bpjagiel/Senior-Design/Concept Sketches/IMG_2075.JPG

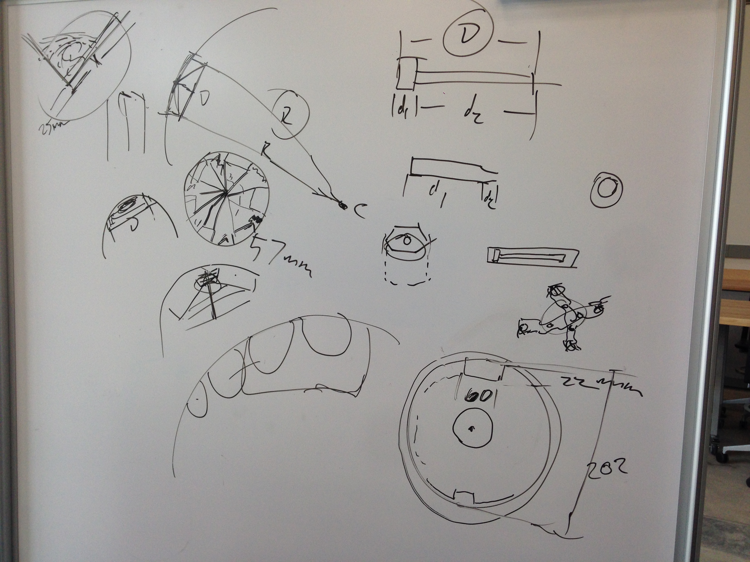
Concept Sketches/IMG_2075.JPG
