bpjagiel/Senior-Design/MechanicalDesigns/SpringCalc4.JPG

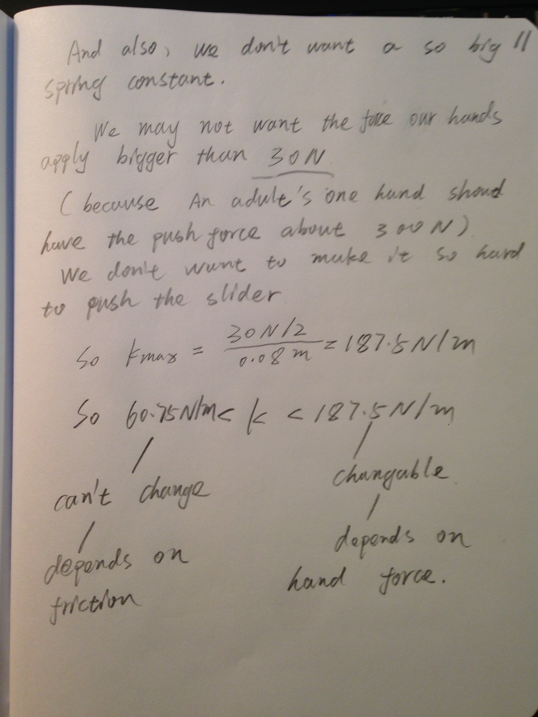
MechanicalDesigns/SpringCalc4.JPG
