bpjagiel/Senior-Design/Proposal_Presentation.pptx

## Design PRoposal

Group 2:
Paul Kruchko
Bryan Jagielo
Michael Laba
Xiaong Tong
Xinfeng Shi
Ran Ao
Monika Shaeff

## The System: An Overview

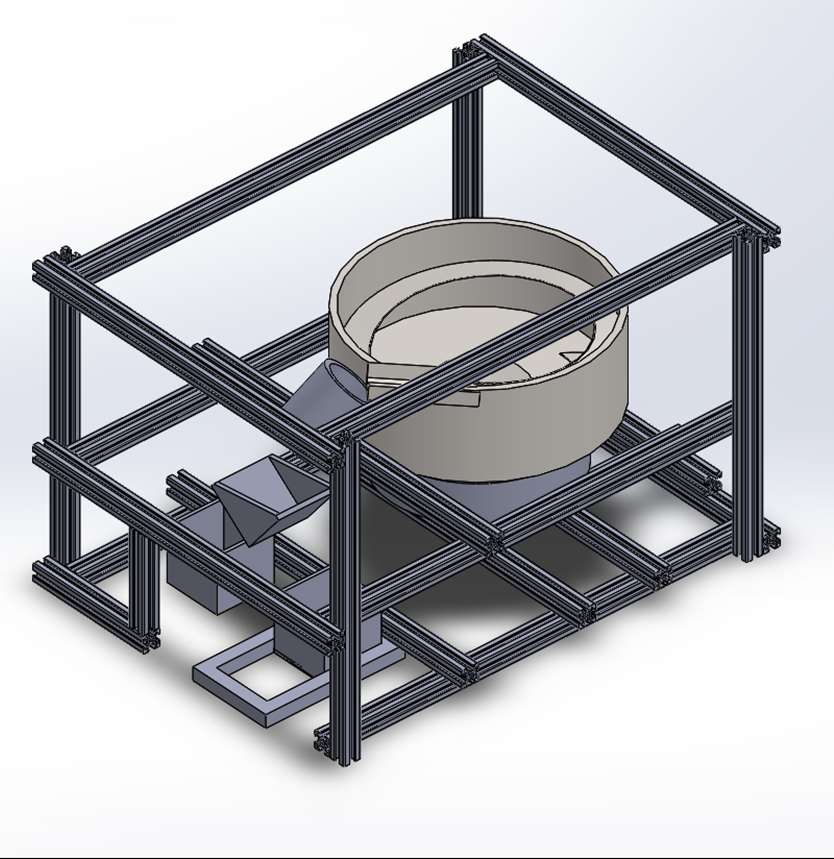
[picture p3: figure]

-> Designed around a vibratory bowl feeder
-> Through Closed-loop, feed-back control dispenses parts through a tube fitted with an array of light-sensors
-> Design inspiration:
http:// (http://www.youtube.com/watch?v=XlfjRkN1ddg)www.youtube.com/watch?v=XlfjRkN1ddg

## The System: An Overview, cont’d

F(s)

IN

Out

Parts

Hopper

Flow Limiter

Organizer

Counter/Velocity and Mass transfer

F(w,i(t))

Transducer

M(t)

Controller

Staging Trough

W,i(t)

Driver

Parts out

Dispenser

## The System: The Model

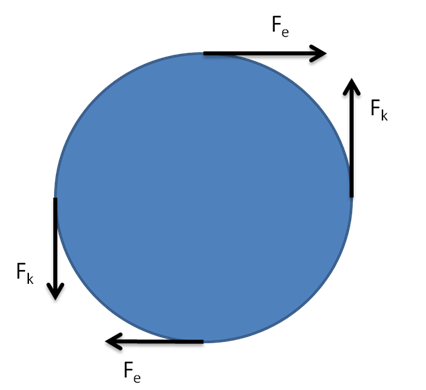
[picture p4: figure]
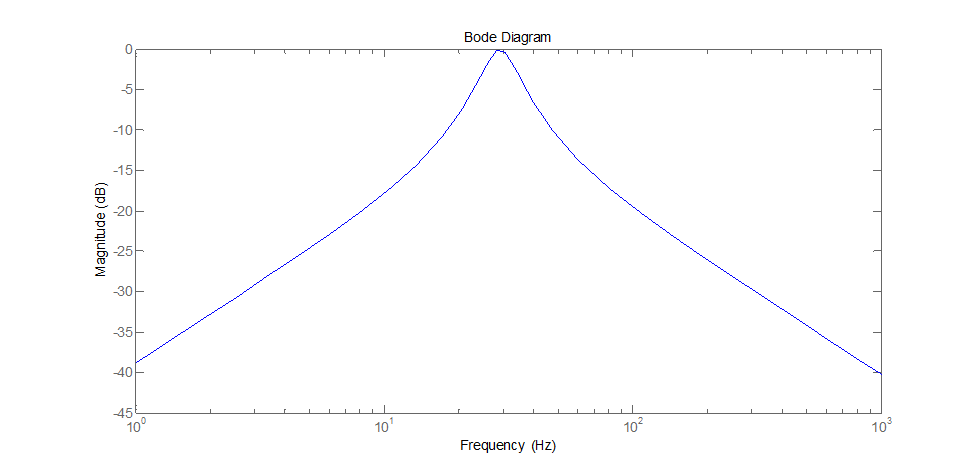
[picture p5: figure]
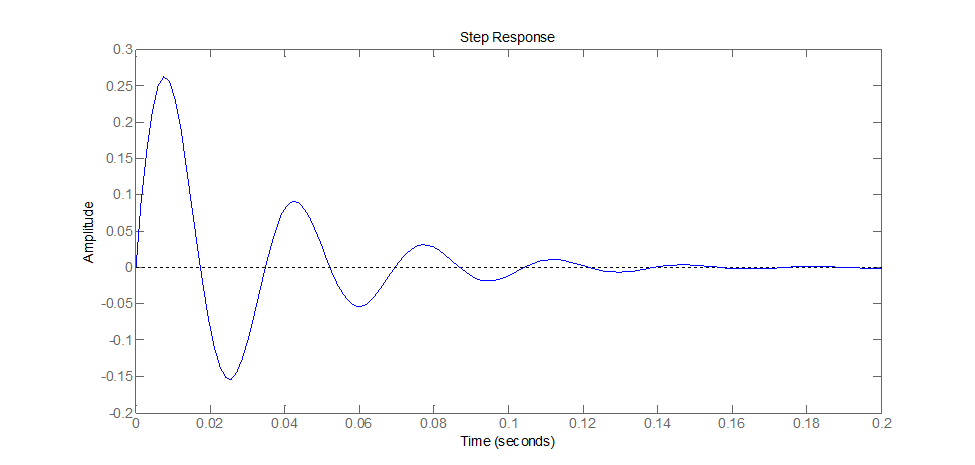
[picture p6: figure]

## The System: Implementation

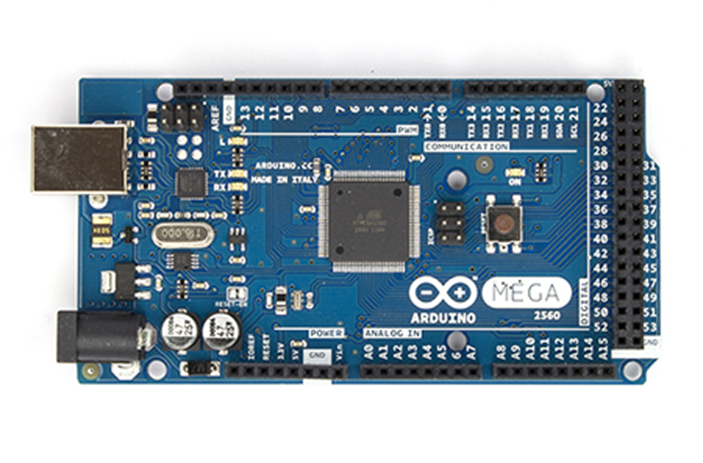
[picture p7: figure]
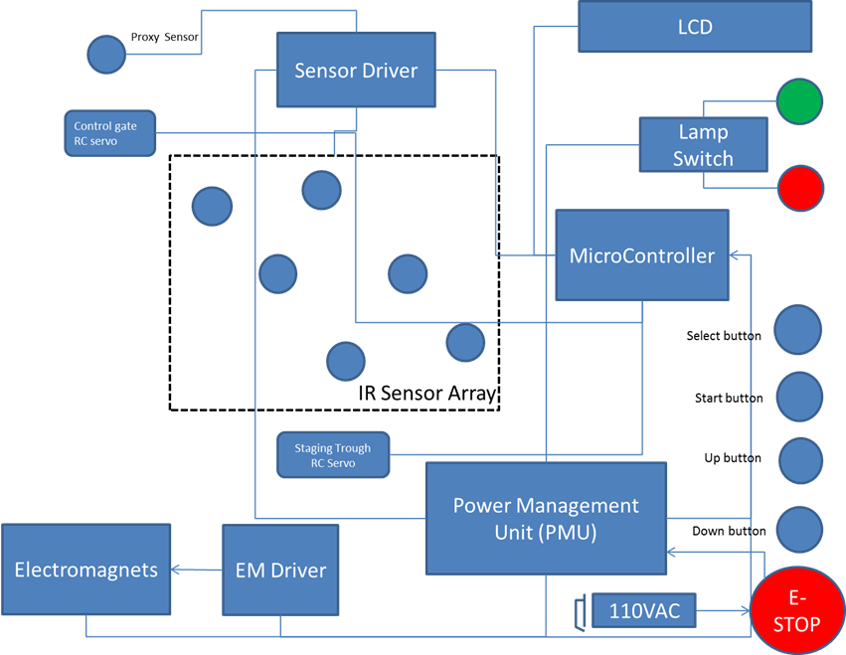
[picture p8: figure]

## Road Map: Projected Timeline

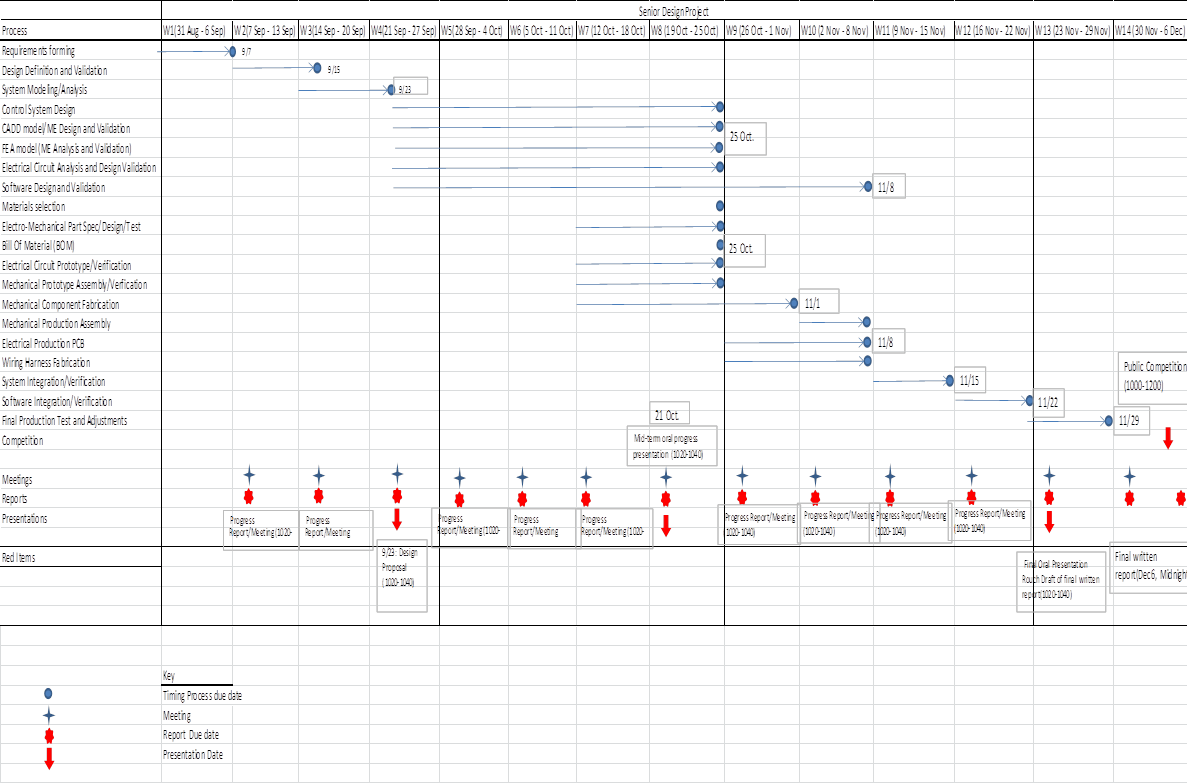
[picture p9: figure]
