bpjagiel/Senior-Design/FinalReport/standard.docx

standard：

1. IEEE Std 295-1969™- Standard for Electrinics Power Transformers

USL:http://ieeexplore.ieee.org/xpl/articleDetails.jsp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

2. IEEE Std 2600™- Standard for PROTECTION PROFILE FOR HARDCOPY DEVICES

URL: http://standards.ieee.org/getieee/2600/download/2600.2-2009.pdf

3. IEEE Std C2-1997- National Elevtric Safety Code(NESC), 1997 edition URL:http://ieeexplore.ieee.org/xpl/articleDetails.jsp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
4. IEEE Std 118-1978- IEEE Standard Test Code for Resistance Measurement USL:http://ieeexplore.ieee.org/xpl/articleDetails.jsp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
5. IEEE Std260.1-2004- IEEE Standard Letter Symbols for Units of Measurement

USL:http://ieeexplore.ieee.org/xpl/articleDetails.jsp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

# 6. IEEE Std 315-1975 - IEEE Standard American National Standard Canadian Standard Graphic Symbols for Electrical and Electronics Diagrams

# USL:http://ieeexplore.ieee.org/xpl/articleDetails.jsp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

# 7. IEEE Std 1138-2009 - IEEE Standard for Testing and Performance for Optical Ground Wire (OPGW) for Use on Electric Utility Power Lines

# USL:http://ieeexplore.ieee.org/xpl/articleDetails.jsp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

# 8. IEEE Std 1591.1-2012 - IEEE Standard for Testing and Performance of Hardware for Optical Ground Wire (OPGW)

# USL:http://ieeexplore.ieee.org/xpl/articleDetails.jsp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

# 9. UL Std 13: Standard for Power-Limited Circuit Cables

URL: http://ulstandards.ul.com/standard/?id=13&edition=3&doctype=ulstd

10. UL Std 73: Standard for Motor-Operated Appliances

URL: http://ulstandards.ul.com/standard/?id=73

11. UL Std 61010-1: Safety Requirements for Electrical Equipment for Measurement, Control, and Laboratory Use - Part 1: General Requirements

URL: http://ulstandards.ul.com/standard/?id=61010-1
