bpjagiel/Senior-Design/FinalReport/ME 492 Group2-1.docx

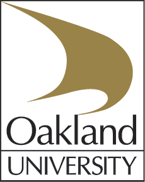
[picture p30: figure]
OU

ME 492/ECE491 – Senior Design

Group 2 - winter 2014

Final Design Report

Project Title:

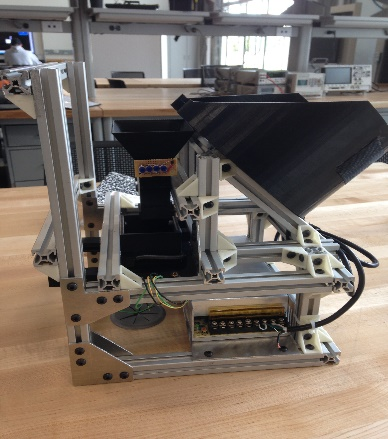
[picture p31: figure]

Professor: Dr. Latcha, Dr. Gu

Team Members: Paul Kruchko (EE), Michael Laba (ME), Bryan Jagielo (EE/CE), Xiaoang Tong (EE), Monika Shaeff (CE), Ran Ao (ME), Xinfeng Shi (ME)

Table of Contents:

1) Introduction….......................................................................................................................
2) Design Specifications...........................................................................................................
3) Design Overview….........................................................................................................
4) Mechanical Subsystem…..........................................................................................
5) Electrical/Electronic Subsystem……...................................................................................
6) Computer/Software Subsystem ……...............................................................................
7) Discussion……................................................................................................................
  a) Technical Discussion
  b) Professional and Societal Context
    i) Engineering Standards
    ii) Safety
    iii) Economic factors
    iv) Reliability
    v) Aesthetics
    vi) Potential customers
    vii) Societal impact
  c) Information Literacy
8) Conclusions and Recommendations
9) References
10) Appendices

Introduction:

  a. Description of the project challenge

The chanllenge was to produce a machine that could be used on an assembly line. The machine would be useful by helping workers count out small fasteners or parts to be assembled as the main assembly passes by on the line. The machine would be able to provide the correct number of parts each time the line worker request it. This would eliminate workers counting by hand and either coming up short on their count or taking too many parts. Extra parts tend to be discarded on the floor which is both a waste of materials and a safety hazard.

  b. Brief description of the design solution to the project challenge

The solution that we have come up with is a case feeder design that uses a bowl to hold the main part population. Inside the bowl a disk with inserts will take each part one at a time to the top of the bowl and dispense it down a funnel. The funnel is lined with sensors that will count the parts as they fall into the presentation bin. The presentation bin holds the parts until the count goal is achieved. From here the operator pushes on the slider just under the bin. This allows the parts to drop into the operator’s hand. This is how we intend to distribute our parts.

Design Specifications:

The system that Group 2 proposes is a closed-loop, feed-back, electronically controlled rotating part feeder that agitates, actuates, and organizes a set of homogenous hardware components that are to be counted and dispensed into the awaiting hands of the operator/user. There are basically four subsystems in the mechanical design: screening subsystem, transportation and detecting subsystem, dispensing subsystem, and supporting frame subsystem.

Basically, the hopper bowl, the disk, the inserts make up the whole screening subsystem. They are all printed by 3D printer to ensure high accuracy of the size. Instead of printing six different disks, different kinds of disk inserts are used to save materials. And also the bowl inserts are used to fit different parts. The hopper bowl was designed according to the total volume of the largest parts to make sure it’s big enough to hold any six kinds of materials. The diameter of the bowl was decided by the diameter of the plate (200mm), which is decided by the length of the materials. All the materials will be put into this gradient hopper bowl, and the plate at the bottom of the bowl will begin to rotate driven by the motor, and also the agitators will begin to stir the parts. The parts inside the bowl will fall into inserts under the influence of gravity and the agitation. When the single part is rotated onto the higher side of the plate, all the parts will drop through the gap one by one, and here the singulation of the parts are completed.

For the transportation subsystem, there is a funnel with sensor inside it. The parts will drop into a funnel one by one, and the eight pairs of IR sensor on two levels can count the part that goes through. When it count to the quantity the user needed, the feedback control will apply to stop the motor. The upper size of the funnel is bigger than the lower size to avoid getting stuck, and also the slop is smooth enough. According to the parts quantity the user need, there will be a motor speed control to speed up the rotation or slow it down. This control will make sure we can transport enough parts in a certain time. After careful examination of the system’s static and dynamic characteristics it was determined that a motor with a minimum torque output of 20oz.-in. would be sufficient. Given that the there is considerable torque loss in the shaft of any given motor (~10%) and the need to both observe and control the speed of the motor it was determined that the 131:1 gear motor offered by Pololu was a desirable material solution for the motoring needs of the system. This motor offers 250 in-oz. of torque at 80 rpm, giving a safety factor of 12.5 and an encoder resolution of 64 counts per revolution, creating enough sample for an adequate velocity measurement. Control can be performed by implementing a PID controller in software on the microcontroller to control velocity output for desired velocity state or an integrated motor controller can be purchased that controls the motor with only a simple command from the microcontroller controlling the rest of the system. Given allocated memory and system response time it might be desired to control the motor using a motor controller.

For the dispensing subsystem, there is a push slider and a presentation. After we get the right number of parts, the motor will stop rotating and the certain parts will be inside of the dispenser. Two springs with proper spring constant are on the dispenser, which can make it go back to the original position after the user push and get the parts.

For the supporting frame subsystem, the frames are utilized to hold up all the mechanical and electronic components. The cross section of the frame is 20mm×20mm, and the material is aluminum alloy to ensure that it’s strong enough to make the whole setup steady. The frames are fixed together by the joints, which are printed by 3D printer.

Design overview

In order to discribe the overview of the mechancical system. We first looked at existing machines in industry and broke down what made them successful.

After examining a few machines we came to up with the following flow chart which each part followed in order to be acuratly organized, counted and moved from a major parts group. We would encorporate the same ideas into our design in order to make it successful

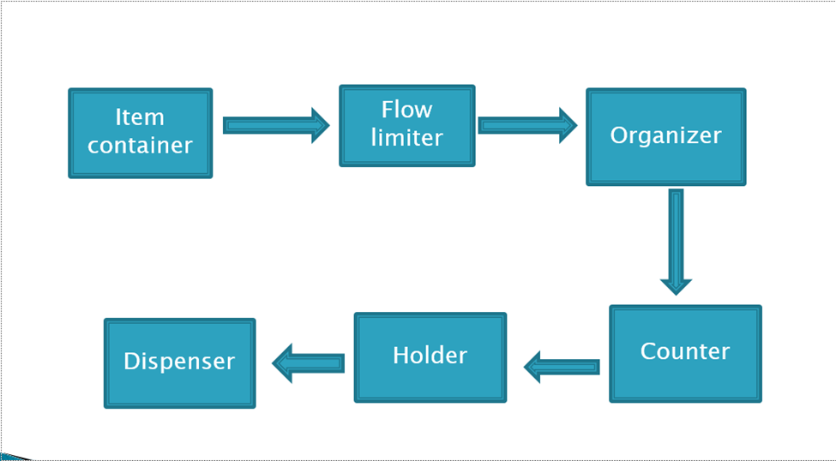
[picture p32: figure]

As seen in the above flowchart, the main population had to be first contained. Then the machine had to have some way of initiating the parts to move. Most machines used motors or agitators to create a mass flow from the major population of parts in the machine. The parts then are organized by geometry and orientation from the main material flow. Any part that did not match the orientation or the requested geometric restraints, was rejected back to the major population. This allows for a controlled flow of parts to feed one at a time into the counter. As parts move past the counter, the machine keeps track of how many are going to be dispensed, what the count is and how many parts are left in the bowl. The parts then move to a holder. In the holder, orientation may or may not matter depending on if orientation needs to be held for later processes. In our case we did not need to hold any particular orientation as long as all the parts where contained in the holder. The holders main job is to hold the current count of parts to be dispensed. This is to ensure that the operator is to get all the parts at once out of the dispenser, instead of parts coming out one at a time. The final piece is the dispenser itself. Each machine needed a way of presenting or releasing the held parts to the operator.

We needed to control aspects of the mechanical side, so we made a second chart that would work with the mechanical flow to ensure control to the machine.

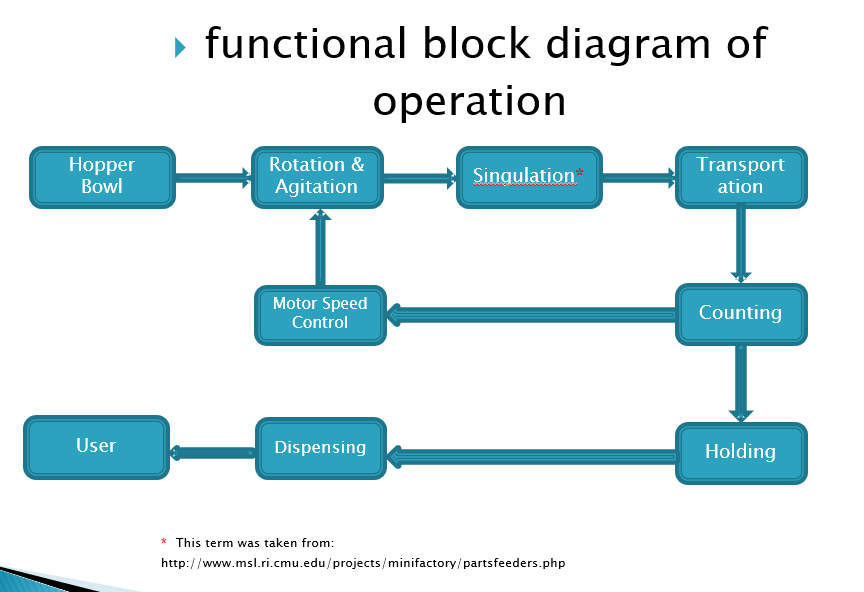
[picture p33: figure]

Each section in the diagram above was a strategy used in controlling the number of parts and part flow within the machine. The microcontroller would have feedback from sensors in the funnel and dispensing bin to control the motor speed and ultimately the part flow within the machine. This would mean that we could control the on time delivery of each count, know how many parts have been dispensed, how many parts are in the machine, and most importantly, how many parts are in the count. The microcontroller would have the ability to do the following: allow for user to select part type, count, control motor speed, keep track of parts in the machine, alert the operator when the parts are ready to dispense and start the count again after the operator retrieves the parts.

Mechanical Subsystem:

The mechanical subsystem is all pieces or parts of the machine that provide support or function to the machine. Each part of the machine had to be selected or made with both function and the ability to be assembled in mind.

Our first Idea came from industry as a vibration bowl. The idea was that the bowl would be agitatied and acutated such that parts would pushed by friction and solenoid, around the bowl and up a spiral ramp. While moving to the top of the bowl, we could use limiters to orient the parts as they formed a single file line. We quickly realized that the amount of calculations to achieve the forces needed to vibrate the parts would be very difficult.

After more research, we considered two more Ideas. One used conveyor belts and limiters for part flow and the other used a set of rotating disks with slots to pick up parts one at a time and dispense them at the top of the bowl. We chose the case feeder design with the bowl and disk, due to it being less complex, having components that could be easily calculated and we that the fabrication would not be too difficult.

To hold the main population of parts on the disk and agitator, we knew our bowl had to have a volume that would hold the largest part volume but not completely fill the bowl. We also knew that the bowl would have to be able to move the longest screw. These dimentions influenced both our bowl size and slot dimentions at the top of the bowl and on the disks.

Originally we had hoped that we could print the bowl as one piece and the first bowl contained more ABS than what was nessasary. A 3-D printer was expected to be used to make the bowl to ensure persision and because the printer would be able to fabricate our shape and eliminate extra fabrication processes with some other materials. The only thing the printer needs is material which is where the cost for making the parts is incurred. We first tried to eliminate some of the ABS material from the bowl by making the motor hole in the bowl wider. This changed or original plan to mount the motor directly to the bowl which would have made centering the motor shaft and assembly easier. We still had a high ABS volume for the bowl, so to reduce the volume.

During the mechanical process, we have utilized 3D printer for printing some of the major components of the machine. The material of these components is ABS, and the friction factor between ABS is 0.1. The tolerance of the printer is 0.2mm, so we need to consider the tolerance when designing the size of the components.

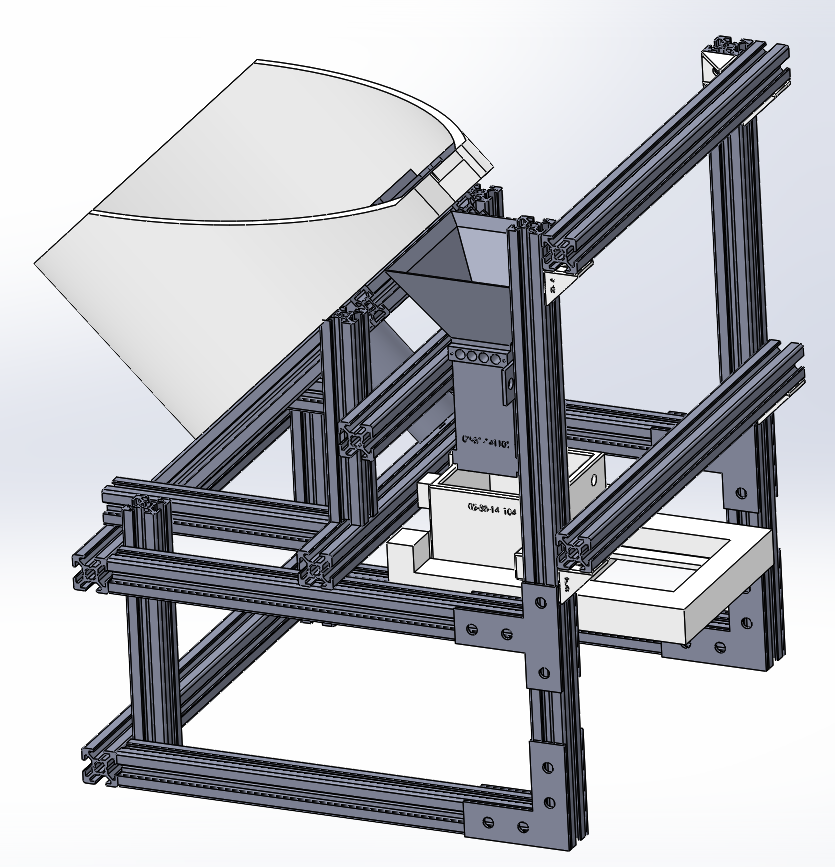
[picture p34: figure]

Figure 1. Built Machine Figure 2. Finalized CAD Model of Machine Concept

Our finalized machine design is shown above in figure 1 and 2. As shown above, about fifty unorganized parts will be dropped into the bowl. The motor that is fixed on the frame will rotate a wheel inside the bowl. Depends on the types of the parts, different wheel and different inserts of the bowl will be utilized. The unorganized parts will be rotated into the gaps of the wheel, and sent to the top of the bowl. Then they will drop into the funnel through a big gap on the top of the bowl. There will be eight pairs of IR sensors, which attached on the side of the funnel, waiting for detecting the number and speed of the parts. After controlling the speed and the number of the parts, the rotating process will stop, and the correct number of parts will drop into the presentation bin. The waiting hand can easily push the slider that underneath the presentation bin, and receive the parts when the machine is ready.

The size of the total design including both mechanical and the electronical stuff is 270mm×300mm×350mm . Because we fixed everything together on the stable frame by proper size of screws and nuts, the whole machine is easy to carry and move.

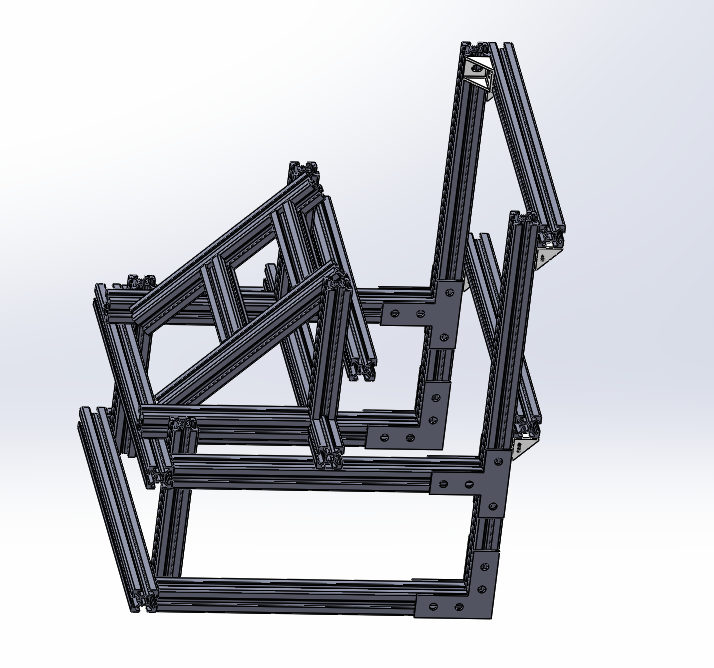
[picture p35: figure]

Figure 3. The Supporting Frame for the Total Design

The figure above shows the frame design of our machine. After the roughly drawing the outline of each component, we thought about the method to connect each component. It will be more delicate and easily to use if we can figure out a proper way to hold the whole machine. According to the mechanical and electrical components, we utilize the 8020 Aluminum alloy. It is bought from…. We cut it into different size, and put them together by utilize the proper fastener. Each component is fix one frame by using the nuts and screw. If there is any part that needs to be changed, we can easily change the position, length and angle between the beams, and mount the screw at the proper place that we want.

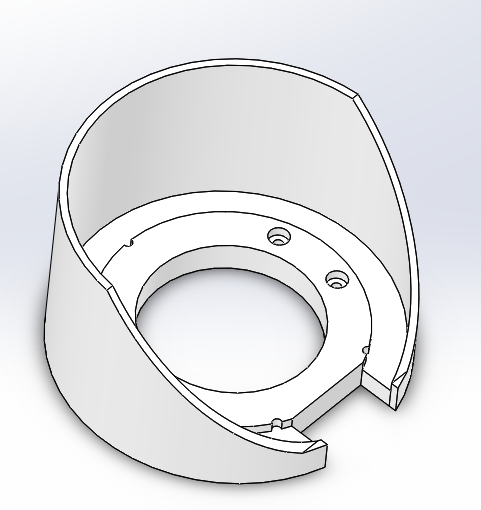
[picture p36: figure]
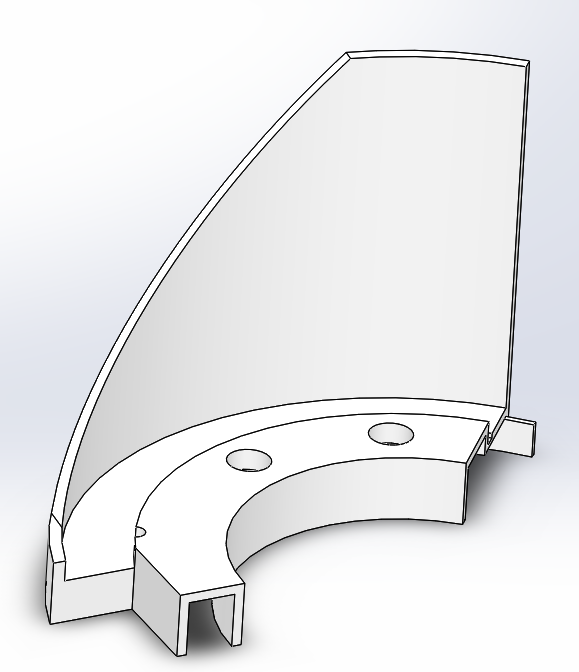
[picture p37: figure]
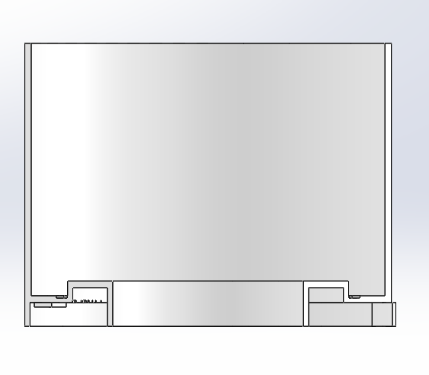
[picture p38: figure]
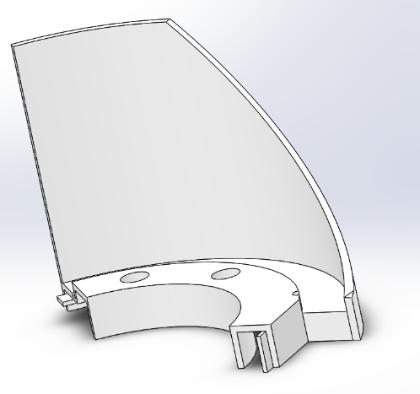
[picture p39: figure]

Figure 3. The Bowl and the Three Divided Parts of the Bowl That Used for Printing.

The figure shown above is the bowl. It is held up on the frame with an angel of 45 degree. The bowl is utilized to hold the bowl inserts, wheels and all the unorganized parts. Also, there is a cuboid gap on the side of the bowl, and the size is big enough for carrying all six types of parts. It allows the parts dropping into the funnel. The internal diameter of the bowl is 202cm, and the thickness of the wall is 4mm. For saving the cost of the bowl, we cut off a lot of material from the bottom. Because the bowl was not in a regular shape, we decided to use 3D printer. The size of the bowl was larger than the capability of the printer, so we printed it by dividing it into three parts. Then the left, center, and right part of the bowl were glued together. The glued bowl was firm during the test, and never tried to break apart.

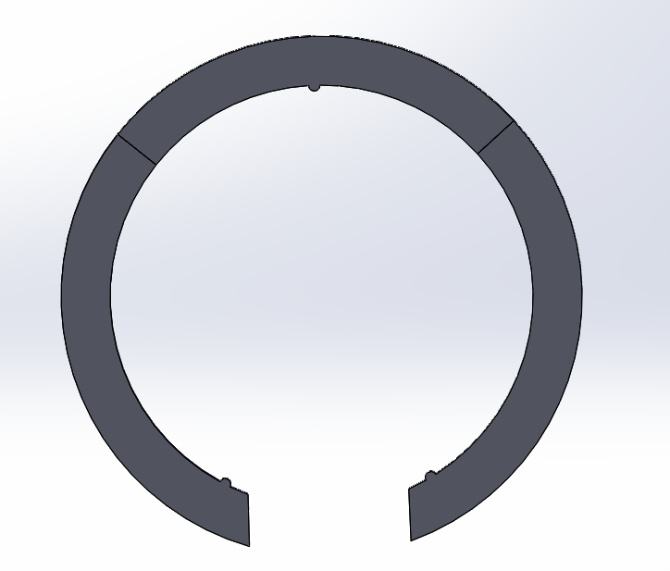
[picture p40: figure]

Figure 4. The Inserts of the Bowl

As shown above, the shape of the bowl inserts is same as the shape of the gap inside the bowl. The three small semi-circle are used to fix the position of the inserts. In this case, the rings will not move randomly inside the boal gap. Because the thickness of six parts are different, we have designed four different thicknesses of the rings including 6mm, 4.5mm, and . Then the thickness of the gap can be changed by easily putting the rings in. The size of the ring is larger than the capability size of the printer. Since we used 3D printer to print ABS material inserts, we divided each one into three part.

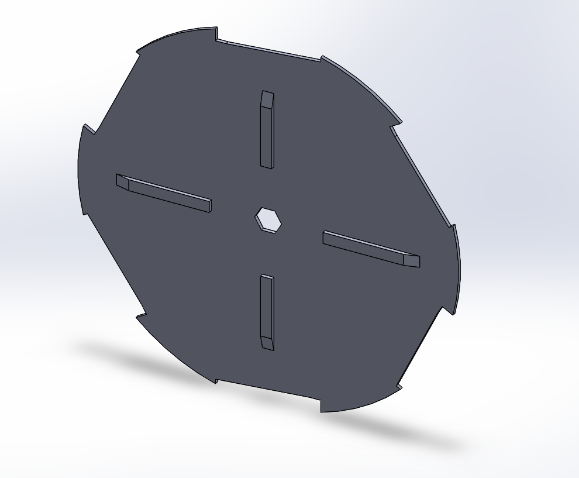
[picture p41: figure]
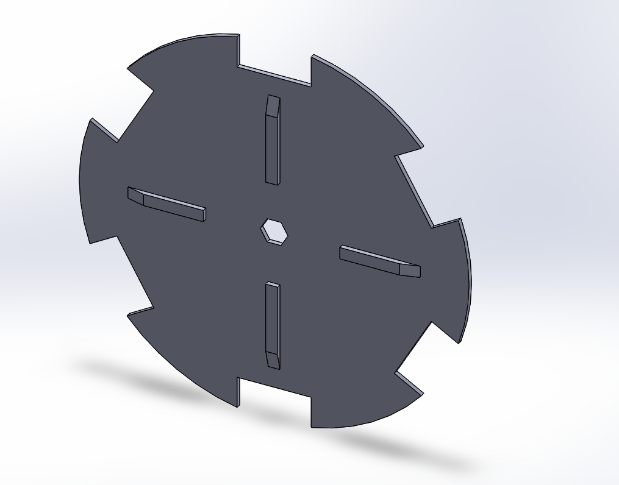
[picture p42: figure]
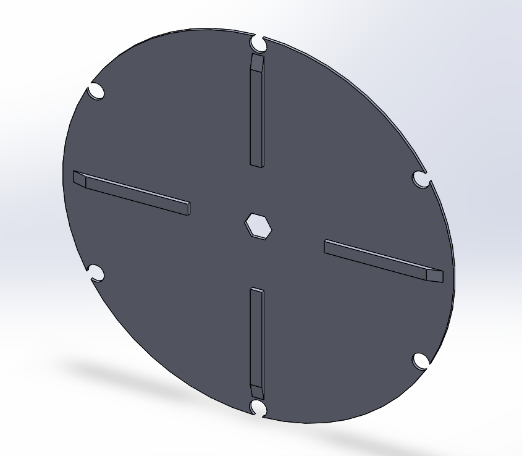
[picture p43: figure]
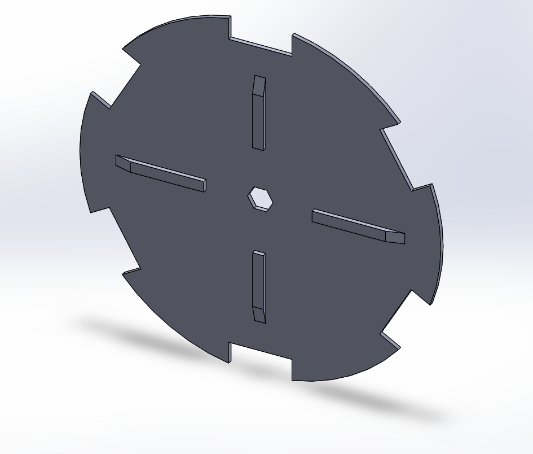
[picture p44: figure]
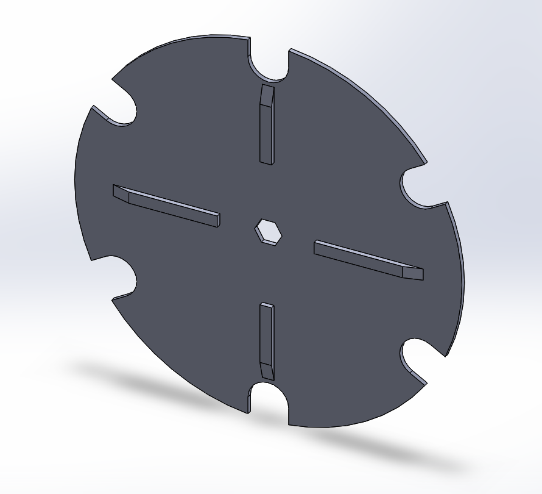
[picture p45: figure]
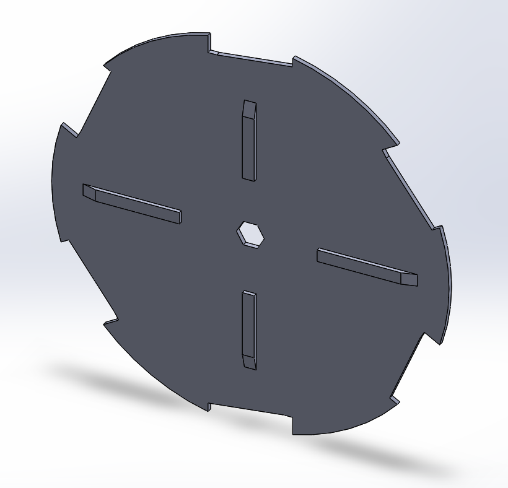
[picture p46: figure]

Figure 5. Six types of wheels

The figure shown above is the wheels for each parts. As we know, there are six kind of parts that might be sorted. The inserts of the bowl can used to change the thickness of the gap, and the wheels can change the outline shape of the parts. Because we don’t need to care about the thickness when designing the wheel, the thickness of the wheels are 2mm. Thus, we save a lot of material by printing the thin wheels. There are four agitators on each of the wheels. It is used to stir the parts. Because there are about fifty parts that need to be organized, it is important to make them apart, and they can easily drop into the gaps. All the six wheels are printed by 3D printer. Also, the shaft will be attached to the middle of the wheel in order to send the power for rotation process.

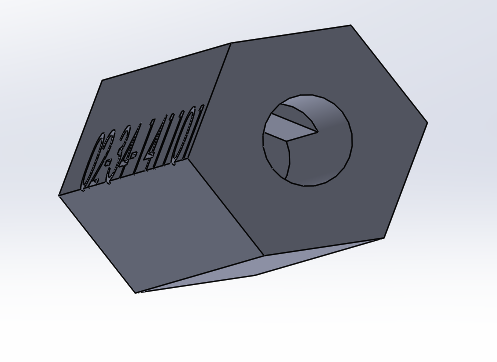
[picture p47: figure]

Figure 6. The shaft

The shaft is used to connect the motor and the wheel. Since the hole of the shaft is designed according to the size of the motor, the motor can easily attached to the hole of the shaft. Then, we super glued the shaft and motor, and the shaft will be more stable. The external shape of the shaft can just fit into the wheel. In this way, the wheel can rotate in the same rotational speed while the motor rotating, and the motor can easily control the rotating process of the wheels. The shaft is built by 3D printing.

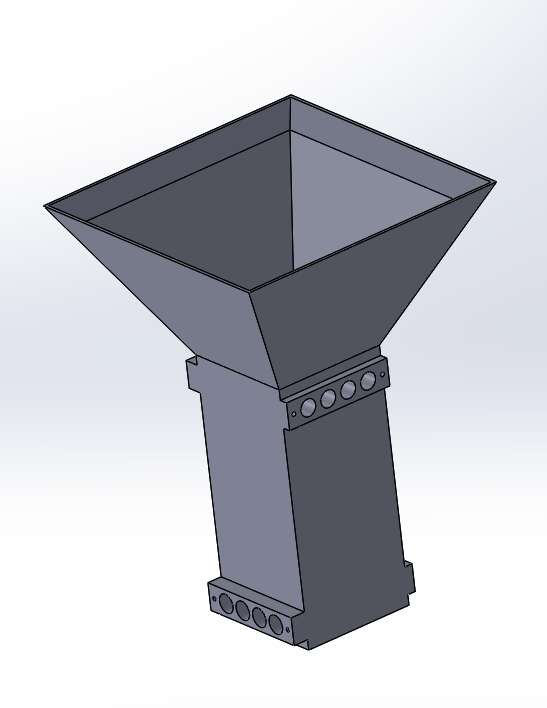
[picture p48: figure]

Figure 7. Funnel

The funnel with IR sensors is an important part to counting the number of the parts. As shown above, the upper part of the funnel is right below the gap of the bowl, and the size of the entrance is enough for all the parts to drop in. Then the parts will be detected by the sensors. Eight pairs of sensors are attached to the hole of the funnel in two level. Once the part is detected, the electronic screen will add the number, and the motor will receive the feedback of the speed. In this case, the motor can better control the speed of machine. In order to cut accurate size of the sensor hole, we printed funnel by 3D printer.

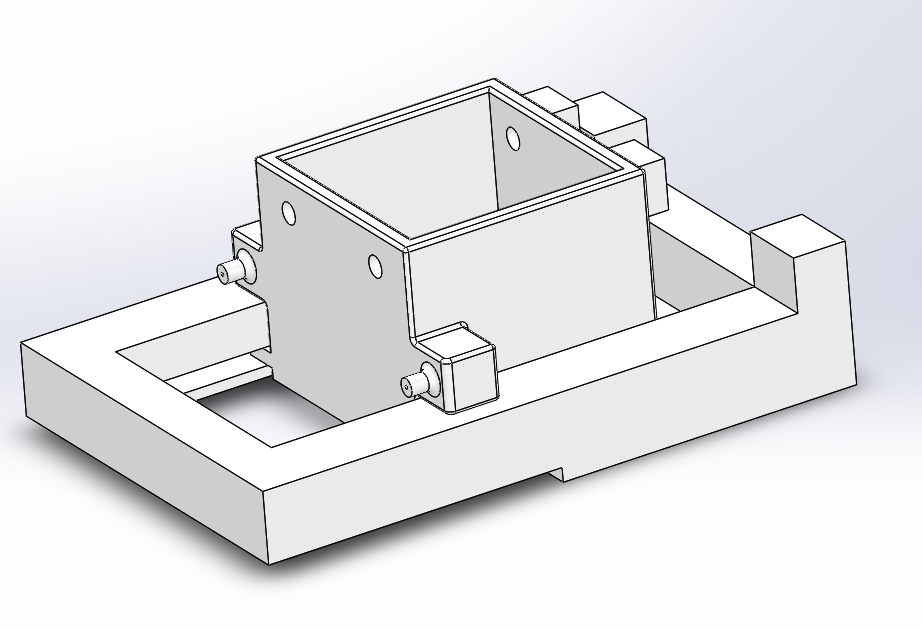
[picture p49: figure]

Figure 8. Presentation bin and push slider

As shown above, the parts will drop into the presentation bin after going through the funnel. When the machine is ready, the machine will stop rotating, and the correct number of parts will be stored in the presentation bin. Then, the awaiting hand can easily push the slider underneath, and receive all the needed parts. Both presentation bin and push slider are made by 3D printer, and the material is ABS plastic. The presentation bin is fixed on the frame, and it holds the slider as while. In order to connect presentation bin and slider, and control the position of the push slider, there are two springs on the each side of the dispenser. In this way, the spring will extend when the push slider is pushed, and the spring can pull the slider back to the normal position when the force disappears.

Electrical Subsystem

Computer Subsystem

Discussion:

Our final design solution is greatly different from our original design. The original design was made with only functionality in mined and did not take into effect cost, assembly, and control of part size on certain components. The original presented design was made crudely to allow for the original ideas to take shape and preform initial testing based off theory or software.

As we analyzed the idea of price and making parts fit together. It was found that making parts that used thin ABS printed parts where cheaper than our original parts. We became more comfortable with working with ABS after we tested the prototyped design for a 90 corner bracket. The idea for this design was altered from working aluminum brackets for sale on the web at Mcmaster-Carr.com or 80/20.com The brackets used gussets to strengthen the joint. Some used multiple screw locations to stiffen the joint and increase contact area. Since our machine weight is ____ pounds, we felt that with multiple applications of a smaller light weight bracket could be used to have high strength with minimal space. We also removed tabs that fit into slotted sections of the 80/20. This allowed us to use our bracket for a wider range of applications including parts on an angle, which the shelf bought brackets would not be able to do.

In order to ensure that this application would work, we tested the bracket design. A small sample of 10 90 corner brackets was printed in order to test the bracket design strength. In order to get an idea on how the bracket might perform, we used FEA from Solidworks. By comparing an FEA with 1N applied to a mounting face and the other mounting face fixed, we could predict the deflection of the part under loading. This could be compared to the test results in order to estimate how the brackets will perform.

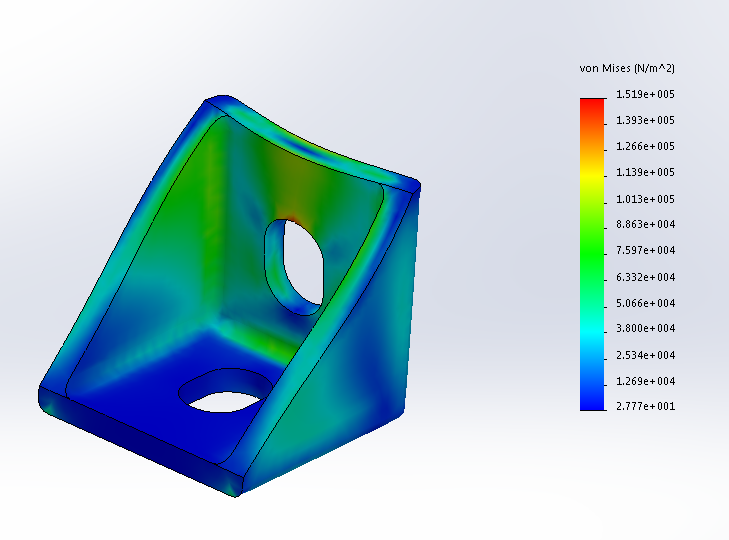
[picture p50: figure]

To conduct the expiremtent, four brackets where secured to a 2x4 using Philips head sheet metal screws. The brackets where up and down in orientation and attached to the edge of the 2x4. The 2x4 was then clamped to a table using a C-clamp to prevent it from moving off the table. By two hooks and string, weight was applied to each of the brackets. The weights had known measurement labels. This test did not need to be very precise, due to the predicted weight that one bracket was to lift was appoximently 5 lbs. The test was stopped at 22 lbs because the part was deformed, there was no need to go higher when only 5 lbs was a comfortable working weight of the machine and the design has multiple double brackets applied at the joints.

Group Two 19
