bpjagiel/Senior-Design/Proposal/H-Bridge.docx

To control the torque of the motor, a specific motor driving circuit is necessary. The figure below depicts the schematic for the motor driver circuit. The designed circuit is a N-MOS H-bridge which will allow the motor to be driven in both directions if necessary. Current to the motor can be applied by toggling the microcontroller pins connected to the four respective MOSFETs. Furthermore, a pulse width modulated signal can change the amount of power sourced to the motor which will change its respective torque. The circuit also contains protection diodes that will prevent the MOSFETs from receiving back current produced by the motor when the transistors are abruptly switched to stop the current. Using this circuit in conjunction with the control system detailed in a separate section will allow for precise control of the system.

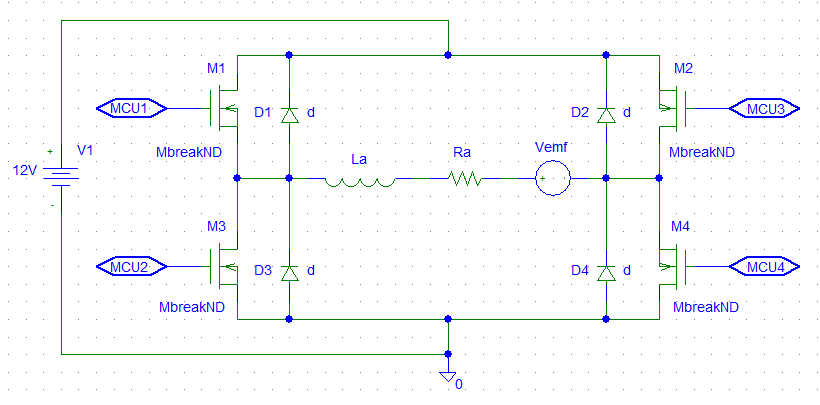
[picture p69: figure]
