bpjagiel/Senior-Design/Proposal/systemdynamicsEQ.docx

To control the angular speed of the plate in the bowl, the physics of the system can be modeled and a control system can be implemented. Analyzing the rotation of the plate about the axis of the rotor of the DC servo motor, the equation of motion can be actualized as the sum of torques written as follows:

∑ τ=Jθ

where J is the moment of inertia of the plate and parts system and θ is the angular acceleration. Recognizing that the torques acting on the plate consist of the input torque, τ_m , from the electric motor and the viscous friction between the plate and the bowl, τ_f , the equation of motion can be rewritten to contain these terms. The equation of motion now reflects the following expression:

τ_m -τ_f =Jθ

The viscous friction term can be expressed as:

τ_f =bθ

where b is the viscous friction coefficient and θ is the angular velocity. Substituting the expression for viscous friction, the equation of motion can be rewritten again as followed:

τ_e -bθ=Jθ

To prepare the equation of motion for modeling in MATLAB, the equation can be rearranged to solve for the angular velocity. Rearranging yields the expression:

θ=1/Jτ_e -b/Jθ

With the equation of motion in the form necessary for state space representation, the state space variables can be declared as follows:

x_1 =θ , x_2 =θ , u=τ_e , y=θ

Using these state space variables, the state space representation can be determined. The state space matrices can be written accordingly:

[x_1 x_2 ]=[0, 10, -b/J][x_1 x_2 ]+[01/J][u]

[y]=[0, 1][x_1 x_2 ]

As can be noticed from these expressions, the input will be the torque from the motor and the output will be the angular velocity of the plate. The torque from the motor can be adjusted using pulse width modulation and the motor driver circuit described in detail in a separate section. The angular velocity of the plate will be monitoring using a rotary encoder and will provide effective feedback to the system.

In addition to modeling the physics of the system, an appropriate control system can be developed to control the DC servo motor. Below, the independent DC servo motor controller will be implemented to ensure the motor will produce the desired torque in order to maintain the optimal angular velocity for the plate.

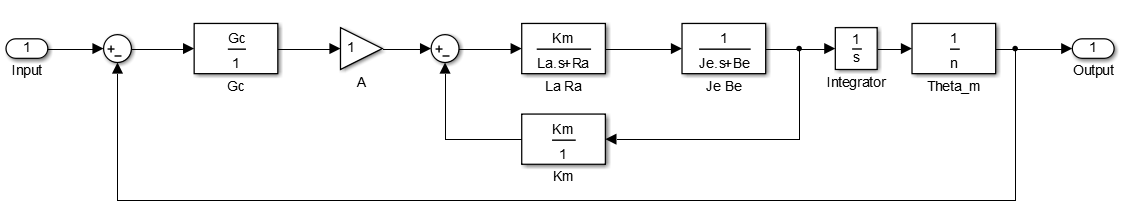
[picture p76: figure]

The control system will need the appropriate constants for the motor. In particular the armature resistance, R_a , and armature inductance, L_a , and motor constants, J_e and B_e will be measured or obtained from the selected motor’s data sheet. As a result, fine tuned control of the motor and rotating plate will be achieved for precise delivery of the desired quantity of parts in the appropriate time window.
