bpjagiel/Senior-Design/Software/PinOut.pptx

BUTTONS

LCD

SENSORS

STATUS LEDS

MOTOR DRIVER

DISPENSE SENSOR
