bpjagiel/Senior-Design/Motor/MotorModelDerivation.docx

Base equation of rotational motion:

τ_e -τ_b -τ_J -τ_L =0

τ_e =k_t i_a

τ_b =bω

τ_J =Jω

Note: To translate the motor torque, viscous friction coefficient, and rotor moment of inertia, these terms must be multiplied by the gear ratio.

Exact equation of rotational motion:

k_t i_a -b_e ω-J_e ω-τ_L =0

Solving for ω :

ω=(k_t)/(J_e)i_a -(b_e)/(J_e)ω-1/(J_e)τ_L

Base equation of electrical circuit:

V_a -V_(R_a) -V_(L_a) -V_c =0

V_(R_a) =i_a R_a

V_(L_a) =L_a i_a

V_c =k_v ω

Exact equation of electrical circuit:

V_a -i_a R_a -L_a i_a -k_v ω=0

Solving for i_a :

i_a =-i_a (R_a)/(L_a)-(k_v)/(L_a)ω+1/(L_a)V_a

Recap:

We have the two equations solved for i_a and ω :

i_a =-i_a (R_a)/(L_a)-(k_v)/(L_a)ω+1/(L_a)V_a

ω=(k_t)/(J_e)i_a -(b_e)/(J_e)ω-1/(J_e)τ_L

We can select the state space vectors as the following:

x=[i_a ω] , u=[V_a τ_L ]

We can write the state space equations as the following:

x=[-(R_a)/(L_a), -(k_v)/(L_a)(k_t)/(J_e), -(b_e)/(J_e)]x+[1/(L_a), 00, -1/(J_e)]u

y=[0, 1]x+[0, 0]u

Inputting this model yields the following response to a 6V input voltage and a 0.14136 Nm load torque due to friction:

The top plot represents current versus time while the bottom represents angular velocity (in rad/s) of the plate versus time.

Since we will power the motor with a pulse width modulated signal, a constant gain will be used to link the duty cycle with the equivalent DC voltage of the signal. To validate this assumption, the model was simulated with a 12V, 50% duty cycle input signal, which would have the same equivalent voltage as above.

The top plot is current versus time while the bottom plot is angular velocity (in rad/sec) of the plate versus time. As can be seen, the pulse width modulated signal produced approximately the same steady state angular velocity as the constant 6V signal.

After implementing the PWM block, we can also implement a PID speed control to achieve speed control. The final control system would look like below:

Where the input is the desired angular velocity and the output is angular velocity both in (rad/sec). A simulation of the system is below:
