bpjagiel/Senior-Design/WeeklyStatusUpdates/Week6.pptx

## Group 2 Project Update: Week 6

Paul Kruchko-Project Manager
Mike Laba-ME Design Lead
Bryan Jagielo-EE Design Lead

Group2

## ME Design Status

- Simulation: Correct motion with 5 fasteners
- Initiated FEA for dispense box
- 4 of 6 actuator plates finished
- Machine frame design complete
- Initiated mounting considerations of electrical components and motor
- Constant for return springs of slide-dispense mechanism determined to between 60.75 and 187.5 N/m

## ME Design TODO

- Full motion simulation study with 50 pieces of every type of fastener to be dispensed (6 simulations for 6 fastener types)
  - Who: Mike
  - When: Complete by Sunday, 12 Oct.
- Finish FEA of dispense box & slide mechanism
  - Who: Mike
  - When: Complete by Sunday, 19 Oct.
- Exact P/Ns and quantity needed for 80/20 machine frame hardware given to Project Manager
  - Who: Mike & Audrey
  - When: Complete by Sunday, 12 Oct.

## ME Design TODO, cont’d

- Total baseline volume of ABS material needed
  - Who: Mike & Audrey
  - When: Complete by Sunday,12 Oct.
- More accurate mass moment of inertia for load
  - Who: Steven
  - When: Complete by Sunday, 12 Oct
- Finish last two actuator plates
  - Who: Audrey
  - When: Complete by Thursday, 9 Oct
- Complete HMI panel design
  - Who:

## EE Design Status

- Preliminary Sensor design complete
- Microcontroller purchased, ready for prototyping
- Preliminary code structure complete: State machine

## EE Design TODO

- Finalize motor selection
  - The current motor selection was scrapped in favor of a vendor that was able to give a more complete datasheet with motor specifications and coefficients needed for accurate system model: Pittman.
  - Motor is still comparable to previous selection in regards to torque, speed, and encoder availability
    - Who: Paul
    - When: Complete by 11 Oct

## EE Design TODO, cont’d

- Finalize system model with coefficients and perform MATLAB/Simulink simulations for frequency response, step response, impulse response.
  - Who: Paul & Bryan
  - When: Complete by 12 Oct.
- Finalize motor selection with mechanical mounting specifications for ME team
  - Who: Paul
  - When: Complete by 11 Oct
- Finish Design and Prototype Sensor circuit, present mechanical mounting specifications to ME design team
  - Who: Terry & Monika
  - When: Complete by Sunday, 12 Oct

## EE Design TODO, cont’d

- Selection of push buttons and LCD with prototyping
  - Who: Monika and Terry
  - When: Complete by 19 Oct
- Design and Prototype power supply circuit
  - Who: Paul
  - When: Complete by 25 Oct
- Design digital motor controller to be implemented in code
  - Who: Paul and Bryan
  - When: Complete by 25 Oct

## Project Status Summary

- System development is on schedule. End design phase target is still 25 October
- Initial motion simulations are promising and verify the major function of the gravity assisted design
- Final BOM and purchasing of components and material also on target for 25 October.
