bpjagiel/Senior-Design/ControlSystemAnalysis/SystemModelAnalysis.docx

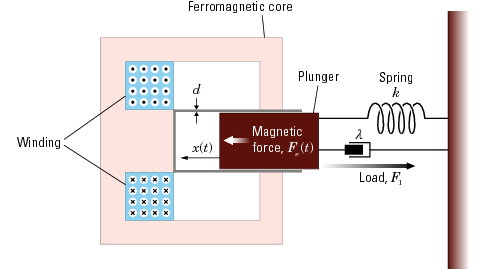
[picture p115: figure]

Equation of motion for the plunger:

F_o +mx+λx+kx=F_e

Since, F_o

Magnetic Force:

F_e =1/2i^2 (∂L(x))/(∂t)

Change in inductance w.r.t. time:

(∂L(x))/(∂t)=(-β)/((α+βx)^2)

Magnetic Force with solenoid constants:

F_e =1/2i^2 (-β)/((α+βx)^2)

The solenoid constants, α and β, can be solved by taking two force and stroke measurements and solving the expression.

The rotational motion of the bowl feeder can be written as the torque:

τ_(out) =Iα

The angular acceleration can be written:

α=x/r

So rewriting yields:

τ_(net) =I/rx

To find the force needed to create this torque on the bowl, the torque can be written as the product of the force and the radius from the axis of rotation:

τ_(net) =rF_o =I/rx

Solving for the force yields:

F_o =I/(r^2)x

Substituting this expression into the overall equation of motion:

I/(r^2)x+mx+λx+kx=F_e

Simplifying:

(I/(r^2)+m)x+λx+kx=F_e

Solving for x :

(I/(r^2)+m)x=F_e -λx-kx

x=1/(I/(r^2)+m)F_e -λ/(I/(r^2)+m)x-k/(I/(r^2)+m)x

Defining state space variables, x_1 ,x_2 and u :

x_1 =x

x_2 =x

u=F_e

Substituting state space variables into equation of motion:

x_2 =1/(I/(r^2)+m)u-λ/(I/(r^2)+m)x_2 -k/(I/(r^2)+m)x_1

[x_1 x_2 ]=[-0, 1k/(I/(r^2)+m), -λ/(I/(r^2)+m)][x_1 x_2 ]+[01/(I/(r^2)+m)][u]

y=[0, 1][x_1 x_2 ]
