bpjagiel/Senior-Design/Group2/Presentations/MidTermPresentation.pptx

## Group 2 Project Presentation: Mid-Term

Group2

Paul Kruchko- EE-Project Manager
Mike Laba-ME Design Lead
Bryan Jagielo-EE Design Lead
Monika Shaeff-CE
Ran Ao – ME
Xiaong Tong – EE
Xinfeng Shi - ME

## Introduction: Our Product

- Rotary Parts Feeder
  - Inspiration for our design: bullet case feeder

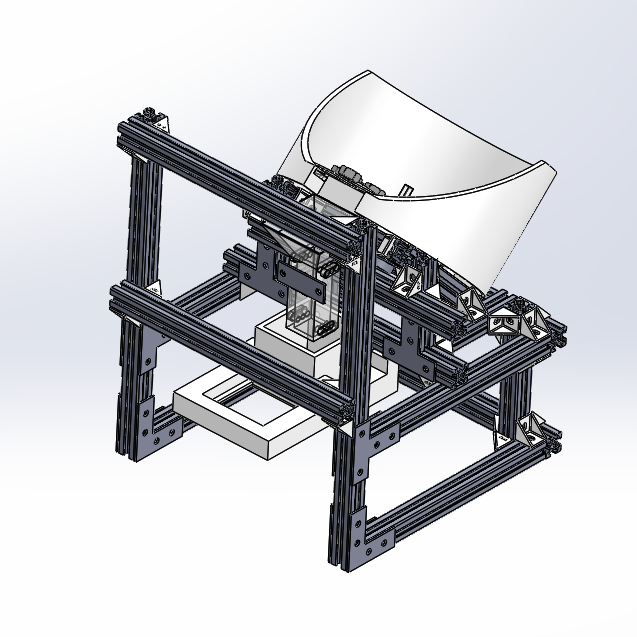
[picture p116: figure]
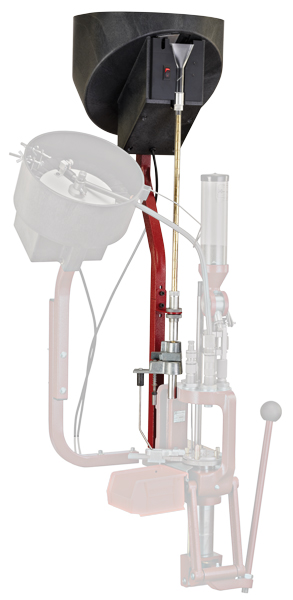
[picture p117: figure]

* Image of Hornady Case Feeder Lock-n-Load ® taken from http://www.hornady.com/store/Case-Feeder-Lock-N-Load-110-Volt/

## Introduction cont’d

- Description: An adaptable small parts dispenser
- Application: A manufacturing or packaging environment
- Motivation: Hundreds to thousands of parts discarded a day.
- Agenda:
  - Early concepts (brainstorming)
  - First Design
  - Re-design
  - Motion simulation
  - System Modeling
  - Motor control simulation
  - Sensor simulation
  - Current status
  - Next steps

## Early Concepts

Item container

Flow limiter

Organizer

Counter

Dispenser

Holder

## Idea about Flow limiter

Width and high limit!

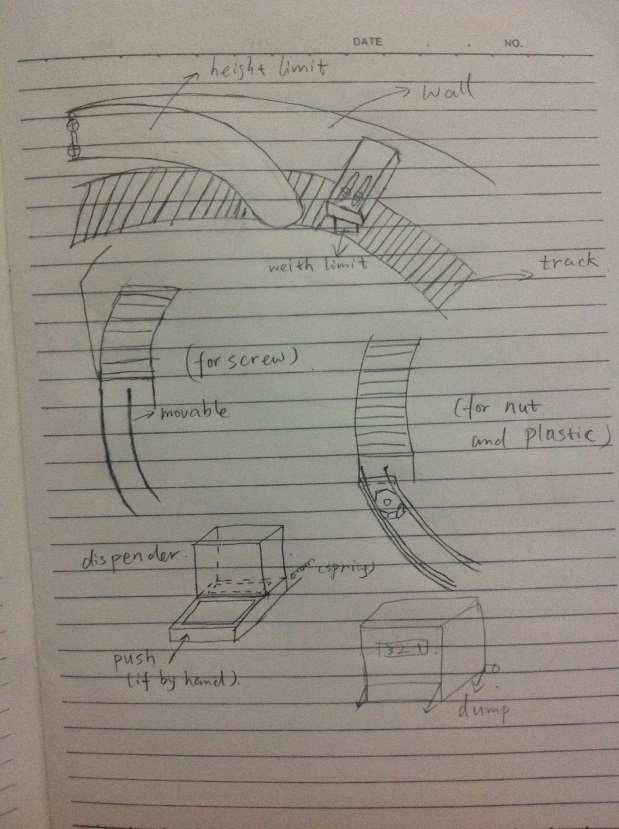
[picture p118: figure]

Speed limit ！

Fluency of track!

## Organizer and Counter

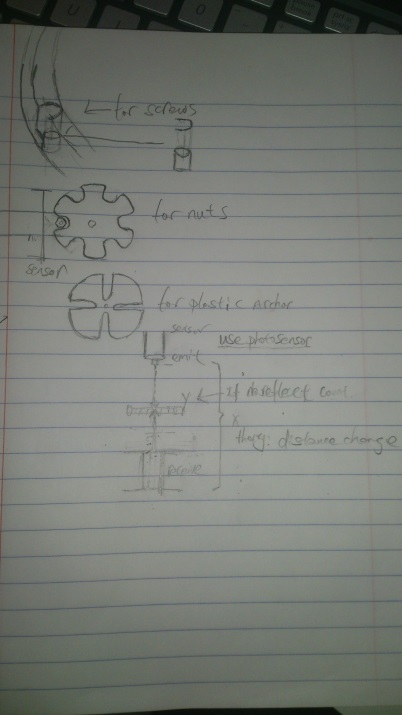
[picture p119: figure]

1. Gears

2. Limit gate

How to count parts
IR sensor? Laser?
Pressure sensor?

## Dispenser

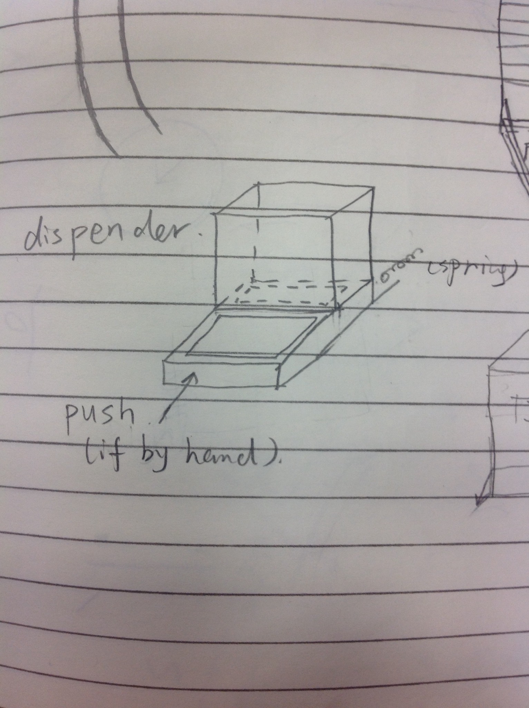
[picture p120: figure]

## First Design: Vibrating Bowl

- Idea From Major Industry.
- Uses Tangential and Normal Forces for Part flow.
- Bowl uses spiral and limiters for orientation.
- Down Stream counting and choosing method.
- Optional Rejection Bin.

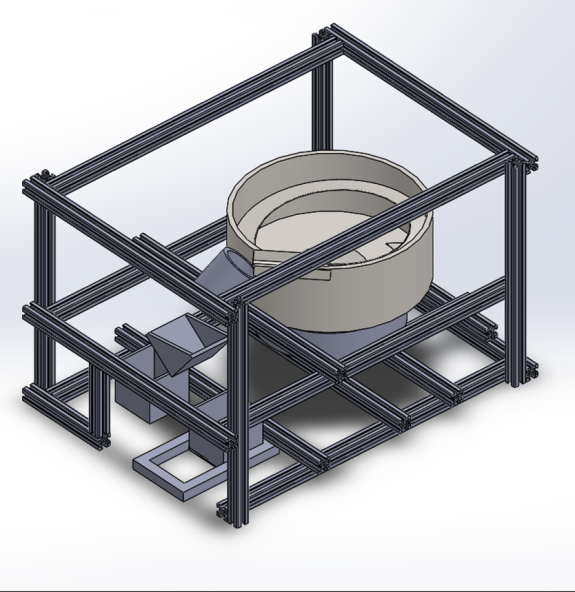
[picture p121: figure]

## Re-design: Rotating Feeder

- The original design was too challenging
- Advantages of new design
  - Cheaper
  - Easier to implement
  - Well defined models
- Disadvantages
  - Opportunity for jams

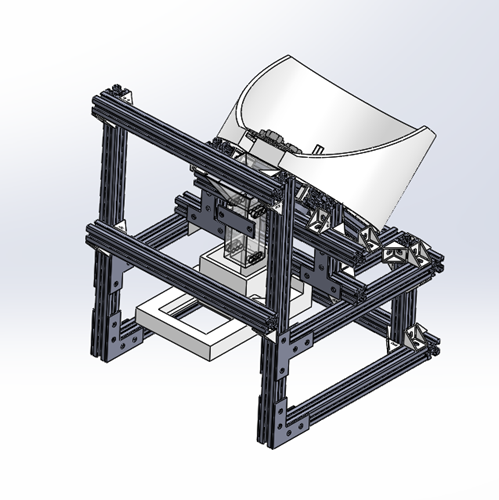
[picture p122: figure]

## Rotating Feeder cont’d

- functional block diagram of
operation

Hopper Bowl

Rotation & Agitation

Singulation*

Transportation

Motor Speed Control

Counting

User

Dispensing

Holding

* This term was taken from: http://www.msl.ri.cmu.edu/projects/minifactory/partsfeeders.php

## Rotating Feeder

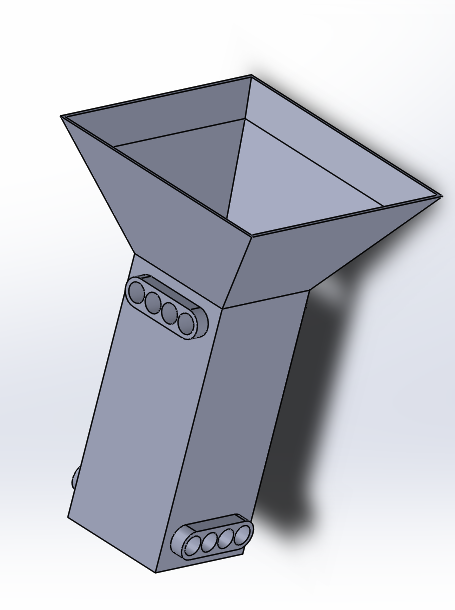
[picture p123: figure]
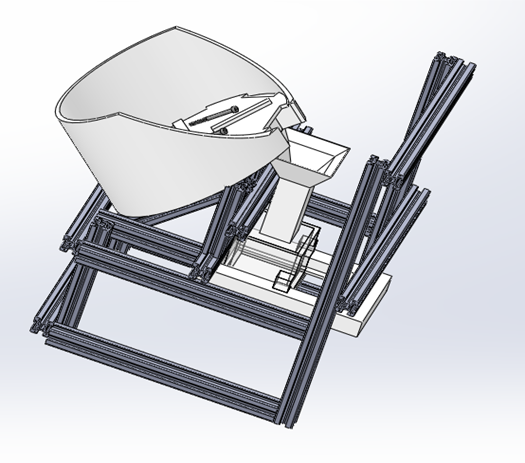
[picture p124: figure]
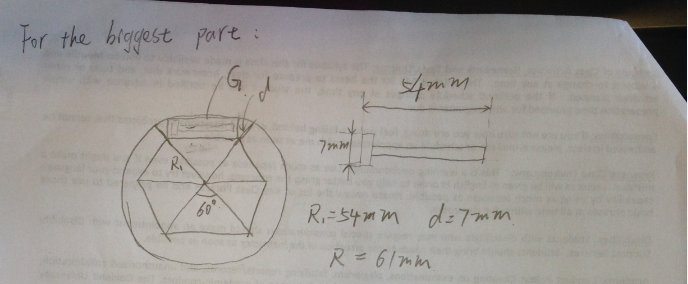
[picture p125: figure]

## Simulation of Rotating Feeder

- Uses contacts to simulate.
- Motor rotating at 20 RPM constantly
- Bolts* are to scale models with threads for thread lock.

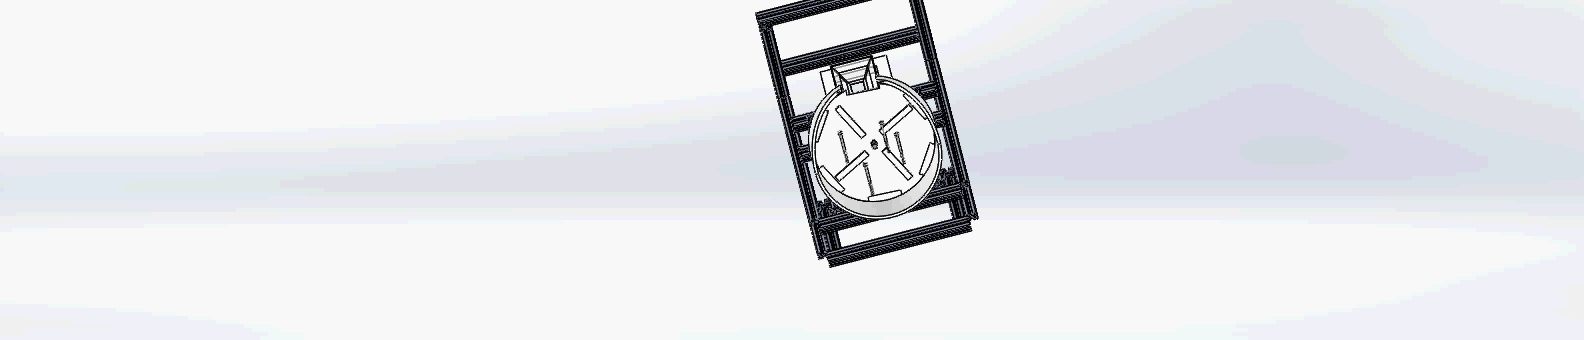
[picture p126: figure]

*CADD model of 4x50mm machine screws taken from McMaster-Carr
http://www.mcmaster.com

Group2

## System Modeling: Motor Model

- Validate motor selection
- Achieve speed control
- Account for variances in load torque

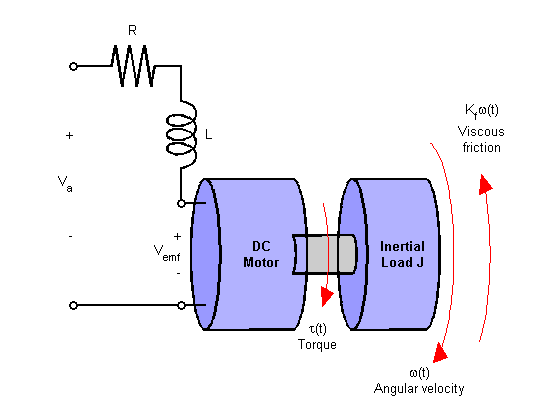
[picture p127: figure]

http://www.mathworks.com/help/control/examples/dc-motor-control.html

## Motor & PID control simulation

- Implemented PID control
- Acceptable overshoot and settle time
- Ready for implementation on MCU

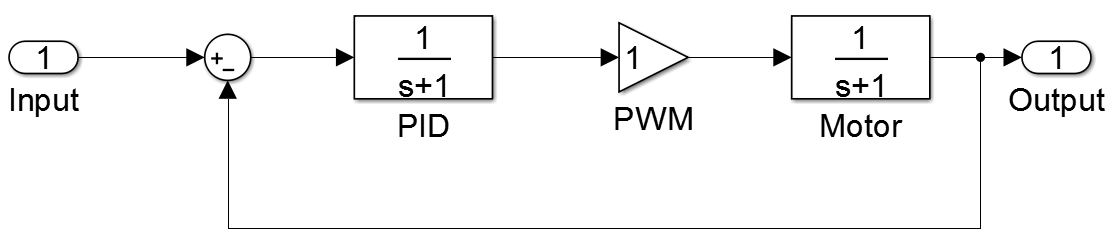
[picture p128: figure]

## Sensor Simulation

- Security
- 8 parallel sensors in 2 levels
- Intensity
- Variable luminance through LED’s resistance adjust
- Accuracy
- 34.51us reflection time of output signal
- Stability
- Few signal noise, less external disturbing

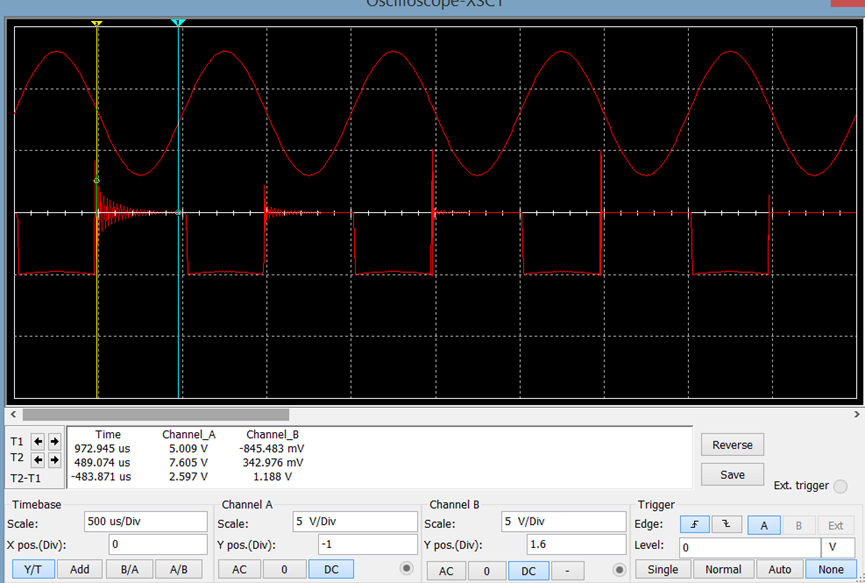
[picture p129: figure]
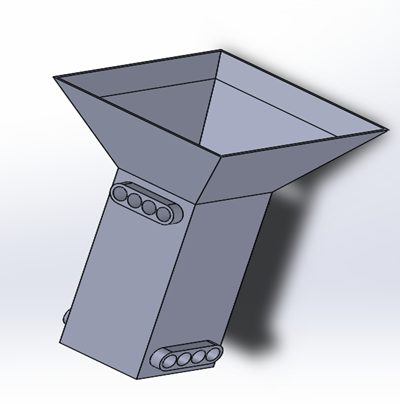
[picture p130: figure]
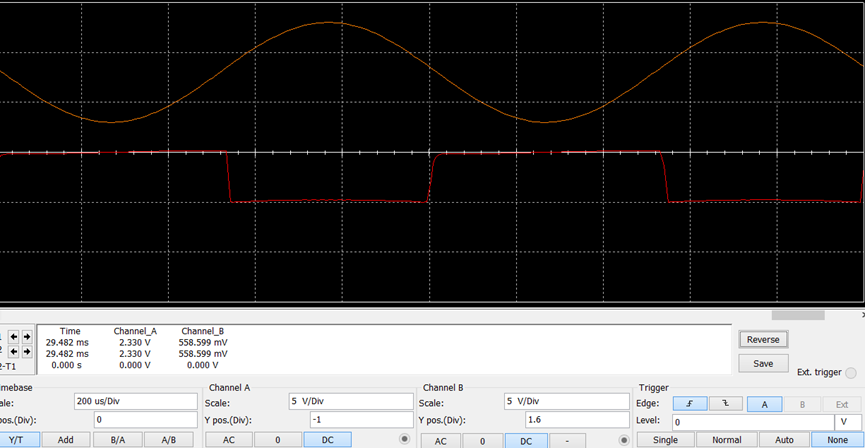
[picture p131: figure]

## Program Flow

## Current Status

- 90% of parts purchased
- Simulation: Correct motion achieved
- full simulation of 5 parts achieved.
- FEA: Initiated for Box
- Control system designed, simulated, ready for implementation

## Next Steps

- Implement PID motor control in code
- Finalize and test code
- Prototype and test circuits
- Mechanically assemble machine
- WIN THE COMPETITION!!!

## Questions?

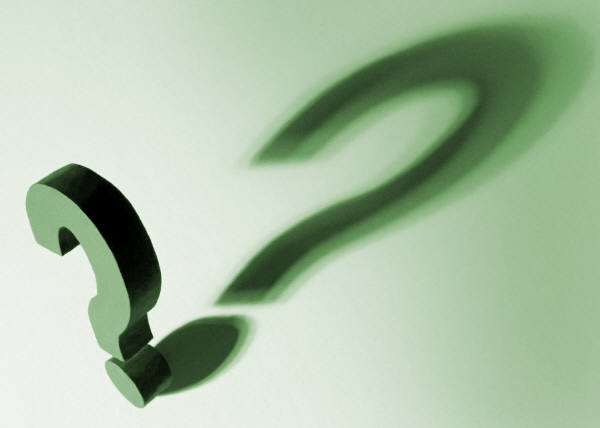
[picture p132: figure]
