bpjagiel/Senior-Design/MechanicalDesigns/Moment of Inertia.xlsx

Type | Mass (Kg) | I of the plate (g*m^2) | I of the mass (g*m^2) | I total (g*m^2) | I total (kg*m^2)
#10 Drywall Screw | 1.1 | 0.32 | 11 | 11.32 | 0.01132
#10 Drywall Anchor | 0.09 | 0.3218156 | 0.9 | 1.2218156 | 0.0012218156
4mm Hex Nut | 0.0326 | 0.31 | 0.326 | 0.636 | 0.000636
10mm Hex Nut | 0.4665 | 0.34 | 4.665 | 5.005 | 0.005005
4x50mm Socket Head Cap Screw | 0.3 | 0.30919499 | 3 | 3.30919499 | 0.00330919499
10x25mm Socket Head Cap Screw | 1.36 | 0.33 | 13.6 | 13.93 | 0.01393
 |  |  |  |  | 0.005903668432
