bpjagiel/Senior-Design/MeetingMinutes/ArchitectureTeamMeeting_20140921.xlsx

Project Team Meeting Minutes
Type of meeting: |  | Architecture
Date: |  | 2014-09-21
 | Time Start: | 1pm
 | Time End: | 4pm
Attendance
Expected | Present? |  | Agenda | Conclusion | Status | Feature Owner(s)
Paul Kruchko | Yes |  | Design Proposal review | Proposal revised, sections of proposal asssigned to other team mates, need everyone's contribution to the Design Proposal no later than midnight this Monday | Ongoing | Paul
Bryan Jagielo | Yes |  | Materials Selection | ABS for feeder bowl. 80/20 for machine frame where possible, sheet metal for control panels? | Ongoing | Michael
Michael Laba | Yes |  | Microcontroller Selection | Arduino Mega style control board using the 8-bit Atmel ATMega 2560 microcontroller | Complete | Monika
Xiaong Tong (Terry) | No |  | Final Machine Frame Sketch/Mock-up | Need to finish concept sketches for machine to include in proposal | Ongoing | Paul, Michael
Xinfeng Shi (Steven) | Yes |  | Additional Topics Discussed:
Ran Ao (Audrey) | Yes |  | Diagram for block-plunger-system | Someone needs to sketch up the block plunger system and include it in the Diagrams section of the proposal | Not Started | ME Design Team
Monika Shaeff | Yes |  | Diagram for agitator stick | Someone needs to sketch up the agitator stick and include it in the Diagrams section of the proposal | Not Started | ME Design team
 |  |  | A continous and single feed option | A switch selecting between a continous or single feed option needs to be included in the design proposal | Not Started | Paul
