bpjagiel/Senior-Design/Brainstorming/001.jpg

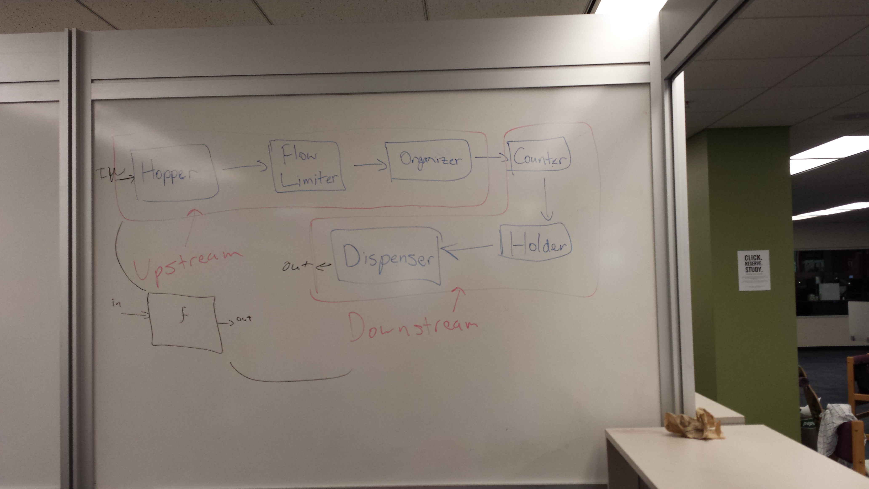
Brainstorming/001.jpg
