bpjagiel/Senior-Design/Brainstorming/002.jpg

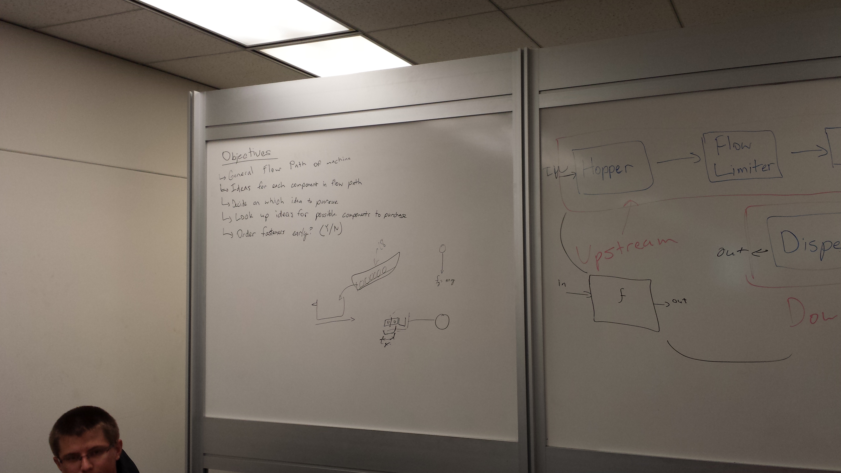
Brainstorming/002.jpg
