bpjagiel/Senior-Design/Brainstorming/003.jpg

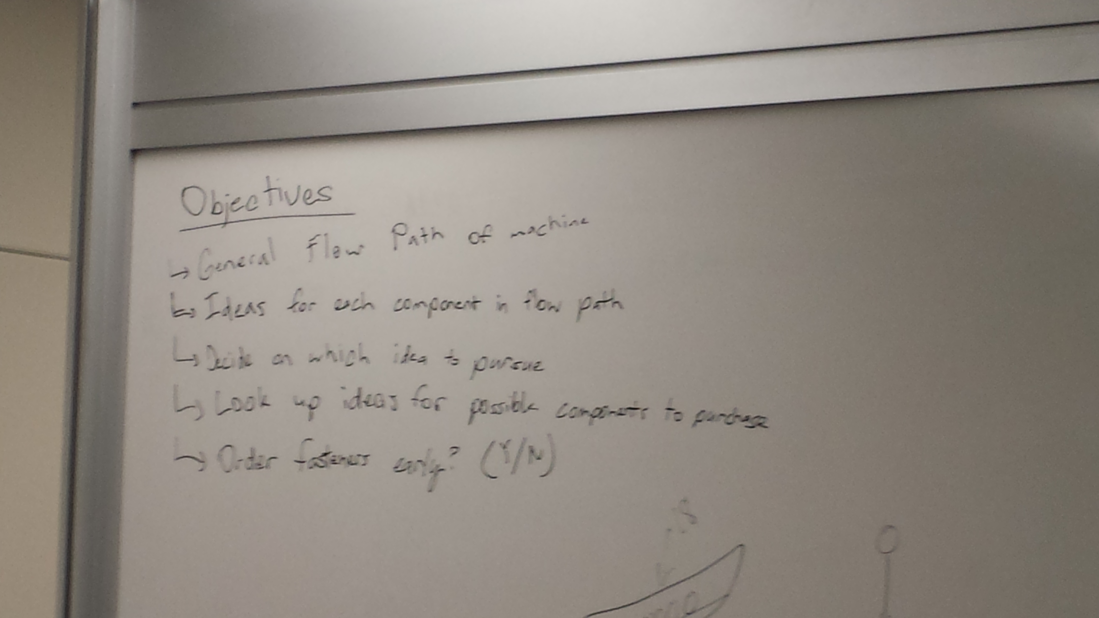
Brainstorming/003.jpg
