bpjagiel/Senior-Design/Brainstorming/005.jpg

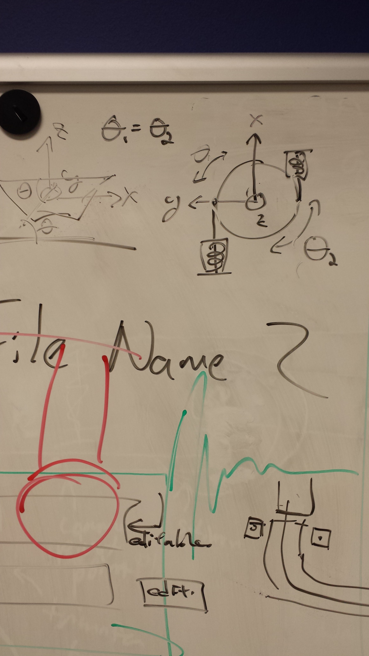
Brainstorming/005.jpg
