bpjagiel/Senior-Design/Brainstorming/006.jpg

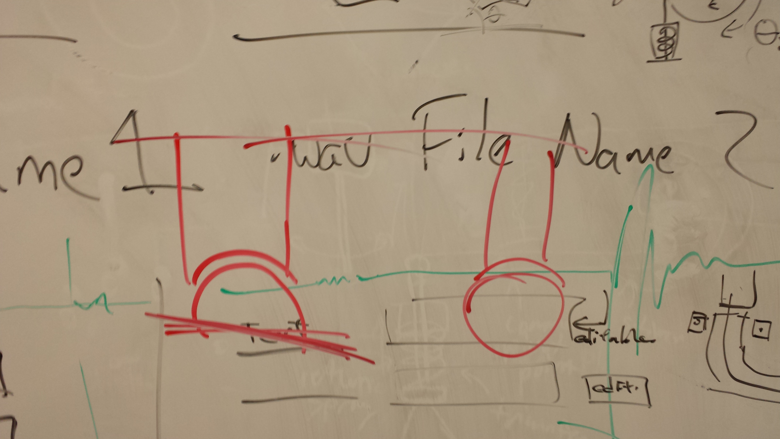
Brainstorming/006.jpg
