bpjagiel/Senior-Design/Brainstorming/007.jpg

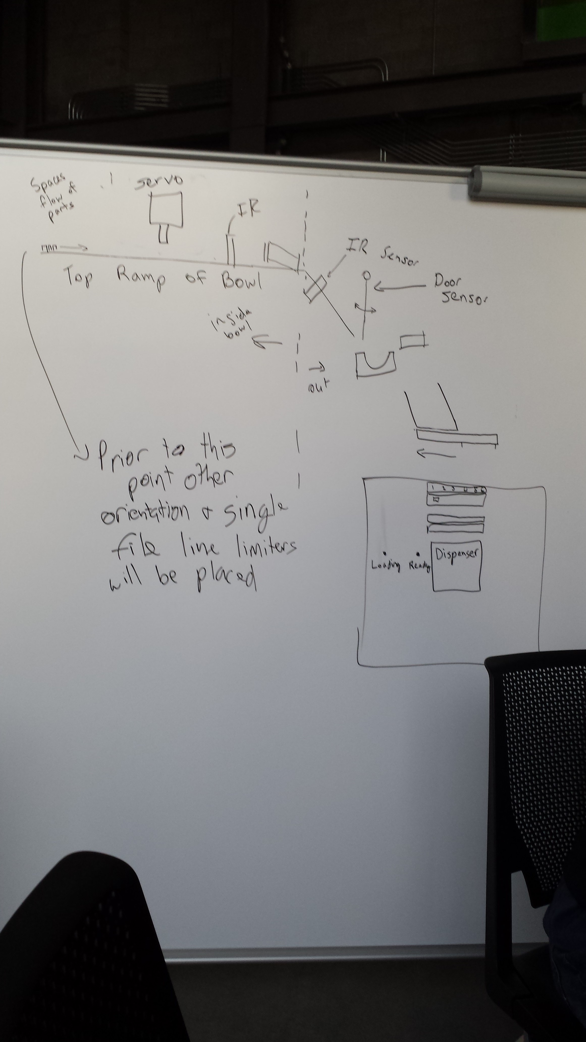
Brainstorming/007.jpg
