bpjagiel/Senior-Design/Brainstorming/008.jpg

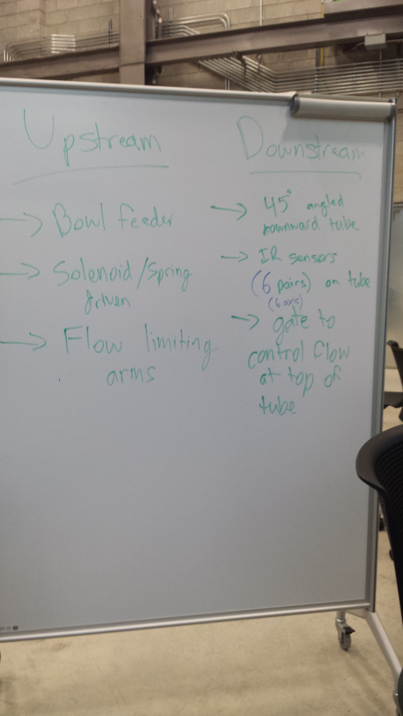
Brainstorming/008.jpg
