bpjagiel/Senior-Design/Brainstorming/009.jpg

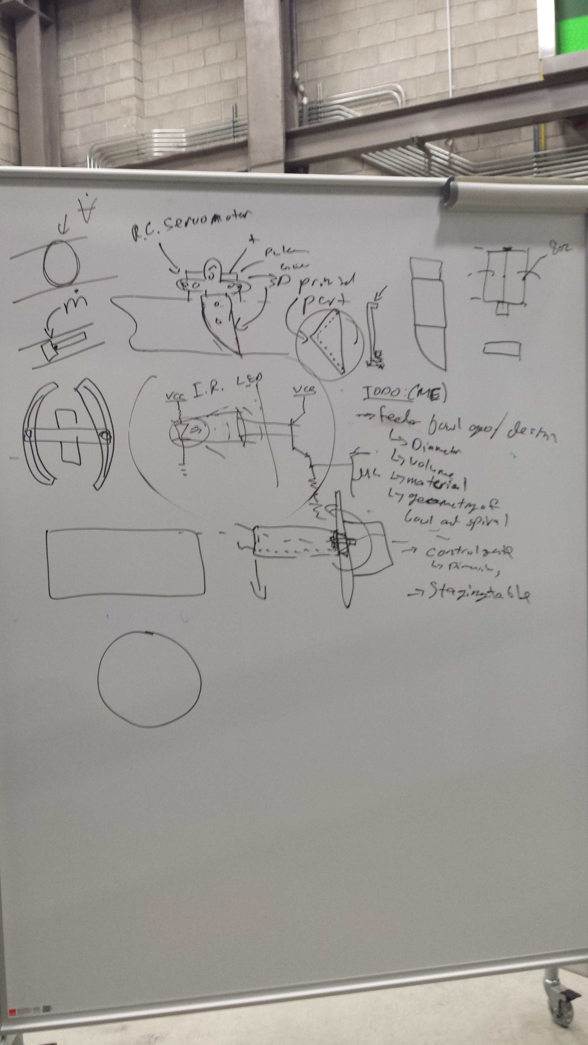
Brainstorming/009.jpg
