bpjagiel/Senior-Design/Brainstorming/20140929_175624.jpg

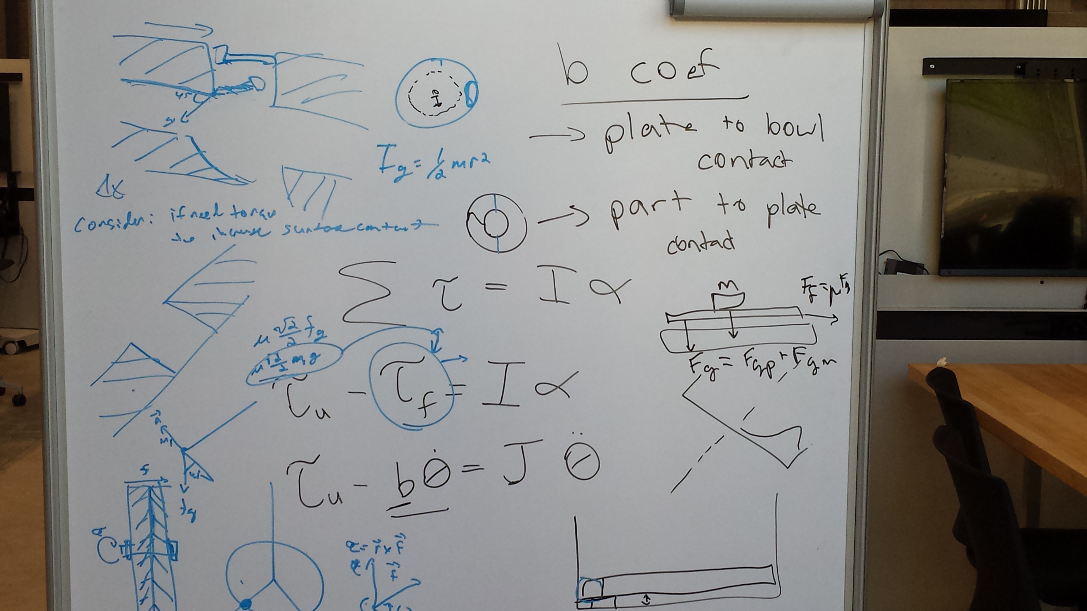
Brainstorming/20140929_175624.jpg
