bpjagiel/Senior-Design/Brainstorming/20140929_175657.jpg

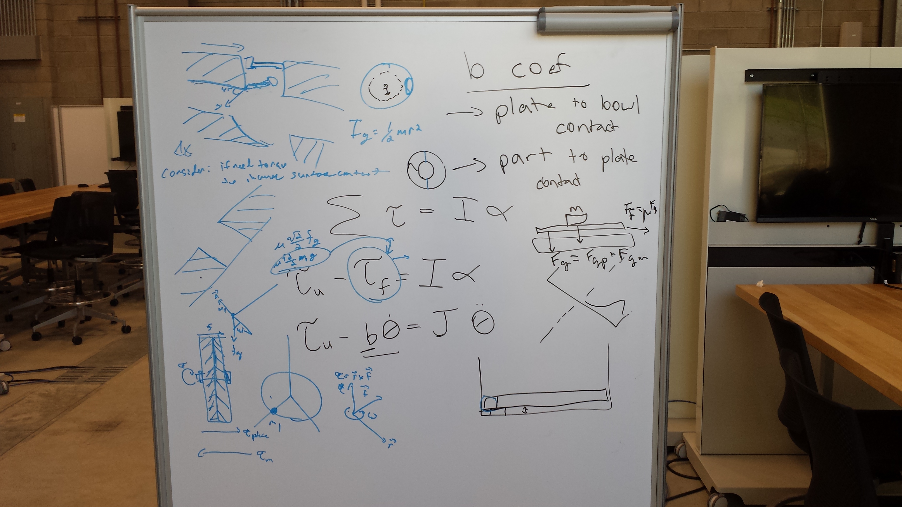
Brainstorming/20140929_175657.jpg
