bpjagiel/Senior-Design/Brainstorming/20140929_175715.jpg

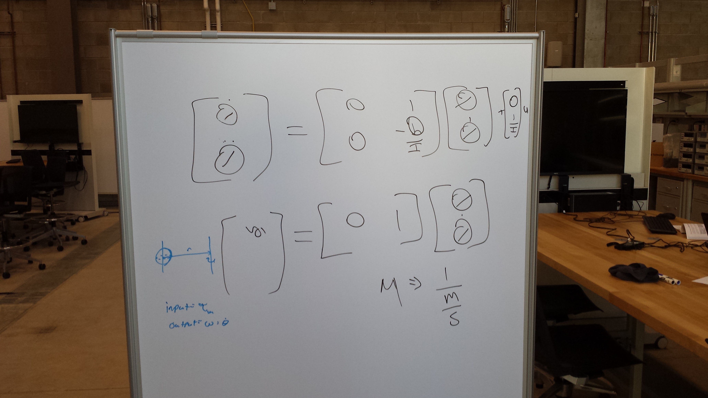
Brainstorming/20140929_175715.jpg
