bpjagiel/Senior-Design/ElectricalDesigns/debounceCKT (2).png

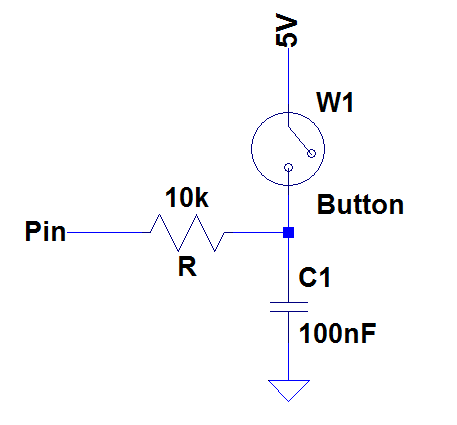
ElectricalDesigns/debounceCKT (2).png
