bpjagiel/Senior-Design/FinalReport/PicturesForReport/727.jpg

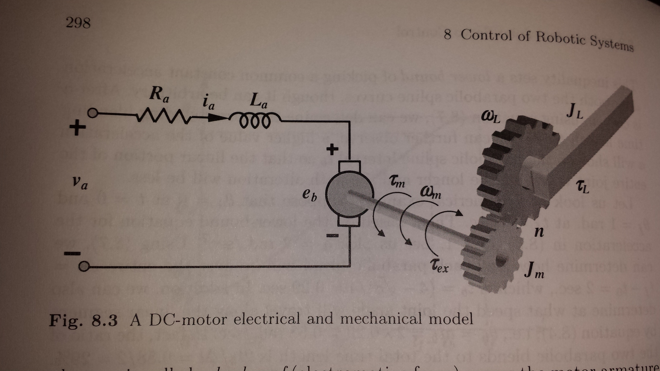
FinalReport/PicturesForReport/727.jpg
