bpjagiel/Senior-Design/FinalReport/PicturesForReport/728.jpg

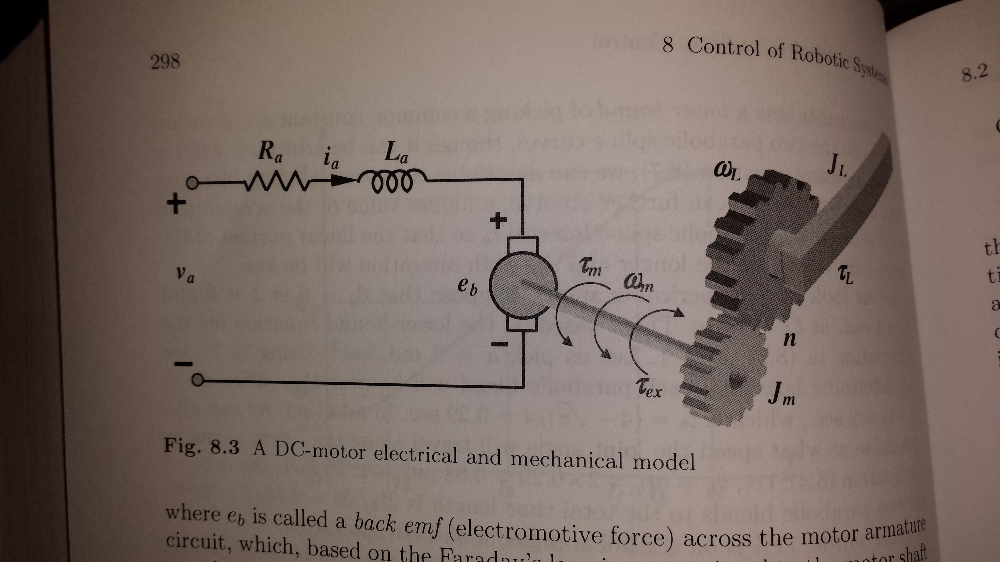
FinalReport/PicturesForReport/728.jpg
