bpjagiel/Senior-Design/FinalReport/PicturesForReport/729.jpg

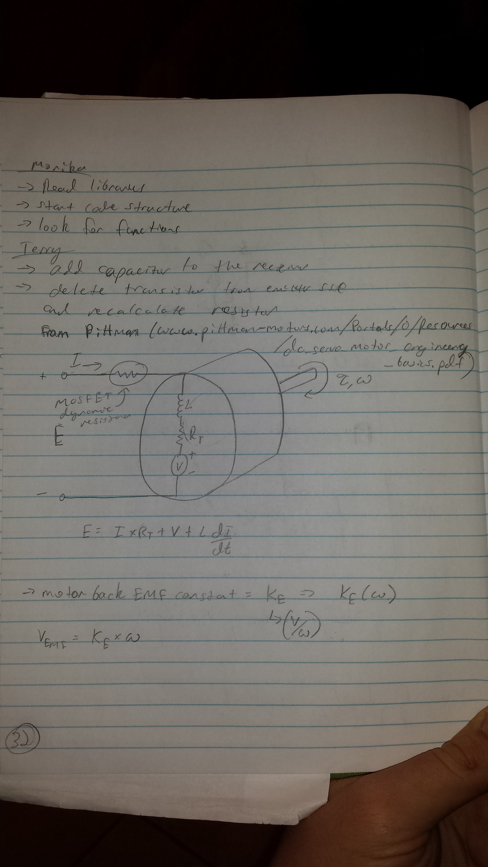
FinalReport/PicturesForReport/729.jpg
