bpjagiel/Senior-Design/FinalReport/PicturesForReport/730.jpg

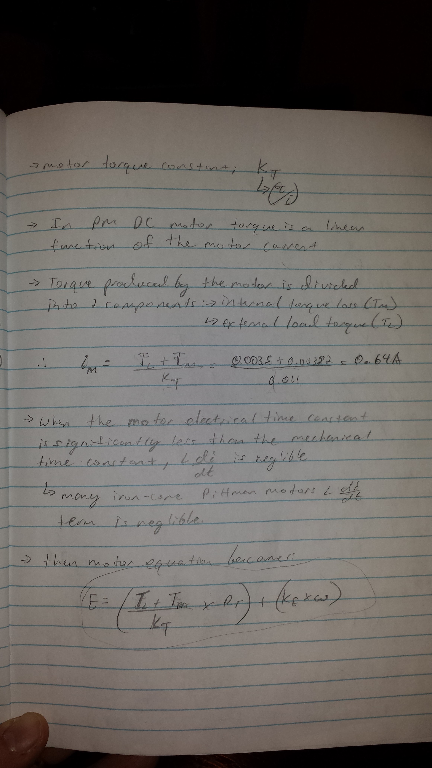
FinalReport/PicturesForReport/730.jpg
