bpjagiel/Senior-Design/FinalReport/PicturesForReport/731.jpg

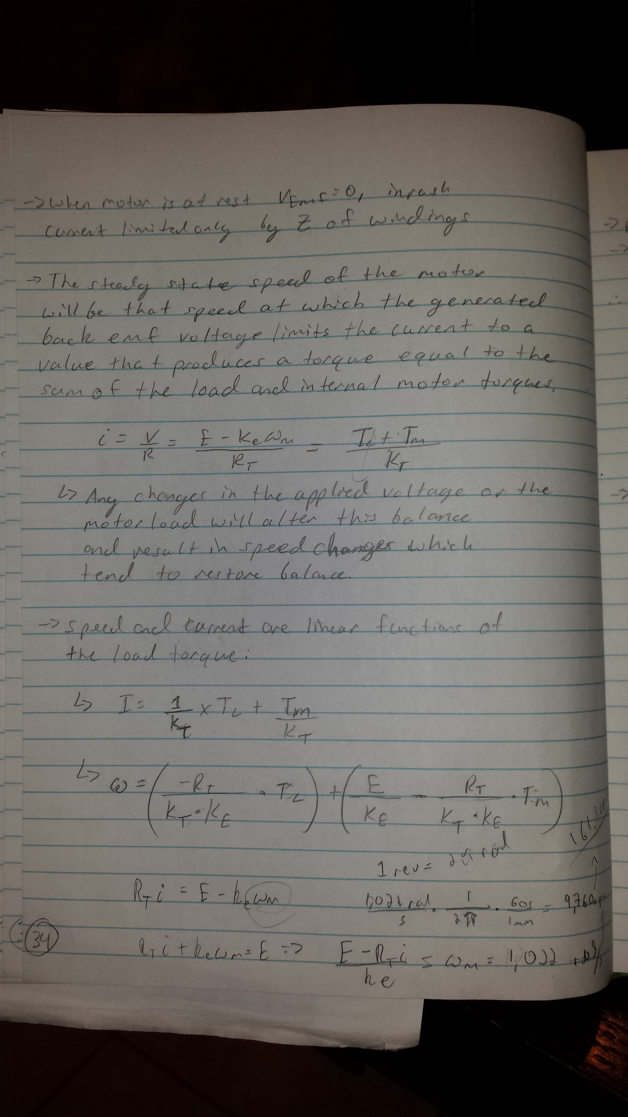
FinalReport/PicturesForReport/731.jpg
