bpjagiel/Senior-Design/FinalReport/PicturesForReport/732.jpg

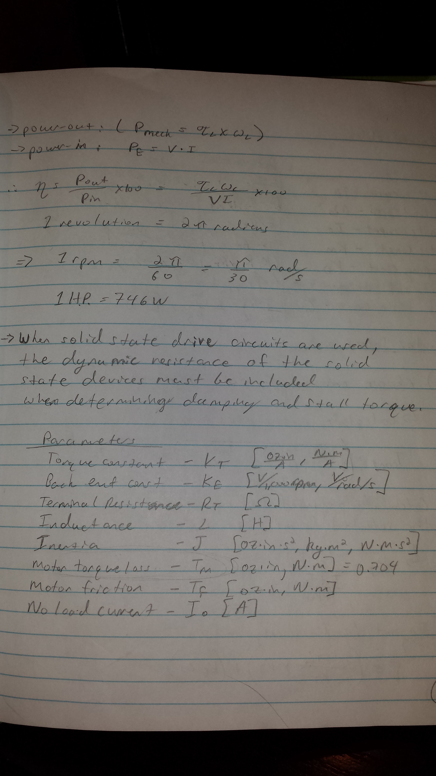
FinalReport/PicturesForReport/732.jpg
