bpjagiel/Senior-Design/FinalReport/PicturesForReport/733.jpg

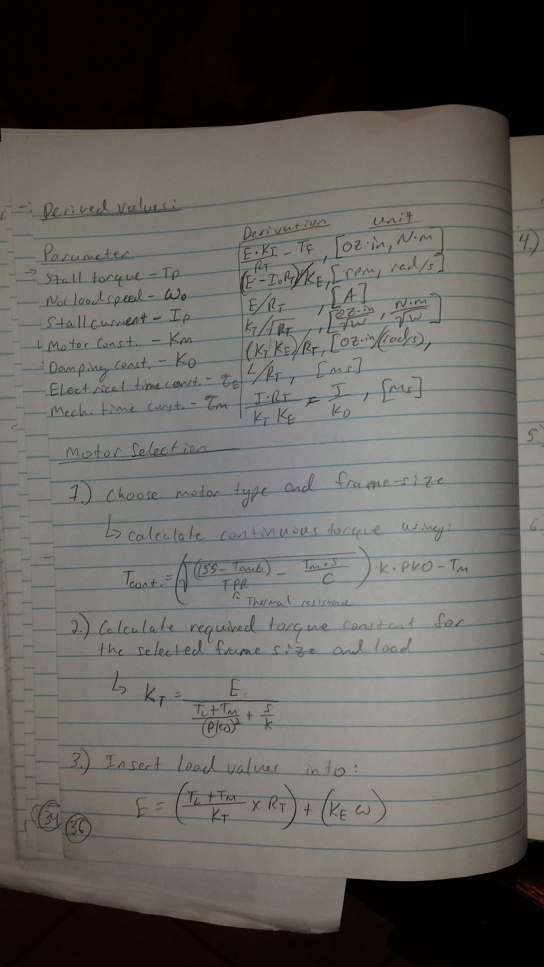
FinalReport/PicturesForReport/733.jpg
