bpjagiel/Senior-Design/FinalReport/PicturesForReport/734.jpg

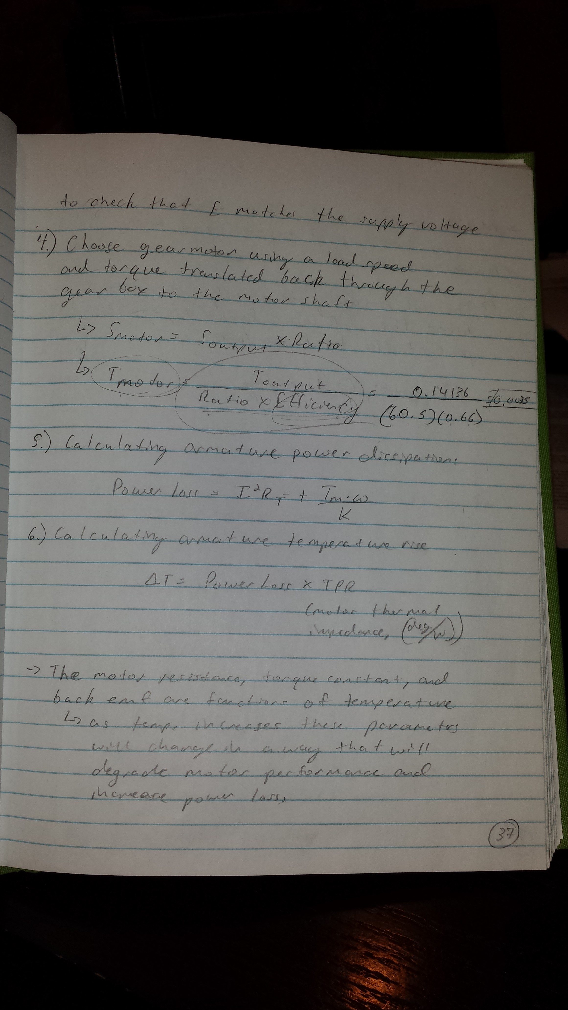
FinalReport/PicturesForReport/734.jpg
