bpjagiel/Senior-Design/FinalReport/PicturesForReport/735.jpg

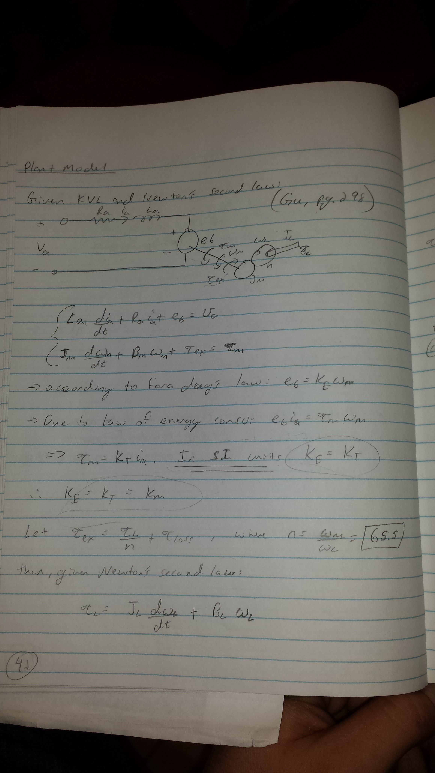
FinalReport/PicturesForReport/735.jpg
