bpjagiel/Senior-Design/FinalReport/PicturesForReport/736.jpg

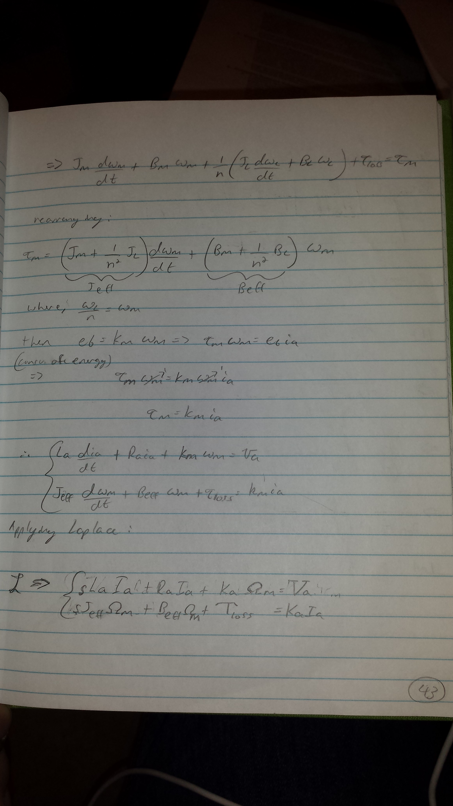
FinalReport/PicturesForReport/736.jpg
