bpjagiel/Senior-Design/FinalReport/PicturesForReport/737.jpg

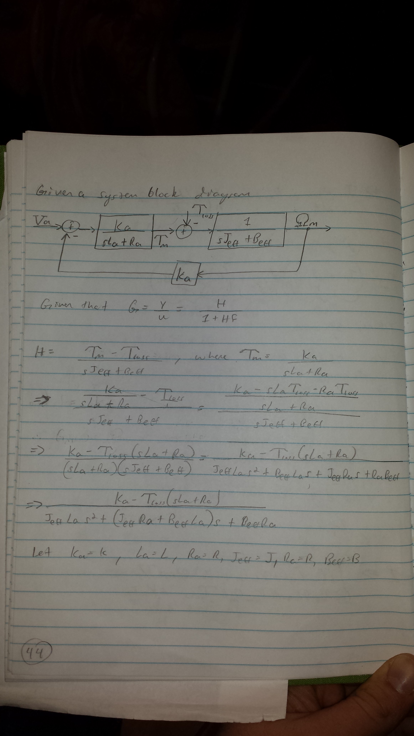
FinalReport/PicturesForReport/737.jpg
