bpjagiel/Senior-Design/FinalReport/PicturesForReport/738.jpg

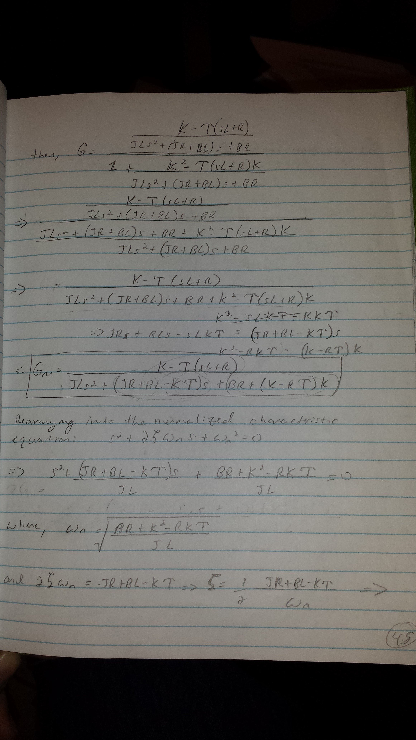
FinalReport/PicturesForReport/738.jpg
