bpjagiel/Senior-Design/FinalReport/PicturesForReport/739.jpg

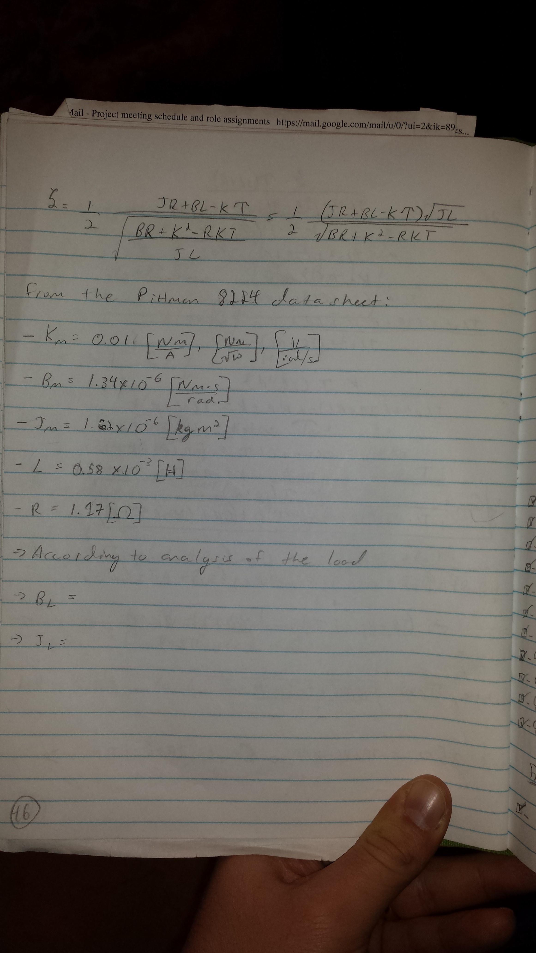
FinalReport/PicturesForReport/739.jpg
