bpjagiel/Senior-Design/FinalReport/PicturesForReport/740.jpg

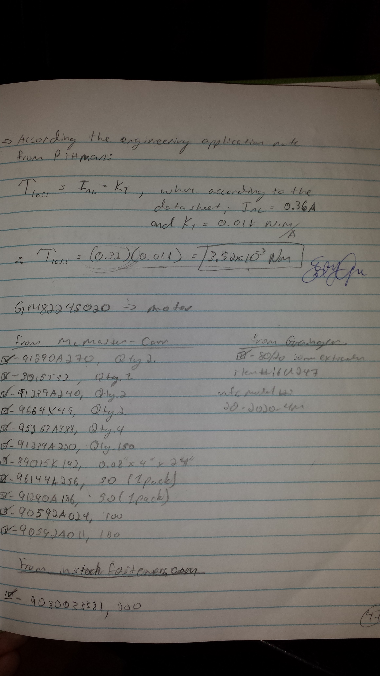
FinalReport/PicturesForReport/740.jpg
