bpjagiel/Senior-Design/FinalReport/PicturesForReport/744.jpg

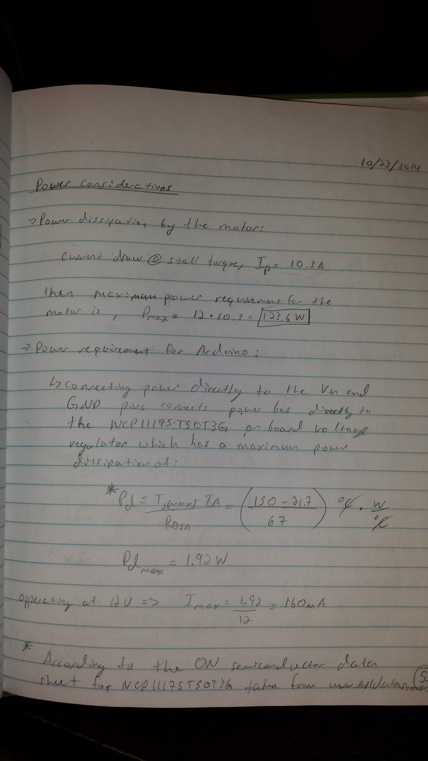
FinalReport/PicturesForReport/744.jpg
