bpjagiel/Senior-Design/FinalReport/PicturesForReport/745.jpg

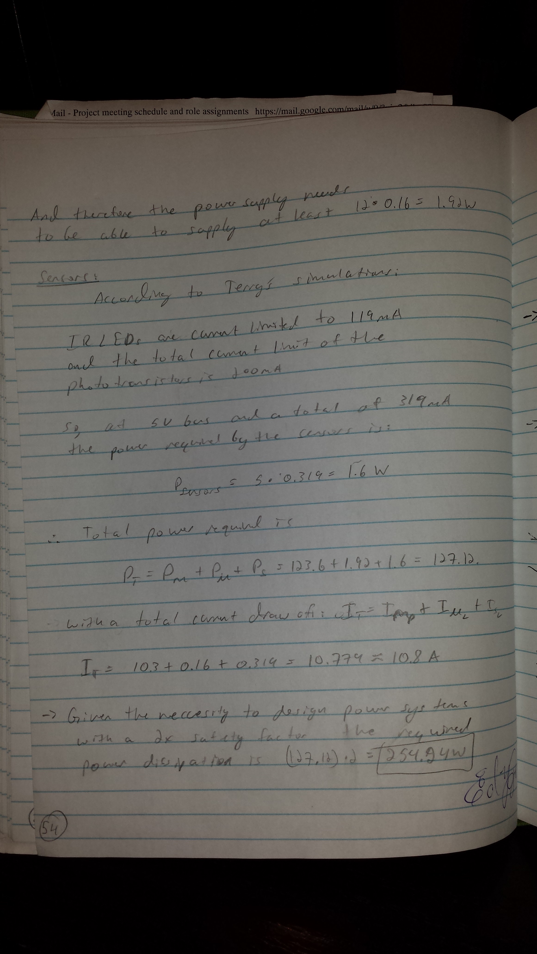
FinalReport/PicturesForReport/745.jpg
