bpjagiel/Senior-Design/FinalReport/PicturesForReport/746.jpg

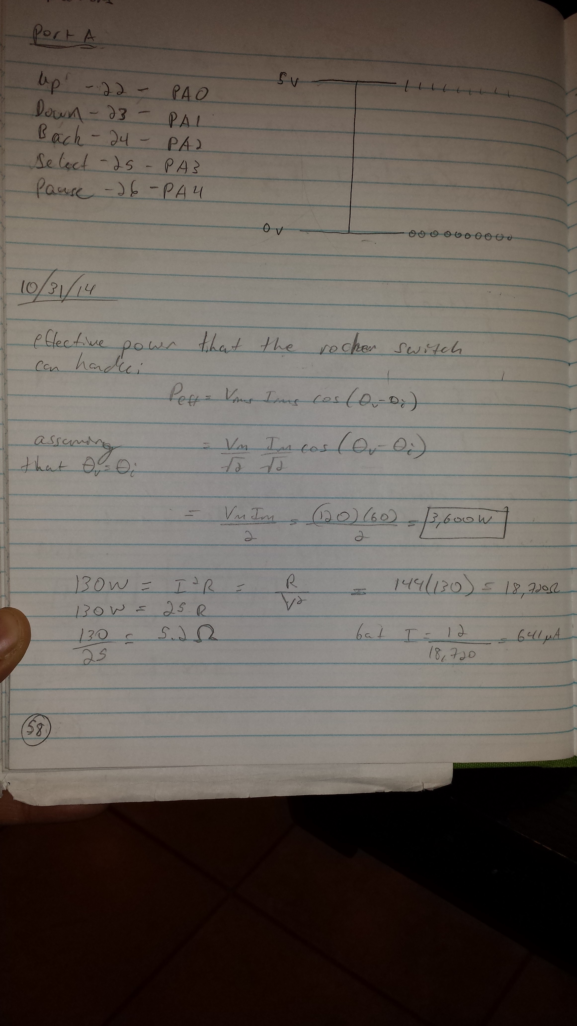
FinalReport/PicturesForReport/746.jpg
