bpjagiel/Senior-Design/FinalReport/PicturesForReport/747.jpg

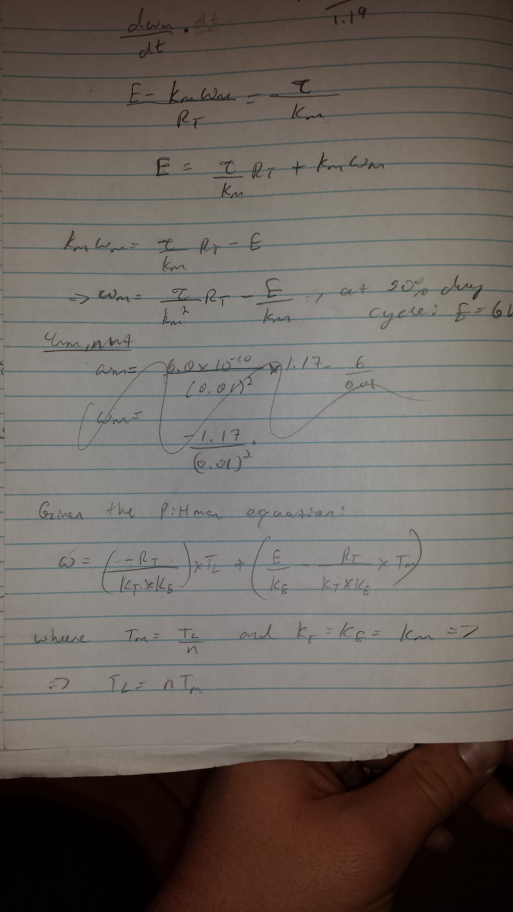
FinalReport/PicturesForReport/747.jpg
