bpjagiel/Senior-Design/FinalReport/PicturesForReport/748.jpg

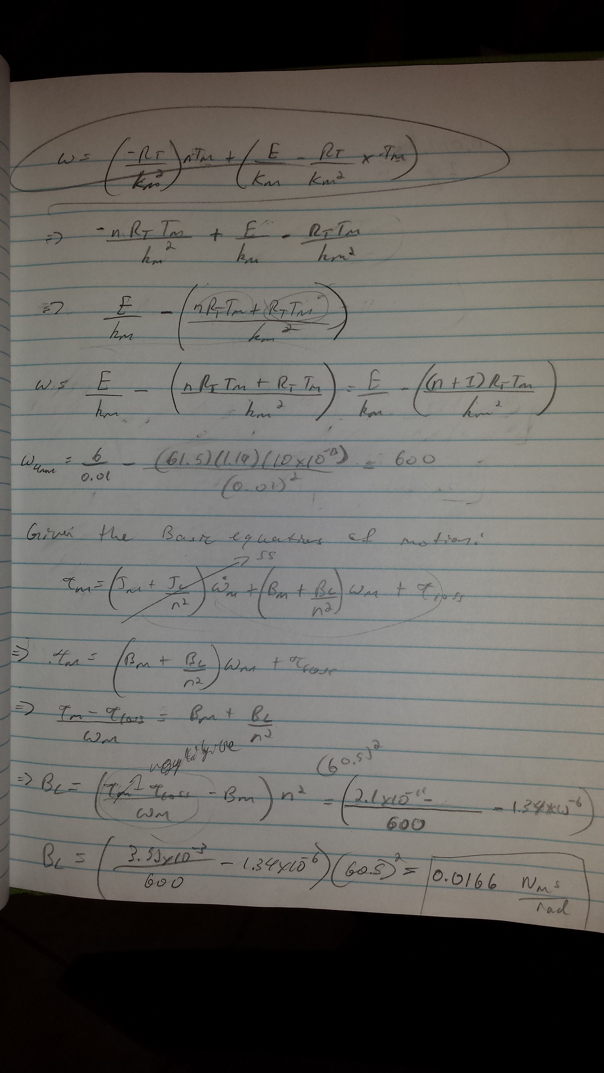
FinalReport/PicturesForReport/748.jpg
