bpjagiel/Senior-Design/FinalReport/PicturesForReport/20141209_033622.jpg

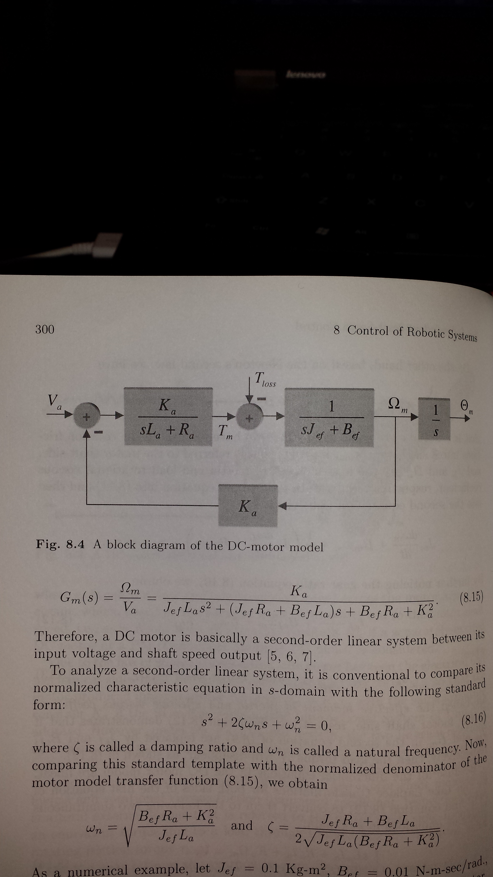
FinalReport/PicturesForReport/20141209_033622.jpg
