bpjagiel/Senior-Design/FinalReport/PicturesForReport/BlockDiagram.jpg

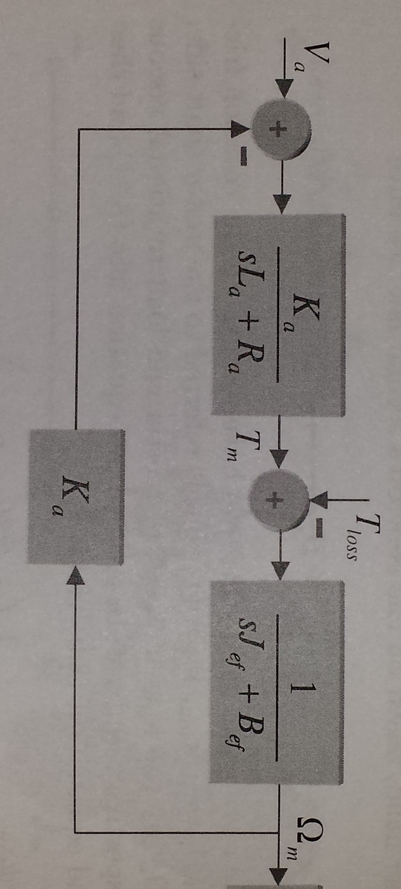
FinalReport/PicturesForReport/BlockDiagram.jpg
