bpjagiel/Senior-Design/FinalReport/PicturesForReport/GuModel.jpg

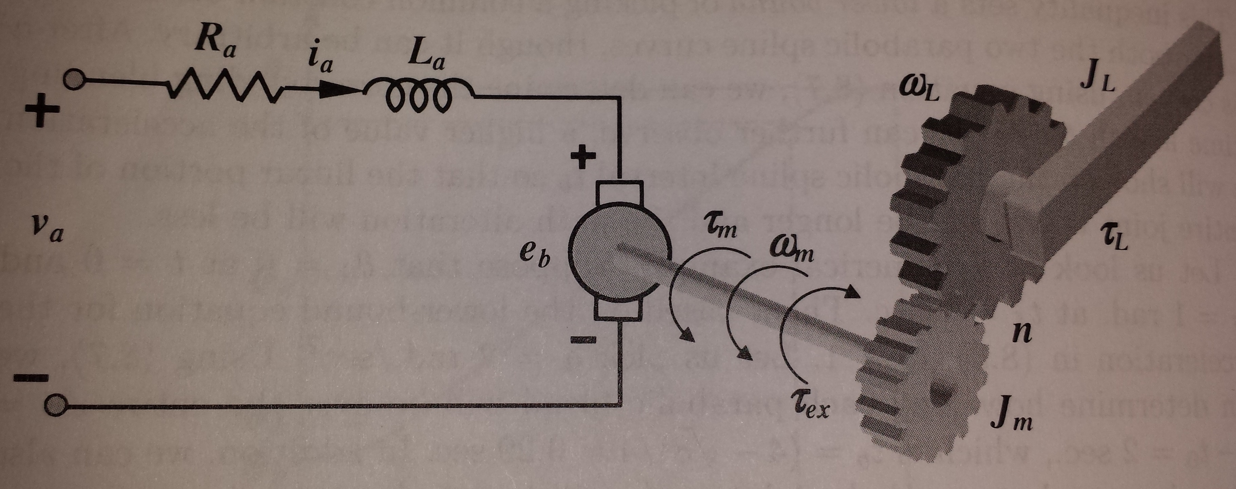
FinalReport/PicturesForReport/GuModel.jpg
