bpjagiel/Senior-Design/FinalReport/PicturesForReport/MotorModel/1.jpg

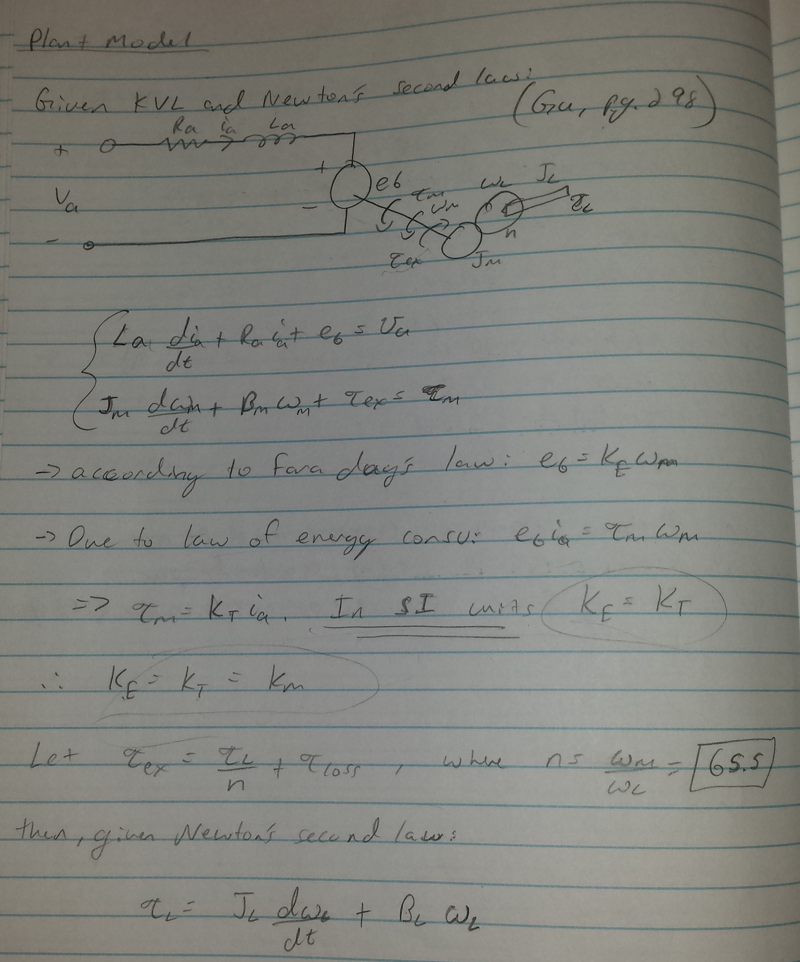
FinalReport/PicturesForReport/MotorModel/1.jpg
