bpjagiel/Senior-Design/FinalReport/PicturesForReport/MotorModel/2.jpg

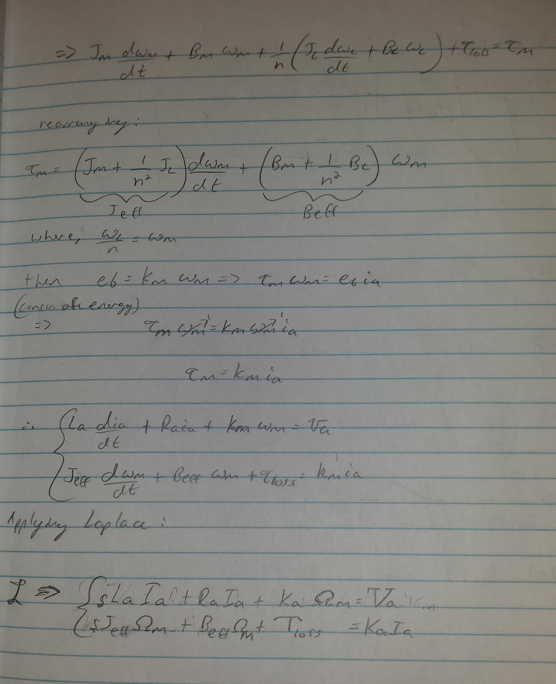
FinalReport/PicturesForReport/MotorModel/2.jpg
