bpjagiel/Senior-Design/FinalReport/PicturesForReport/MotorModel/3.jpg

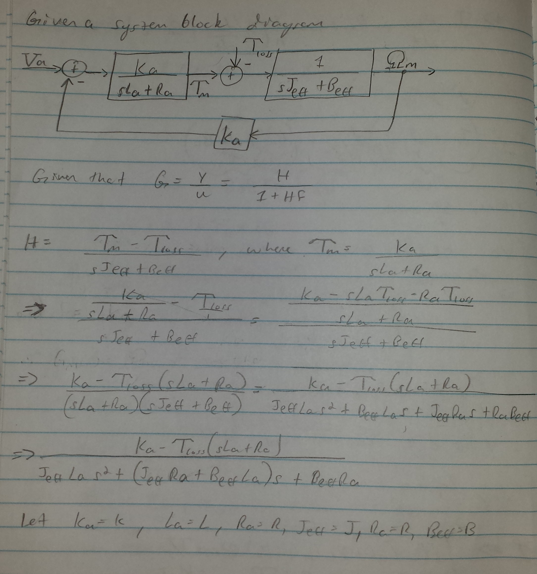
FinalReport/PicturesForReport/MotorModel/3.jpg
