bpjagiel/Senior-Design/FinalReport/PicturesForReport/MotorModel/4.jpg

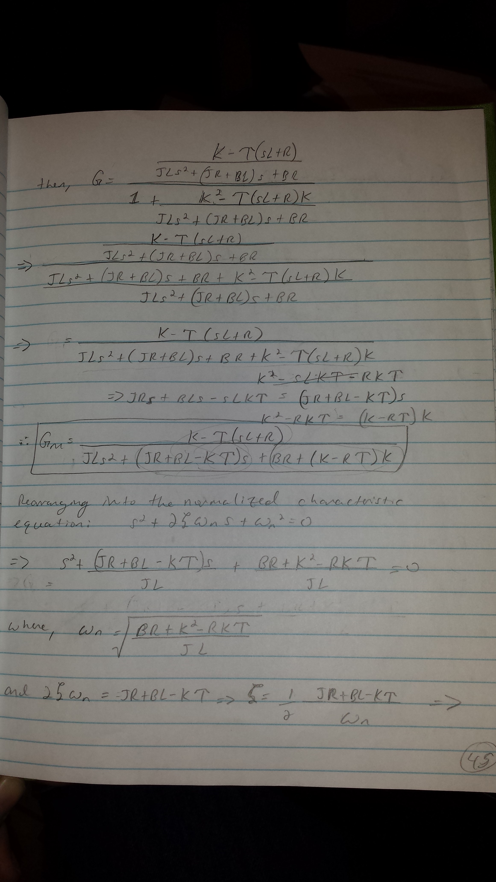
FinalReport/PicturesForReport/MotorModel/4.jpg
