bpjagiel/Senior-Design/FinalReport/PicturesForReport/MotorModel/5.jpg

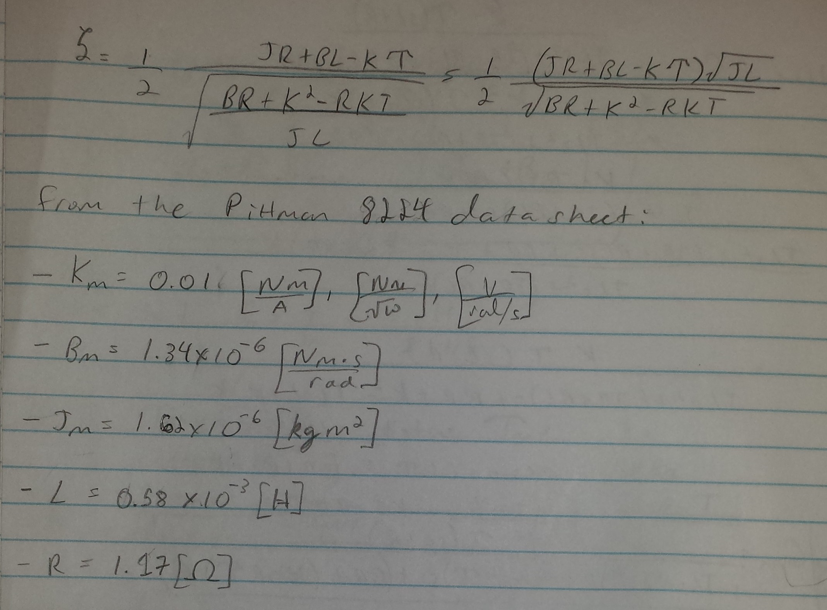
FinalReport/PicturesForReport/MotorModel/5.jpg
