bpjagiel/Senior-Design/MechanicalDesigns/799EC34CEB5AED2D6540FF5941E050A2.png

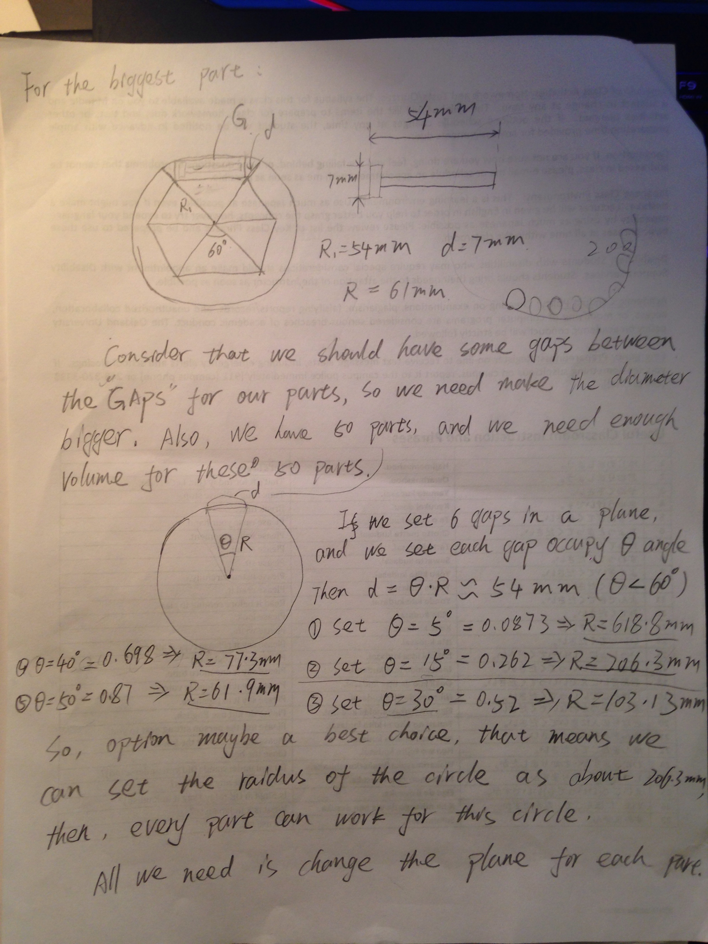
MechanicalDesigns/799EC34CEB5AED2D6540FF5941E050A2.png
