bpjagiel/Senior-Design/MechanicalDesigns/disk of 4mm.PNG

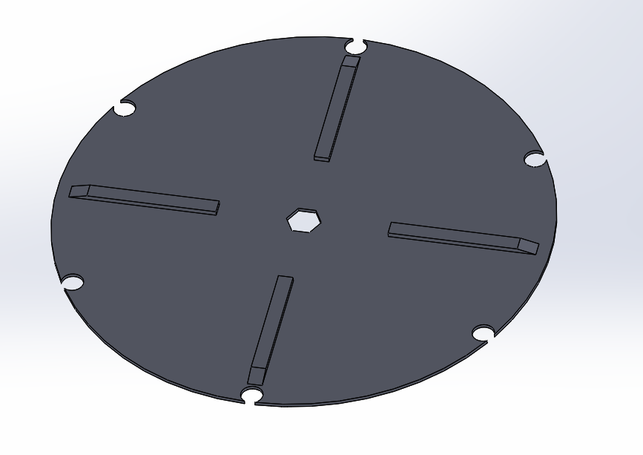
MechanicalDesigns/disk of 4mm.PNG
