bpjagiel/Senior-Design/MechanicalDesigns/disk of 10mm.PNG

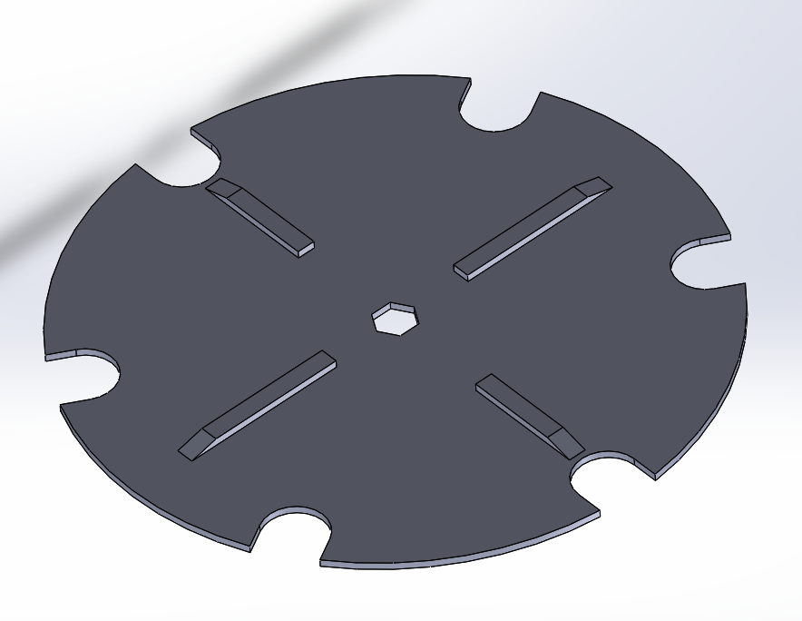
MechanicalDesigns/disk of 10mm.PNG
