bpjagiel/Senior-Design/MechanicalDesigns/disk of 25mm screw.PNG

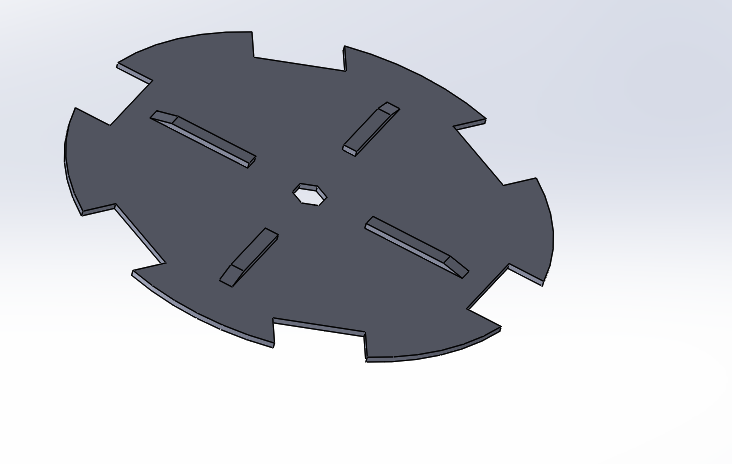
MechanicalDesigns/disk of 25mm screw.PNG
