bpjagiel/Senior-Design/MechanicalDesigns/disk of 50mm screw.PNG

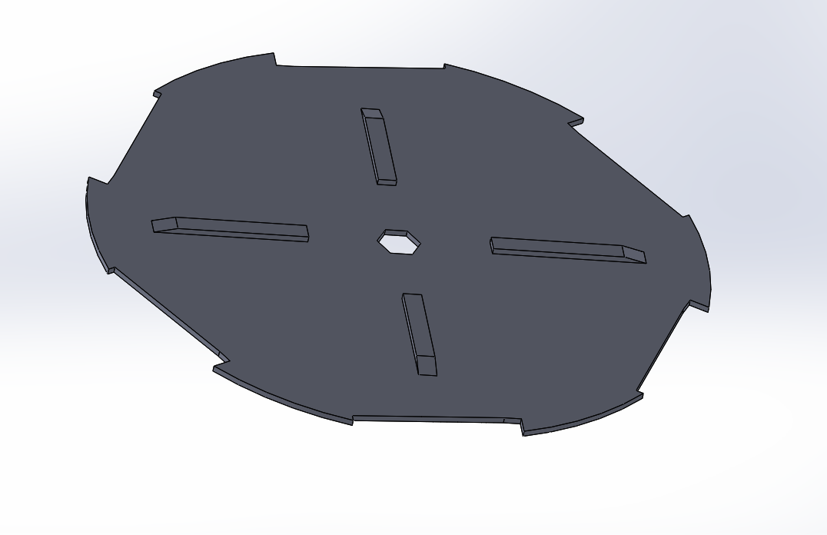
MechanicalDesigns/disk of 50mm screw.PNG
