bpjagiel/Senior-Design/MechanicalDesigns/disk of anchor screw.PNG

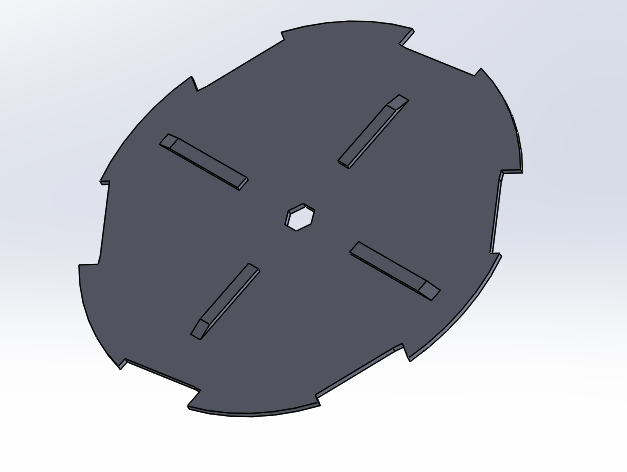
MechanicalDesigns/disk of anchor screw.PNG
