bpjagiel/Senior-Design/MechanicalDesigns/disk of anchor.PNG

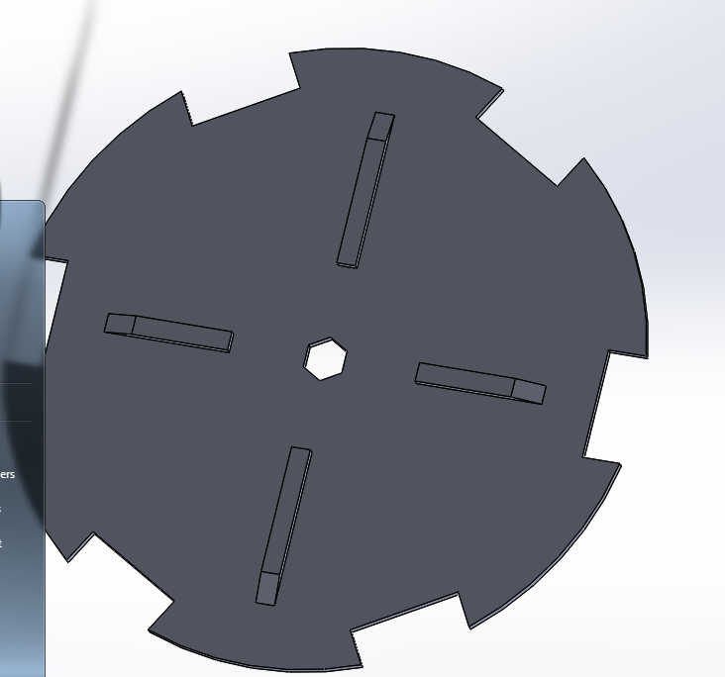
MechanicalDesigns/disk of anchor.PNG
