bpjagiel/Senior-Design/MechanicalDesigns/IMG_2074.JPG

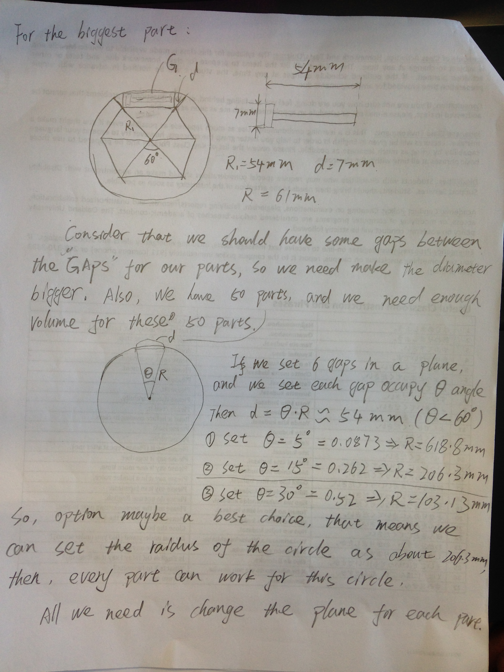
MechanicalDesigns/IMG_2074.JPG
