bpjagiel/Senior-Design/MechanicalDesigns/IMG_2080.JPG

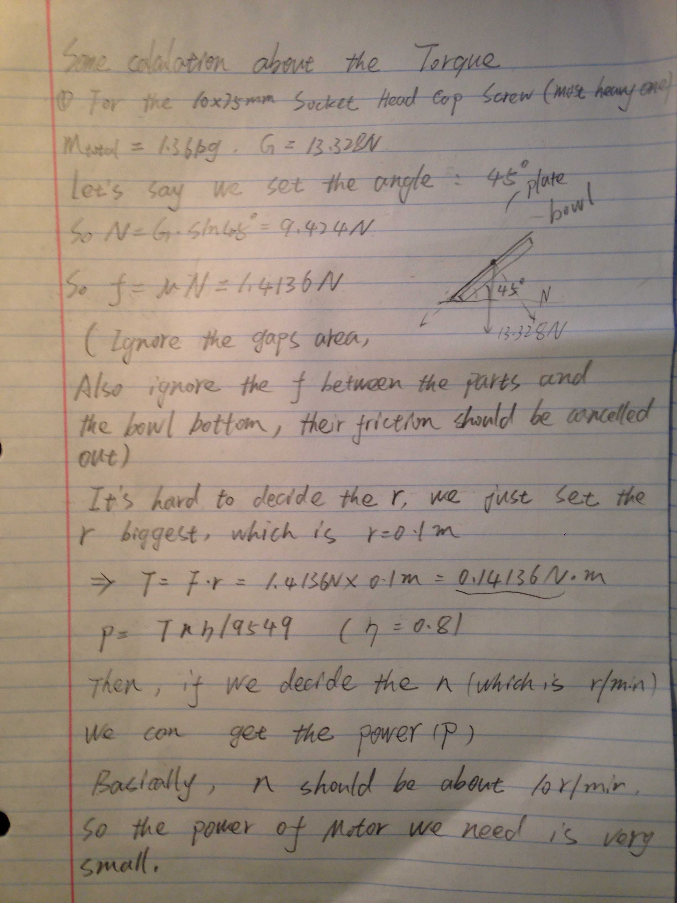
MechanicalDesigns/IMG_2080.JPG
