bpjagiel/Senior-Design/MechanicalDesigns/SpringCalc1.JPG

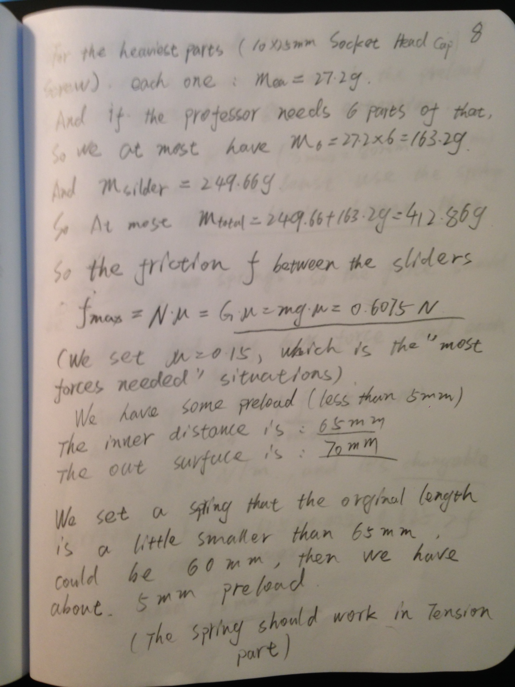
MechanicalDesigns/SpringCalc1.JPG
