bpjagiel/Senior-Design/MechanicalDesigns/SpringCalc2.JPG

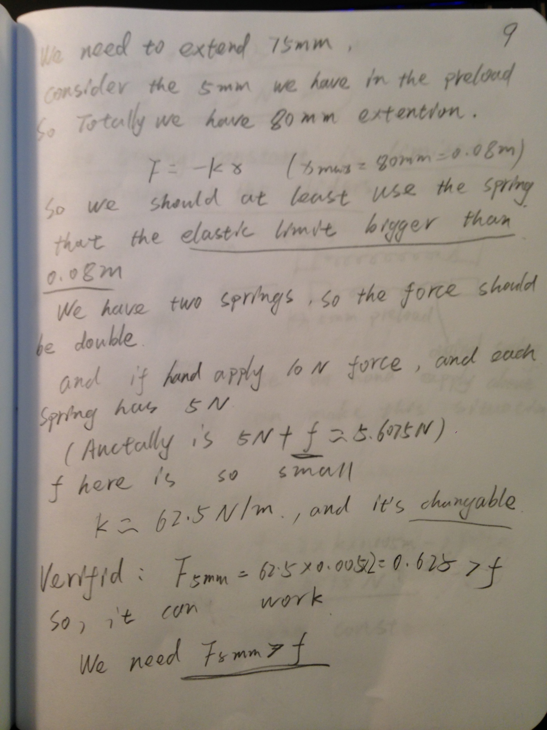
MechanicalDesigns/SpringCalc2.JPG
