bpjagiel/Senior-Design/MechanicalDesigns/SpringCalc3.JPG

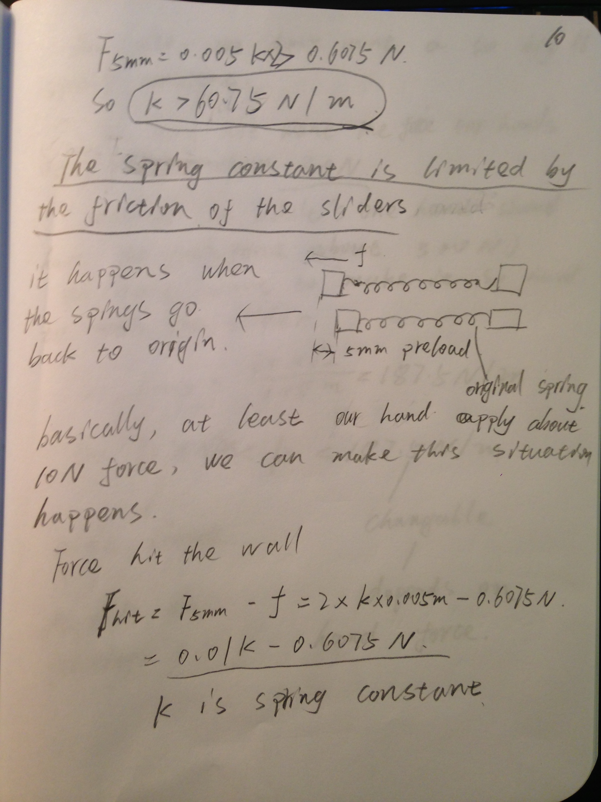
MechanicalDesigns/SpringCalc3.JPG
