bpjagiel/Senior-Design/Motor/EncoderSpecs/MotorDriver/MD01B MOTOR DRIVER SCHEMATIC.png

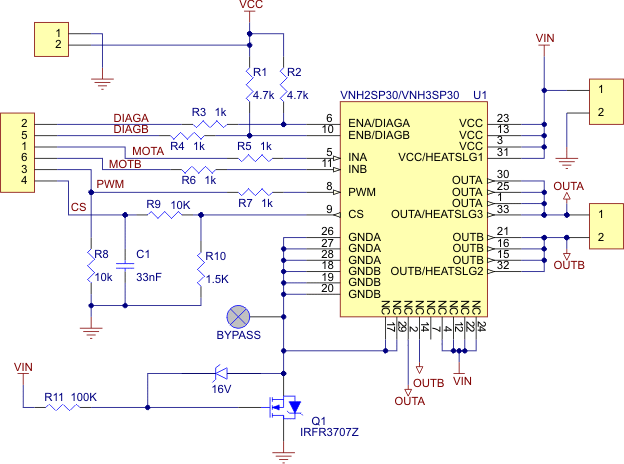
Motor/EncoderSpecs/MotorDriver/MD01B MOTOR DRIVER SCHEMATIC.png
