bpjagiel/Senior-Design/Motor/GearboxSpecs/G35A_dc_motor_wf_spur_gearbox_specs.JPG

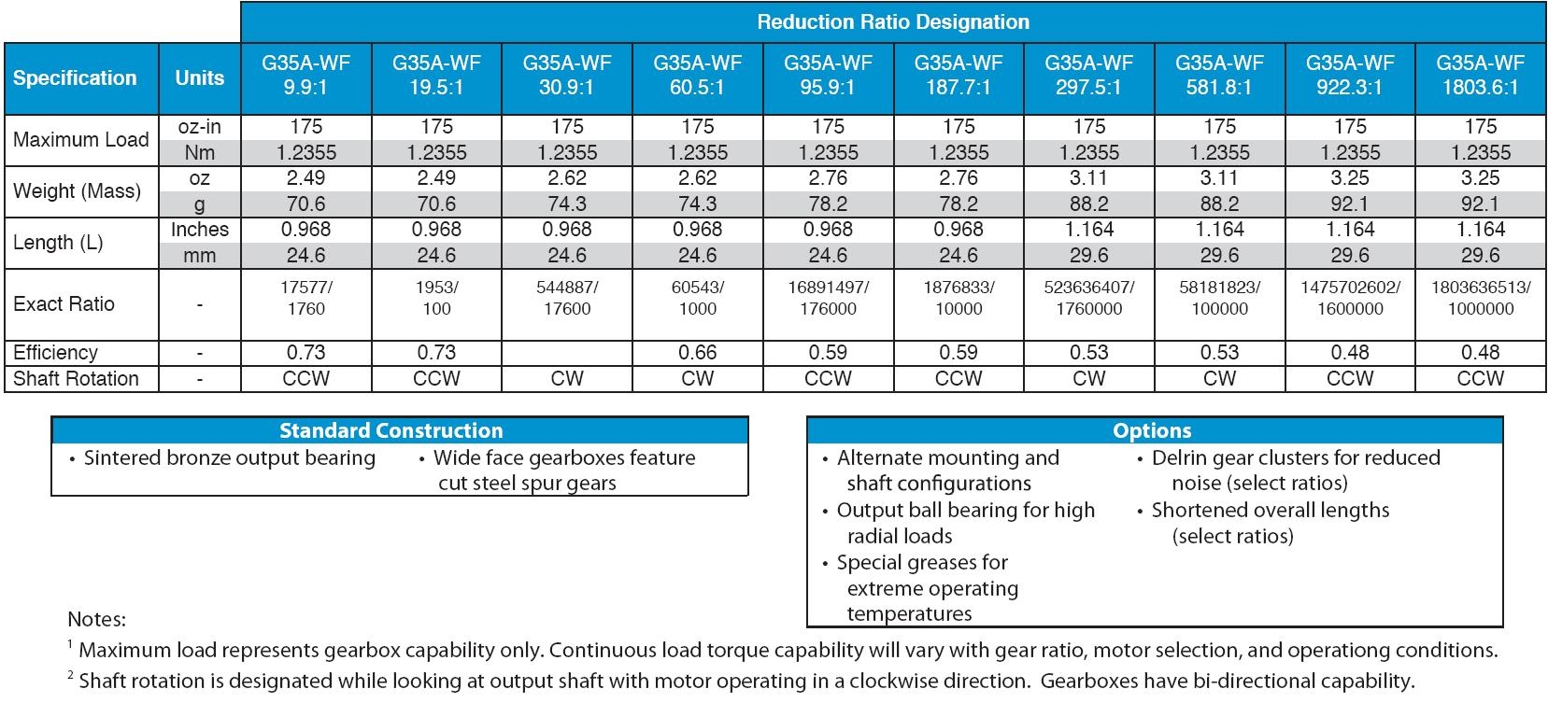
Motor/GearboxSpecs/G35A_dc_motor_wf_spur_gearbox_specs.JPG
