bpjagiel/Senior-Design/Motor/GearboxSpecs/G35A_wf_spur_gearbox_top.jpg

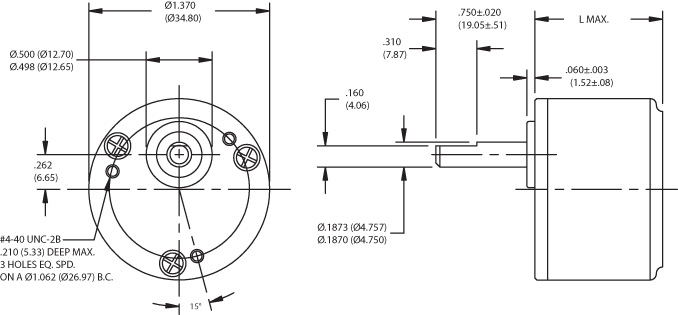
Motor/GearboxSpecs/G35A_wf_spur_gearbox_top.jpg
