bpjagiel/Senior-Design/Motor/MotorSpecs/8224_brush_dc_motor.jpg

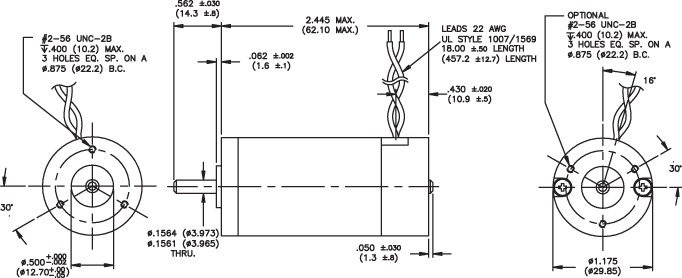
Motor/MotorSpecs/8224_brush_dc_motor.jpg
