bpjagiel/Senior-Design/Motor/MotorSpecs/8224_brush_dc_motor_specs1.JPG

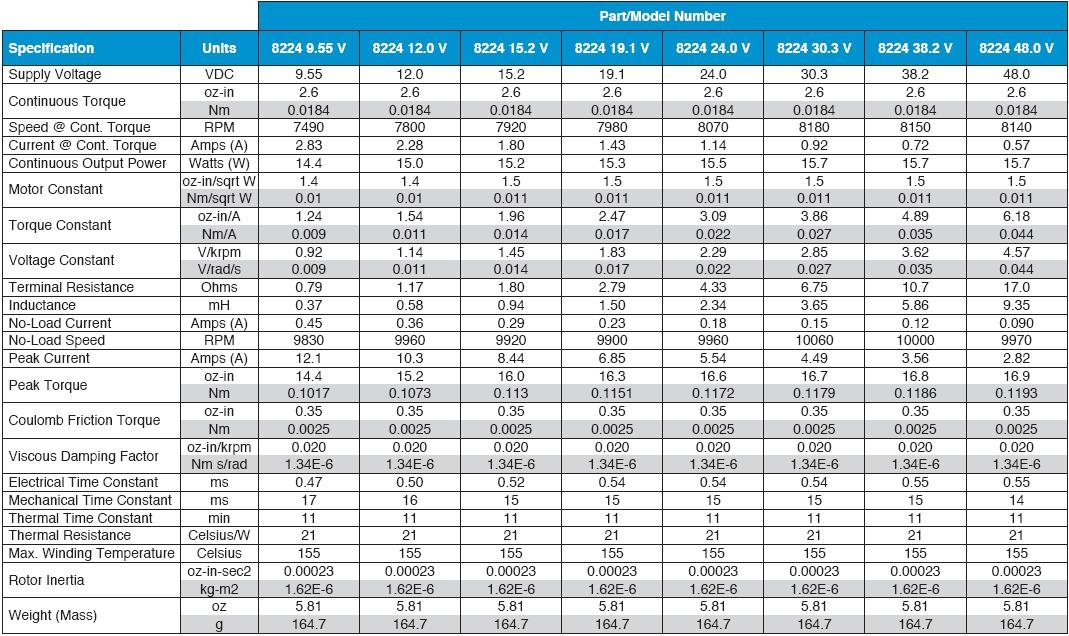
Motor/MotorSpecs/8224_brush_dc_motor_specs1.JPG
