bpjagiel/Senior-Design/Motor/MotorSpecs/8224_brush_dc_motor_specs2.JPG

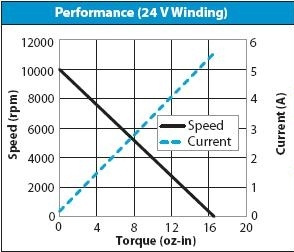
Motor/MotorSpecs/8224_brush_dc_motor_specs2.JPG
