bpjagiel/Senior-Design/Motor/MotorWoutPID.jpg

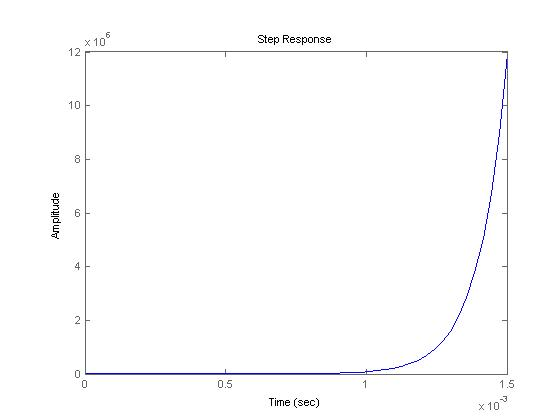
Motor/MotorWoutPID.jpg
