bpjagiel/Senior-Design/Proposal/BD790B86B2ECBB0C3BF319CCDF99AA2C.png

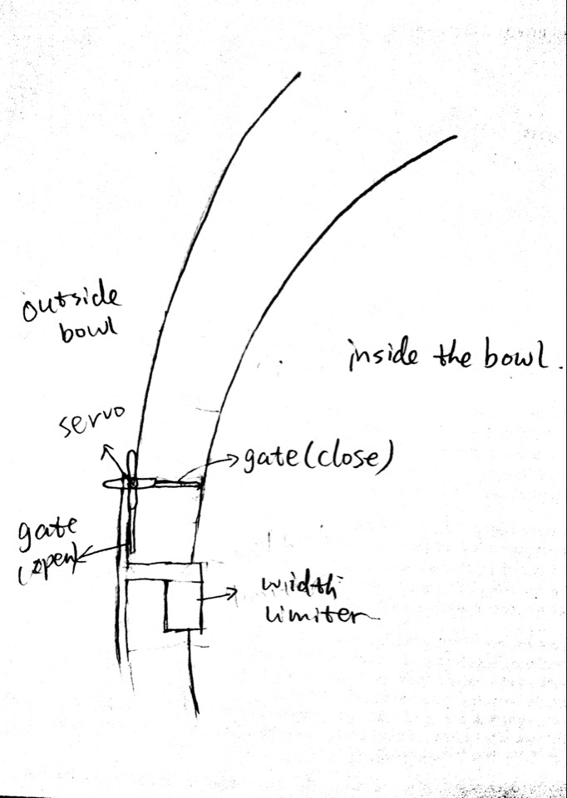
Proposal/BD790B86B2ECBB0C3BF319CCDF99AA2C.png
