bpjagiel/Senior-Design/Proposal/D67EB6AF5B1924B4AE046D016425A7DC.png

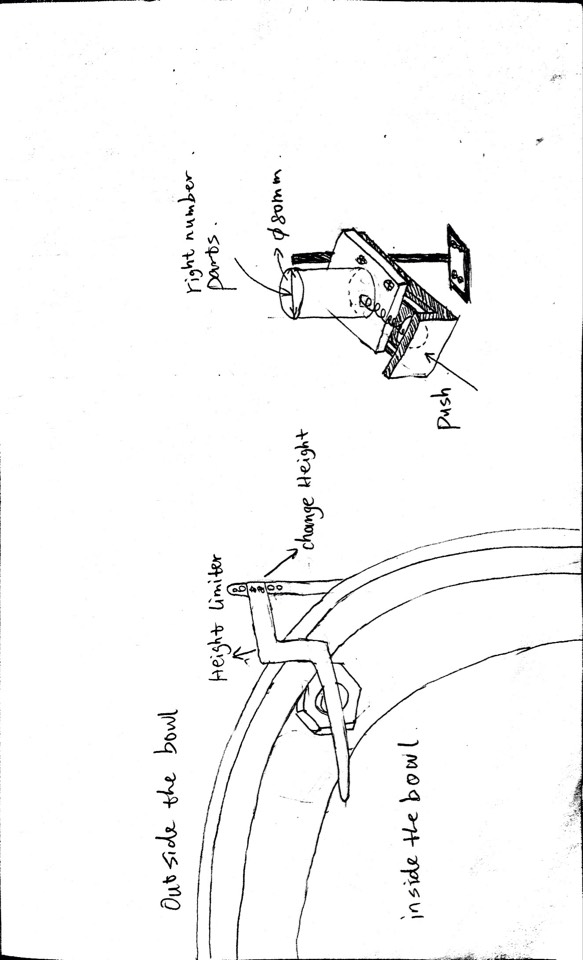
Proposal/D67EB6AF5B1924B4AE046D016425A7DC.png
