bpjagiel/Senior-Design/Proposal/LinearSim.jpg

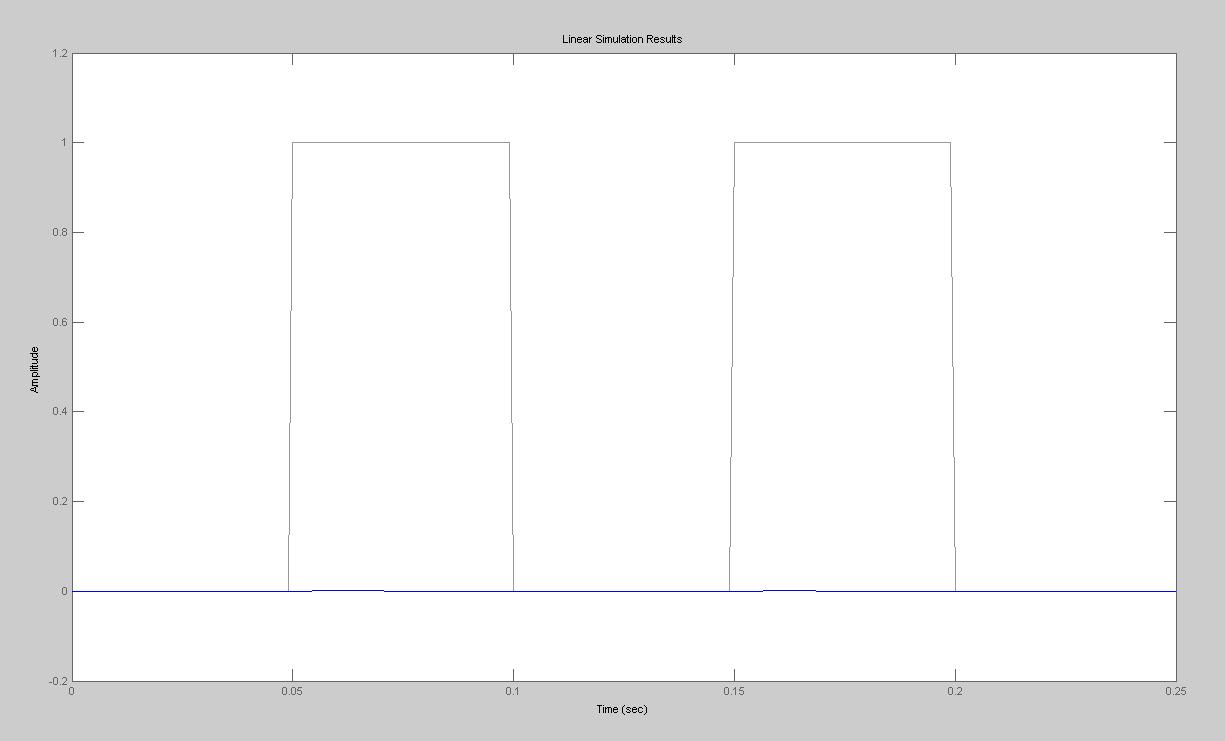
Proposal/LinearSim.jpg
