bpjagiel/Senior-Design/BOM/Bill Of Materials.xlsx

Bom
Parts | Material | Volume | Quanitity | Price | Pkg |  | Maker Bot
Bowl | ABS | 358698.64mm^3 | 1 | 143.15 | 1 |  | Uprint
Wheel | ABS | 63189.78mm^3 | 1 | 25.21 | 1 | All can change depending on machine matainace
Wheel inserts
50mm cap insert | ABS | 1663.21mm^3 | 6 | 0.52 | 1
25mm cap inserst | ABS | 2218.61mm^3 | 6 | 0.70 | 1
Dry wall screw insert | ABS | 1907.97mm^3 | 6 | 0.60 | 1
Dry wall anchor insert | ABS | 2146.67mm^3 | 6 | 0.68 | 1
4M nut insert | ABS | 2130.44mm^3 | 6 | 0.67 | 1
10M nut insert | ABS | 1681.11mm^3 | 6 | 0.53 | 1
Bowl inserts
50mm Cap left | ABS | 12667.02mm^3 | 1 | 0.66 | 1
50mm Cap center | ABS | 11461.32mm^3 | 1 | 0.60 | 1
50mm Cap Rt | ABS | 12667.02mm^3 | 1 | 0.66 | 1
25mm Cap left | ABS | 0 | 1 | 0 | 1
25mm Cap center | ABS | 0 | 1 | 0 | 1
25mm Cap Rt | ABS | 0 | 1 | 0 | 1
Dry screw left | ABS | 10933.53mm^3 | 1 | 0.57 | 1
Dry screw center | ABS | 9883.98mm^3 | 1 | 0.52 | 1
Dry screw Rt | ABS | 10933.53mm^3 | 1 | 0.57 | 1
Dry anchor left | ABS | 5466.77mm^3 | 1 | 0.29 | 1
Dry anchor center | ABS | 7131.05mm^3 | 1 | 0.37 | 1
Dry anchor Rt | ABS | 5466.77mm^3 | 1 | 0.29 | 1
4M nut left | ABS | 14978.35mm^3 | 1 | 0.79 | 1
4M nut center | ABS | 13564.43mm^3 | 1 | 1.36 | 1
4M nut Rt | ABS | 14978.35mm^3 | 1 | 0.79 | 1
10M nut left | ABS | 12089.19mm^3 | 1 | 0.63 | 1
10M nut center | ABS | 10935.54mm^3 | 1 | 0.57 | 1
10M nut Rt | ABS | 12089.19mm^3 | 1 | 0.63 | 1
Funnel | ABS | 66235.33mm^3 | 1 | 26.43 | 1
Slider | ABS | 147704.5mm^3 | 1 | 7.75 | 1
Presentantion bin | ABS | 89790mm^3 | 1 | 8.97 | 1
Motor shaft | ABS | 3754.46mm^3 | 1 | 1.50 | 1
Beams
90mm | Aluminum | 20mm 80/20 | 2 | 82.10 | 2 x 4 meters
110mm | Aluminum | 20mm 80/20 | 4
150mm | Aluminum | 20mm 80/20 | 2
240mm | Aluminum | 20mm 80/20 | 5
270mm | Aluminum | 20mm 80/20 | 5
350mm | Aluminum | 20mm 80/20 | 2
90 Angle Brackets | ABS | 2054mm^3 | 54 | 10.80 | 1
Flat Angle Plates | steel | Machined | 4 | 13.40 | .08x4inx24in plate
T- Plates | steel |  | 6
Funnel bracket | steel |  | 1
Frame Screw | steel | 5M Socket head cap screw | 150 | 16.96 | 2x 100
Trough nut | steel | 5M din 562 square nut | 158 | 9.12 | 2x 100
Bowl screw | steel | 5M Socket head cap screw 20mm | 4 | 4.65 | 25
Spring | steel | 2.36in/spring | 2 | 3.62
Funnel Screw | steel | 5M Button Head Cap Screw 40mm | 2 | 4.92 | 10
Motor Mount | Clamp |  | 1 | 5.06 | 1
Motor Mount Bolt | steel | 5M Black oxide socket head screw 65mm | 2 | 3.12 | 25
totals |  |  | 464 | 379.76
spring URL
http://www.mcmaster.com/#9664k49/=u4f2lb
Frame screw URL
http://www.mcmaster.com/#91239a220/=u4fkc7
Trough nut URL
http://www.instockfasteners.com/MyFA/mydescriptxhtmlpartid=33381
80/20 URL
http://www.grainger.com/search?searchQuery=80%2F20%20extrusion&suggestConfigId=6
Plate URL
http://www.mcmaster.com/#89015k192/=u4z7yg
Funnel Screw URL
http://www.mcmaster.com/#91239a240/=u51kat
Motor Mount URL
http://www.mcmaster.com/#3015t32/=u51l8a
Motor Mount Bolt URL
http://www.mcmaster.com/#91290a270/=u51mz3
Bowl Screw URL
http://www.mcmaster.com/#95263a388/=u5229i
