bpjagiel/Senior-Design/Group2/BOM/MasterBOM.xlsx

Description | P/N | Vendor | Price($) | Quantity | Website | Receipt? | Who purchased? | Date of Purchase | Reimbursement
#10 Drywall Screw | Cobra -172k | Lowe's | 11.98 | 70 | http://www.lowes.com/ | yes | Paul
#10 Drywall Anchor | " " | " " | " " | " " | " " | yes | Paul
4mm Hex Nut | 90592A011 | McMaster-Carr | 1.39 | 100 | http://www.mcmaster.com | YES | PAUL | 2014-10-17
10mm Hex Nut | 90592A024 | McMaster-Carr | 8.52 | 100 | http://www.mcmaster.com | YES | PAUL | 2014-10-17
4x50mm Socket Head Cap Screw | 91290A186 | McMaster-Carr | 10.46 | 50 | http://www.mcmaster.com | YES | PAUL | 2014-10-17
10x25mm Socket Head Cap Screw | 96144A256 | McMaster-Carr | 17.2 | 50 | http://www.mcmaster.com | YES | PAUL | 2014-10-17
Bowl |  |  | 143.15 | 358698.64mm^3
Wheel |  |  | 25.21 | 63189.78mm^3
Wheel inserts
50mm cap insert |  |  | 0.52 | 1663.21mm^3
25mm cap inserst |  |  | 0.7 | 2218.61mm^3
Dry wall screw insert |  |  | 0.6 | 1907.97mm^3
Dry wall anchor insert |  |  | 0.68 | 2146.67mm^3
4M nut insert |  |  | 0.67 | 2130.44mm^3
10M nut insert |  |  | 0.53 | 1681.11mm^3
Bowl inserts
50mm Cap left |  |  | 0.66 | 12667.02mm^3
50mm Cap center |  |  | 0.6 | 11461.32mm^3
50mm Cap Rt |  |  | 0.66 | 12667.02mm^3
25mm Cap left |  |  | 0 | 0
25mm Cap center |  |  | 0 | 0
25mm Cap Rt |  |  | 0 | 0
Dry screw left |  |  | 0.57 | 10933.53mm^3
Dry screw center |  |  | 0.52 | 9883.98mm^3
Dry screw Rt |  |  | 0.57 | 10933.53mm^3
Dry anchor left |  |  | 0.29 | 5466.77mm^3
Dry anchor center |  |  | 0.37 | 7131.05mm^3
Dry anchor Rt |  |  | 0.29 | 5466.77mm^3
4M nut left |  |  | 0.79 | 14978.35mm^3
4M nut center |  |  | 1.36 | 13564.43mm^3
4M nut Rt |  |  | 0.79 | 14978.35mm^3
10M nut left |  |  | 0.63 | 12089.19mm^3
10M nut center |  |  | 0.57 | 10935.54mm^3
10M nut Rt |  |  | 0.63 | 12089.19mm^3
Funnel |  |  | 26.43 | 66235.33mm^3
Slider |  |  | 7.75 | 147704.5mm^3
Presentantion bin |  |  | 8.97 | 89790mm^3
Motor shaft |  |  | 1.5 | 3754.46mm^3
90 Angle Brackets |  |  | 10.8 | 2054mm^3
80/20 20x20 mm extruder |  |  | 82.1 | 8m | http://www.grainger.com/search?searchQuery=80%2F20%20extrusion&suggestConfigId=6 | YES | PAUL | 2014-10-17
Flat Angle Plates |  |  | 13.4 | .08x4inx24in plate | http://www.mcmaster.com/#89015k192/=u4z7yg | YES | PAUL | 2014-10-17
T- Plates |  |  |  |  | http://www.mcmaster.com/#89015k192/=u4z7yg | YES | PAUL | 2014-10-17
Funnel bracket |  |  |  |  | http://www.mcmaster.com/#89015k192/=u4z7yg | YES | PAUL | 2014-10-17
Frame Screw (5M Socket head cap screw) |  |  | 16.96 | 150 | http://www.mcmaster.com/#91239a220/=u4fkc7 | YES | PAUL | 2014-10-17
Trough nut (5M din 562 square nut) |  |  | 9.12 | 200 | http://www.instockfasteners.com/MyFA/mydescriptxhtmlpartid=33381 | YES | PAUL | 2014-10-17 | X
Bowl screw (5M Socket head cap screw 20mm) |  |  | 4.65 | 4 | http://www.mcmaster.com/#95263a388/=u5229i | YES | PAUL | 2014-10-17
Return Spring (2.36in spring) |  |  | 3.62 | 2 | http://www.mcmaster.com/#9664k49/=u4f2lb | YES | PAUL | 2014-10-17
Funnel Screw (5M Button Head Cap Screw 40mm) |  |  | 4.92 | 2 | http://www.mcmaster.com/#91239a240/=u51kat | YES | PAUL | 2014-10-17
Motor Mount |  |  | 5.06 | 1 | http://www.mcmaster.com/#3015t32/=u51l8a | YES | PAUL | 2014-10-17
Motor Mount Bolt (5M Black oxide socket head screw 65mm) |  |  | 3.12 | 2 | http://www.mcmaster.com/#91290a270/=u51mz3 | YES | PAUL | 2014-10-17
DC Gearmotor | GM8224S020 | AlliedElectric | 171.65 | 1 | http://www.alliedelec.com/search/productdetail.aspx?SKU=70050424 | yes | Paul | 2014-10-17 | X
TRIMMER - 6MM ROUND; SINGLE-TURN; CERMET; 1K OHMS | 3306F-1-102 | AlliedElectric | 3.36 | 8 | http://www.alliedelec.com | Yes | Paul | 2014-10-17 | X
PHOTODIODE | OP290A | Mouser | 7.5 | 10 | http://www.mouser.com | Yes | Paul | 2014-10-20
PHOTO TRANSISTOR TO-18 | OP803SL | AlliedElectric | 20.83 | 10 | http://www.alliedelec.com | Yes | Paul | 2014-10-17 | X
Switch, Slide, SUB Miniature, TOP ACTUATED, SPDT, ON-NONE-ON | SS12SDP2 | AlliedElectric | 1.14 | 1 | http://www.alliedelec.com | Yes | Paul | 2014-10-17 | X
Indicator, Pnl-Mnt; LED; Green; 30mcd; T-1; 60deg; Chrome; 105mW; 0.512In; 150mA; -40degC; 8 | SSI-LXR3612GD-150 | AlliedElectric | 3.6 | 2 | http://www.alliedelec.com | Yes | Paul | 2014-10-17 | X
Motor encoder | RB-And-40 | RobotShop | 63.64 | 1 | http://www.robotshop.com/en/encoder-package-toughbox.html | yes | Paul | 2014-10-17 | X
Indicator, Pnl-Mnt; LED; Red; 30mcdAxial; 0.915In; T-1; 2V; 6InWire Lead; Chrome | SSI-LXR1612ID-150 | AlliedElectric | 5.02 | 2 | http://www.alliedelec.com | Yes | Paul | 2014-10-17 | X
 |  | Total Cost: | 642.41
