bpjagiel/Senior-Design/Fastener 2-D Drawing files/FastenerData.xlsx

Type | P/N | Vendor | Material | Volume(cu mm) | Density(kg/cu mm) | Mass(kg) | Price($) | Quantity | Website
#10 Drywall Screw | Cobra -172k | Menard's | Steel | 2786 | 7.85x10^-6 | 22x10^-3 | 11.98 | 70 | http://www.menards.com/main/search.html?&search=2340235&queryType=storeItems
#10 Drywall Anchor | " " | " " | Polyethylene | 1916 | 9.41x10^-7 | 1.8x10^-3 | " " | " " | " "
4mm Hex Nut | 90592A011 | McMaster-Carr | Steel | 83 | 7.85x10^-6 | 0.652x10^-3 | 1.39 | 100 | http://www.mcmaster.com
10mm Hex Nut | 90592A024 | McMaster-Carr | Steel | 1188 | 7.85x10^-6 | 9.33x10^-3 | 8.52 | 100 | http://www.mcmaster.com
4x50mm Socket Head Cap Screw | 91290A186 | McMaster-Carr | Steel | 754 | 7.85x10^-6 | 6x10^-3 | 10.46 | 50 | http://www.mcmaster.com
10x25mm Socket Head Cap Screw | 96144A256 | McMaster-Carr | Steel | 3471 | 7.85x10^-6 | 27.2x10^-3 | 17.2 | 50 | http://www.mcmaster.com
 |  |  |  |  |  | Total: | 49.55
