bpjagiel/Senior-Design/Proposal/Parts Counter CAD 1.PNG

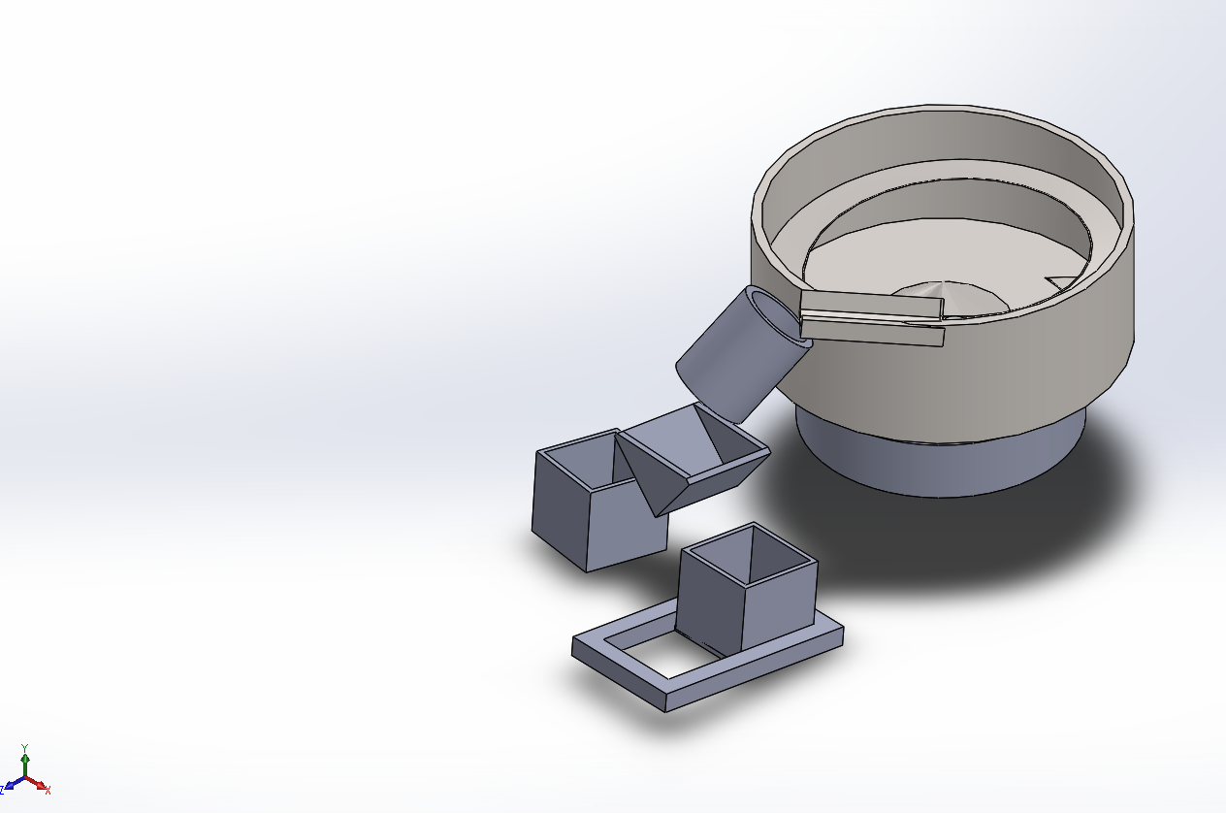
Proposal/Parts Counter CAD 1.PNG
