bpjagiel/Senior-Design/MechanicalDesigns/disk of 10mm.SLDPRT

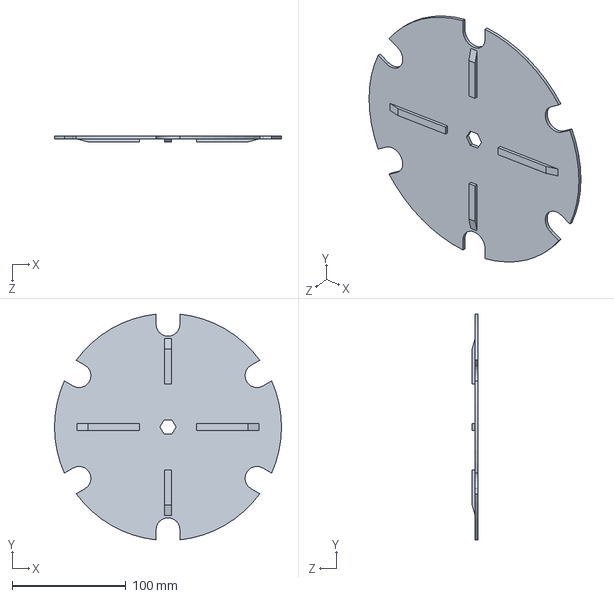
[picture p197: CAD file, 2014-11-21]
MechanicalDesigns/disk of 10mm.SLDPRT
200.0 x 198.9 x 5.00 mm
