bpjagiel/Senior-Design/model for inserts.STL

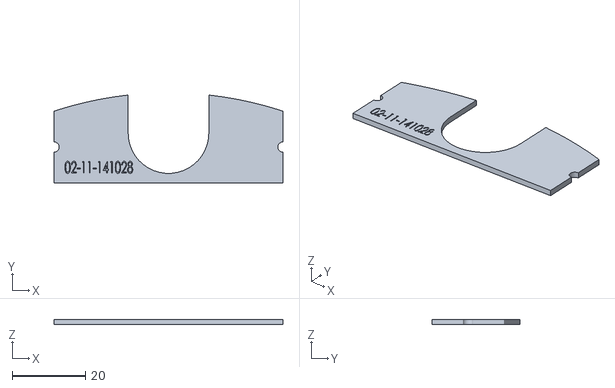
[picture p198: CAD file, 2014-11-06]
model for inserts.STL
62.5 x 24.0 x 1.50
