bpjagiel/Senior-Design/MechanicalDesigns/disk of 4mm.SLDPRT

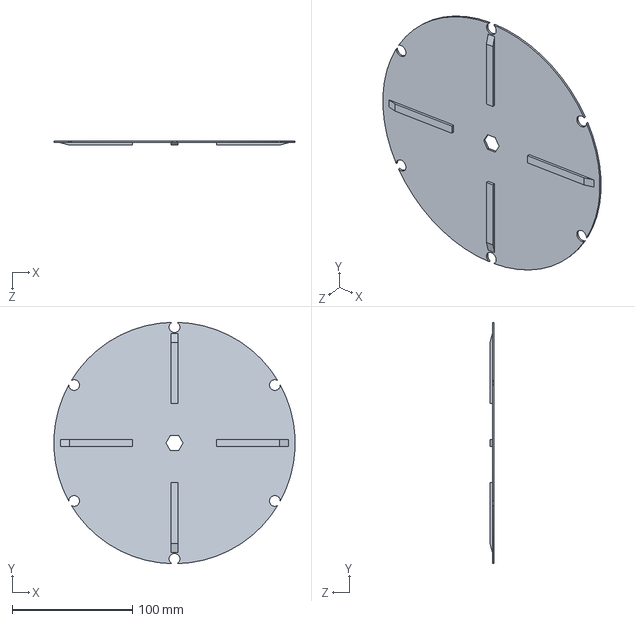
[picture p199: CAD file, 2014-11-21]
MechanicalDesigns/disk of 4mm.SLDPRT
200.7 x 201.0 x 3.50 mm
