bpjagiel/Senior-Design/MechanicalDesigns/disk of anchor.SLDPRT

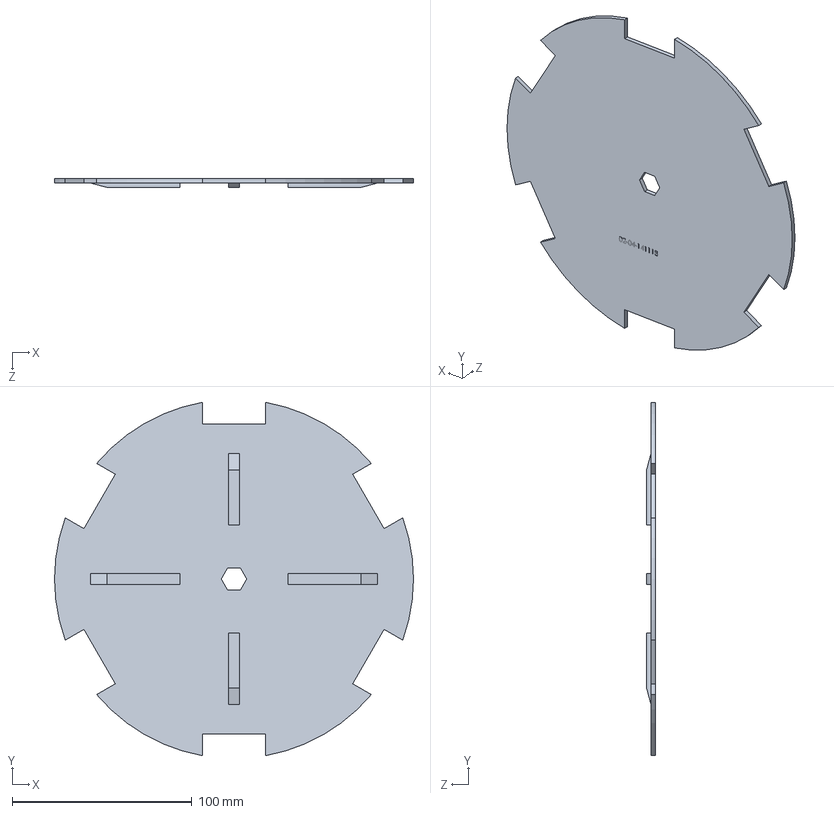
[picture p200: CAD file, 2014-11-21]
MechanicalDesigns/disk of anchor.SLDPRT
200.0 x 196.9 x 5.00 mm
