bpjagiel/Senior-Design/MechanicalDesigns/25mm.STL

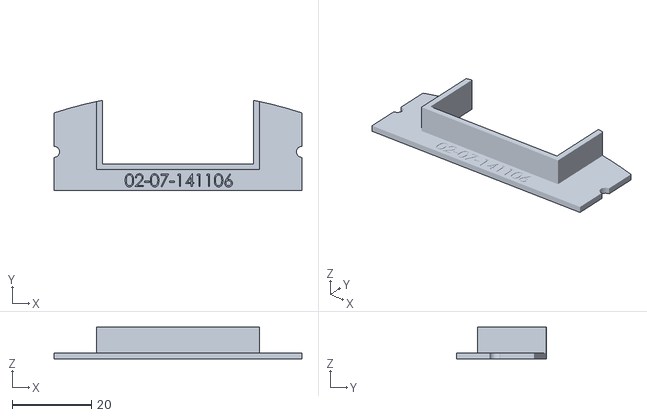
[picture p201: CAD file, 2014-11-19]
MechanicalDesigns/25mm.STL
62.5 x 22.8 x 8.00
