bpjagiel/Senior-Design/MechanicalDesigns/anchor.STL

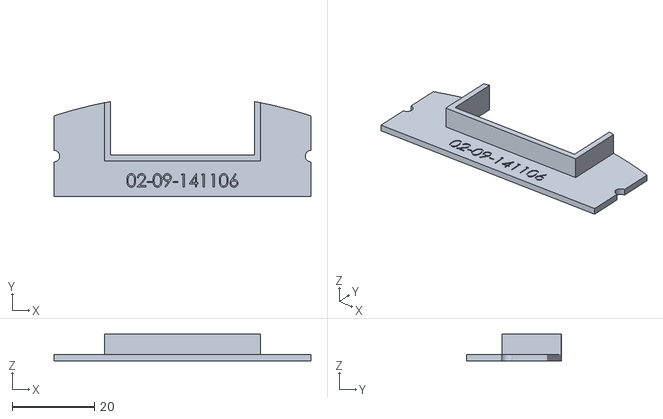
[picture p202: CAD file, 2014-11-19]
MechanicalDesigns/anchor.STL
62.5 x 23.1 x 6.50
