bpjagiel/Senior-Design/MechanicalDesigns/50mm.STL

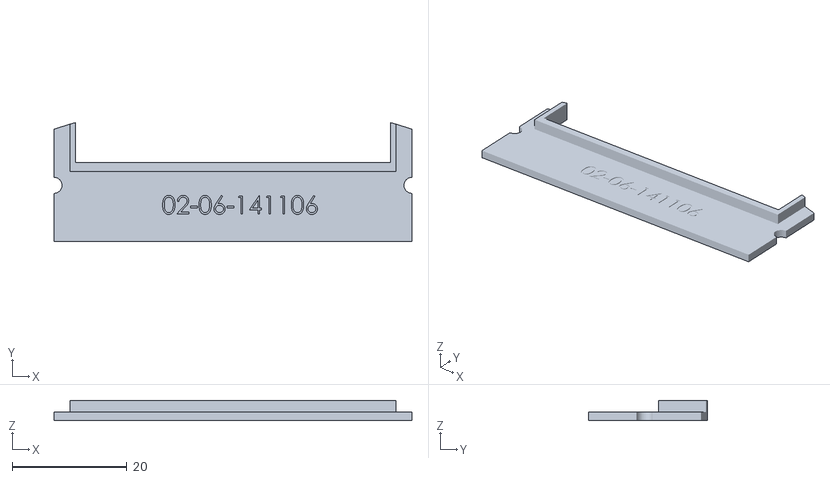
[picture p203: CAD file, 2014-11-19]
MechanicalDesigns/50mm.STL
62.5 x 20.8 x 3.50
