bpjagiel/Senior-Design/MechanicalDesigns/10mmNutRingAll.stl

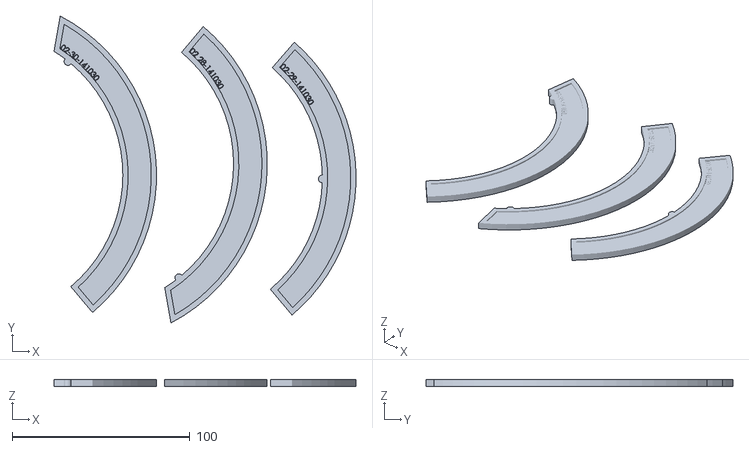
[picture p204: CAD file, 2014-11-19]
MechanicalDesigns/10mmNutRingAll.stl
170.0 x 172.8 x 4.00
