bpjagiel/Senior-Design/MechanicalDesigns/Print1.stl

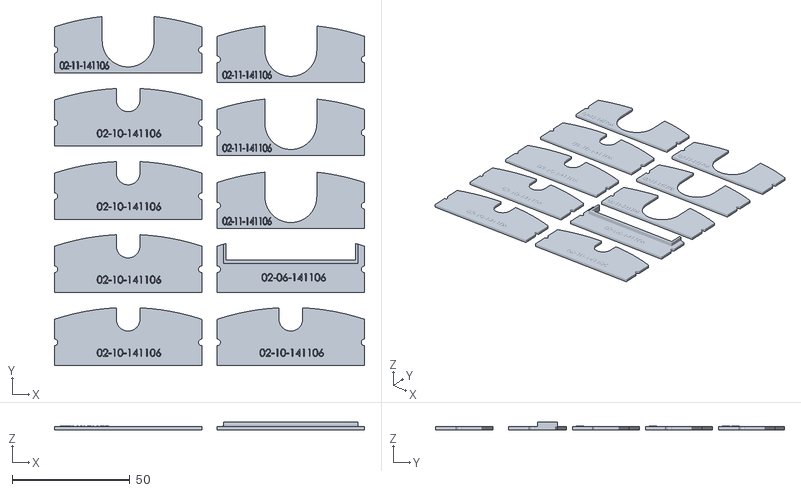
[picture p205: CAD file, 2014-11-19]
MechanicalDesigns/Print1.stl
131.5 x 148.0 x 3.50
