bpjagiel/Senior-Design/MechanicalDesigns/right ring for drywall.STL

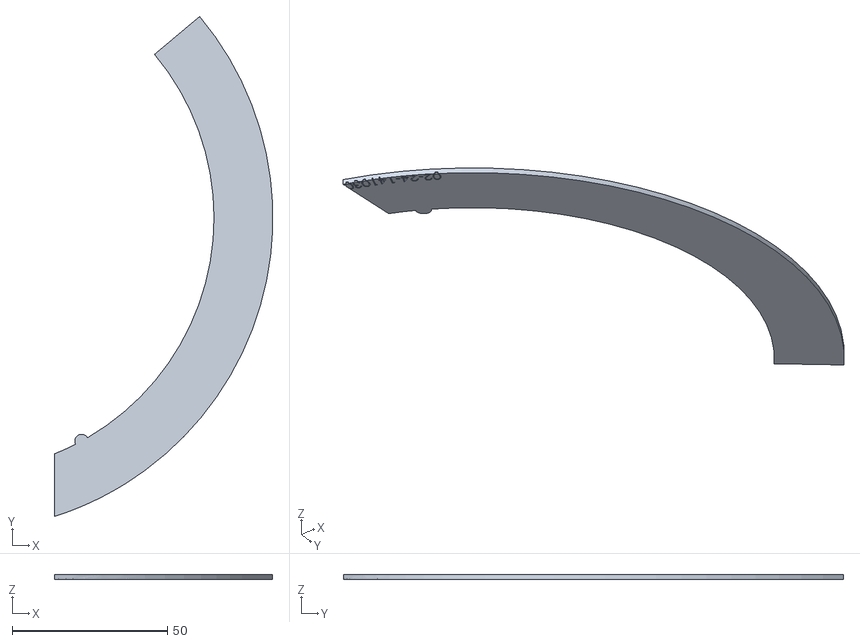
[picture p206: CAD file, 2014-11-19]
MechanicalDesigns/right ring for drywall.STL
70.4 x 161.2 x 1.50
