bpjagiel/Senior-Design/MechanicalDesigns/4mmNutBowlInsert.stl

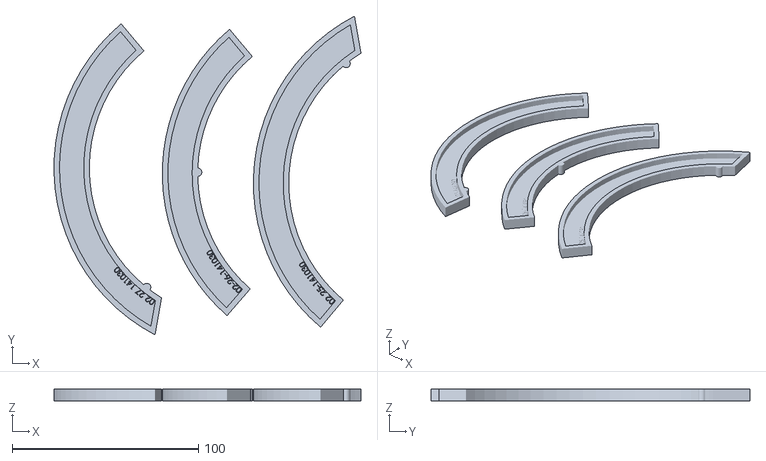
[picture p207: CAD file, 2014-11-19]
MechanicalDesigns/4mmNutBowlInsert.stl
164.7 x 171.0 x 6.50
