bpjagiel/Senior-Design/MechanicalDesigns/25mm_new.STL

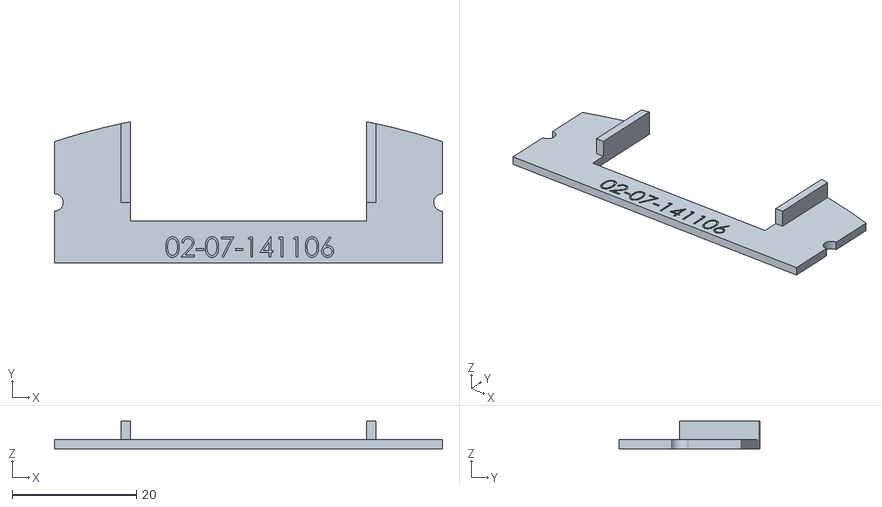
[picture p208: CAD file, 2014-11-19]
MechanicalDesigns/25mm_new.STL
62.5 x 22.8 x 4.50
