bpjagiel/Senior-Design/MechanicalDesigns/50mmBowlRing.stl

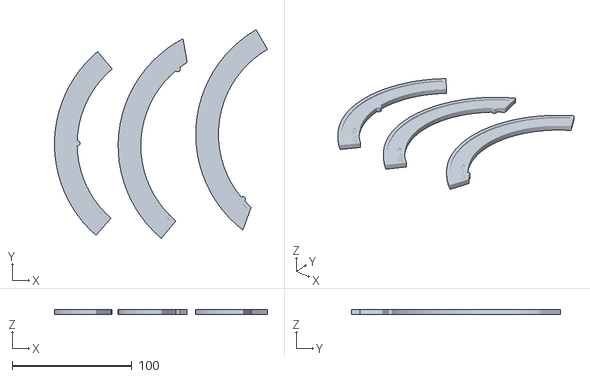
[picture p209: CAD file, 2014-11-19]
MechanicalDesigns/50mmBowlRing.stl
178.0 x 174.4 x 4.50
