bpjagiel/Senior-Design/MechanicalDesigns/center ring for drywall.STL

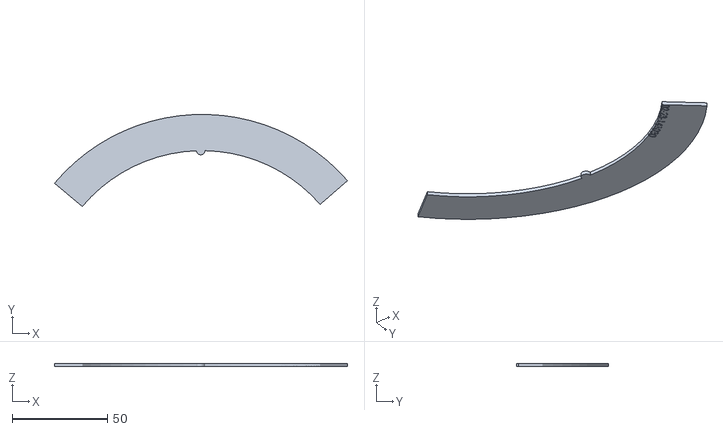
[picture p210: CAD file, 2014-11-19]
MechanicalDesigns/center ring for drywall.STL
153.6 x 48.2 x 1.50
