bpjagiel/Senior-Design/MechanicalDesigns/drywallBowlInsert.stl

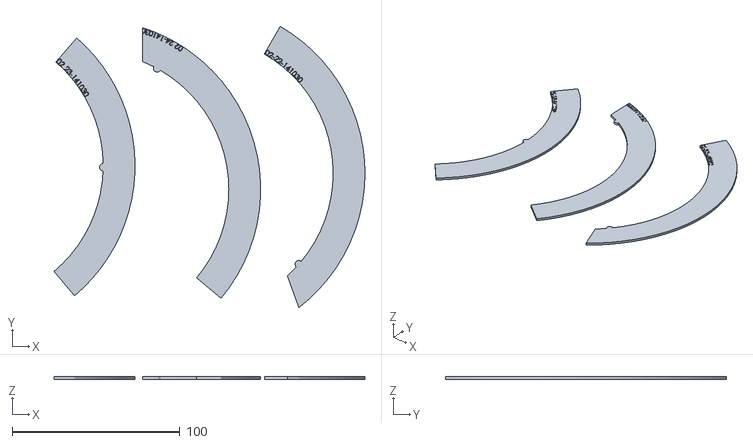
[picture p211: CAD file, 2014-11-19]
MechanicalDesigns/drywallBowlInsert.stl
185.2 x 167.5 x 1.50
