bpjagiel/Senior-Design/MechanicalDesigns/4mm_RevB.STL

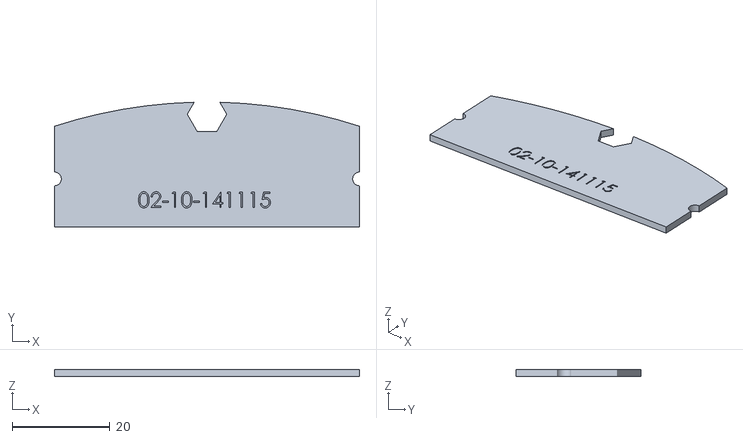
[picture p212: CAD file, 2014-11-19]
MechanicalDesigns/4mm_RevB.STL
62.5 x 25.5 x 1.50
