bpjagiel/Senior-Design/MechanicalDesigns/10mm_RevB.STL

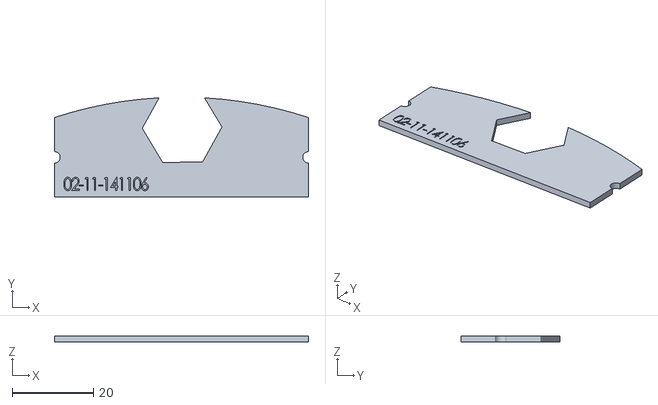
[picture p213: CAD file, 2014-11-19]
MechanicalDesigns/10mm_RevB.STL
62.5 x 24.5 x 1.50
