bpjagiel/Senior-Design/MechanicalDesigns/10mm.STL

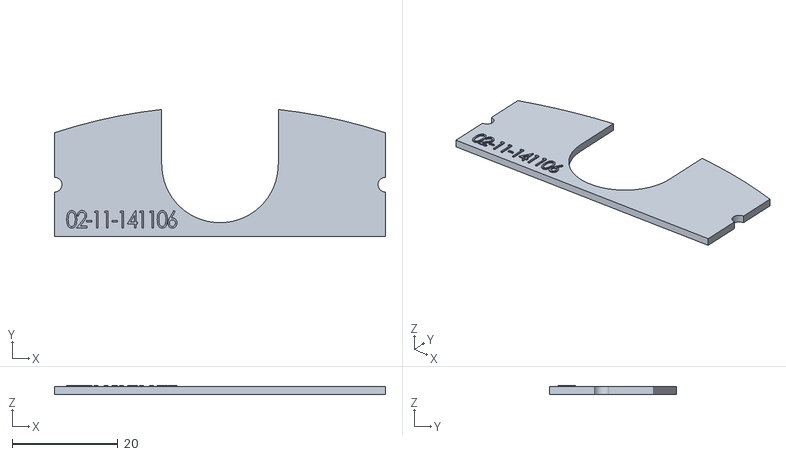
[picture p214: CAD file, 2014-11-19]
MechanicalDesigns/10mm.STL
62.5 x 24.0 x 1.70
