bpjagiel/Senior-Design/MechanicalDesigns/4mm.STL

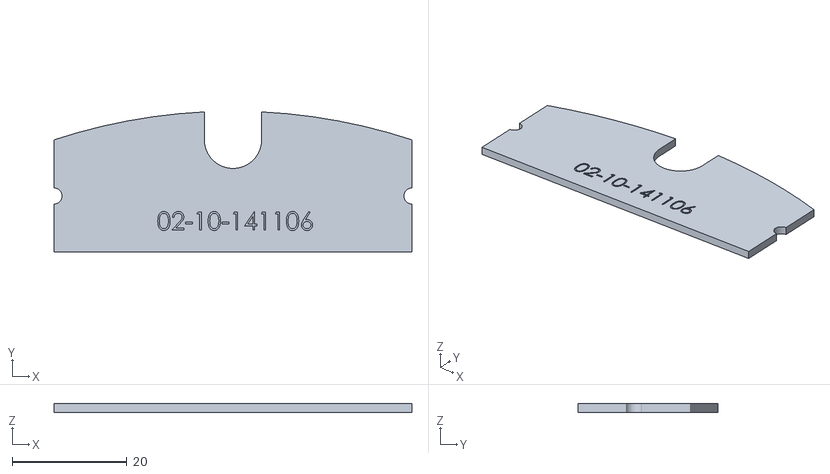
[picture p215: CAD file, 2014-11-19]
MechanicalDesigns/4mm.STL
62.5 x 24.5 x 1.50
