bpjagiel/Senior-Design/MechanicalDesigns/newInserts.stl

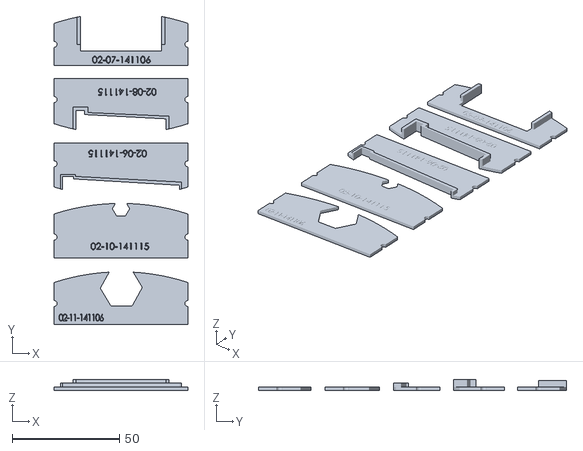
[picture p216: CAD file, 2014-11-19]
MechanicalDesigns/newInserts.stl
62.5 x 143.8 x 5.00
