bpjagiel/Senior-Design/MechanicalDesigns/50mm_RevB.STL

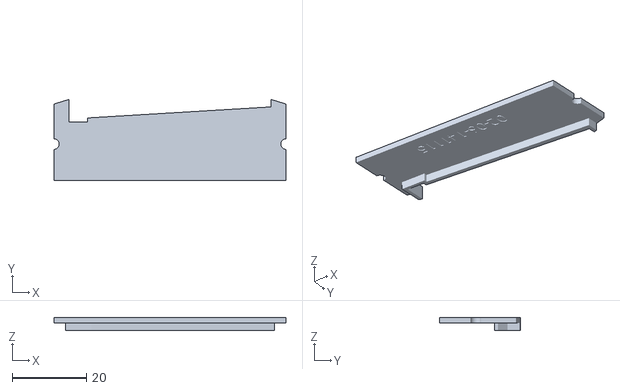
[picture p217: CAD file, 2014-11-19]
MechanicalDesigns/50mm_RevB.STL
62.5 x 21.8 x 3.50
