bpjagiel/Senior-Design/MechanicalDesigns/disk 04.STL

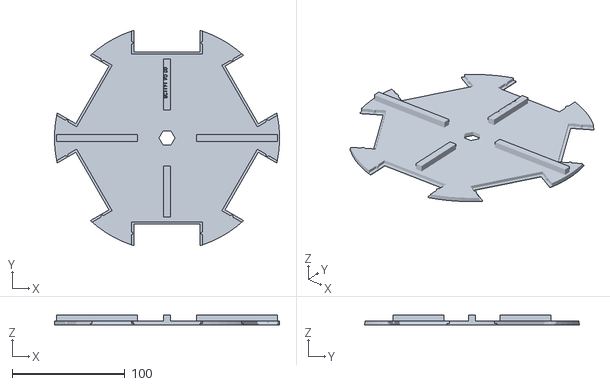
[picture p218: CAD file, 2014-11-08]
MechanicalDesigns/disk 04.STL
199.8 x 191.1 x 8.50
