bpjagiel/Senior-Design/MechanicalDesigns/Presentation Bin.STL

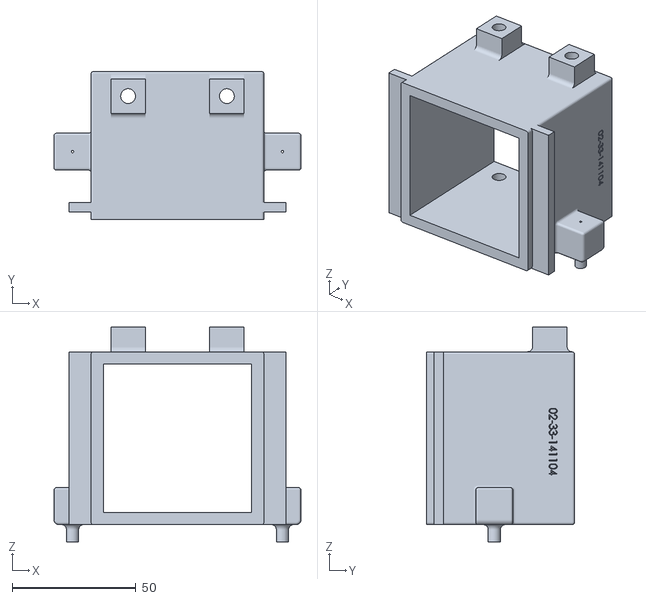
[picture p219: CAD file, 2014-11-08]
MechanicalDesigns/Presentation Bin.STL
100.0 x 60.0 x 87.0
