bpjagiel/Senior-Design/MechanicalDesigns/shaft.STL

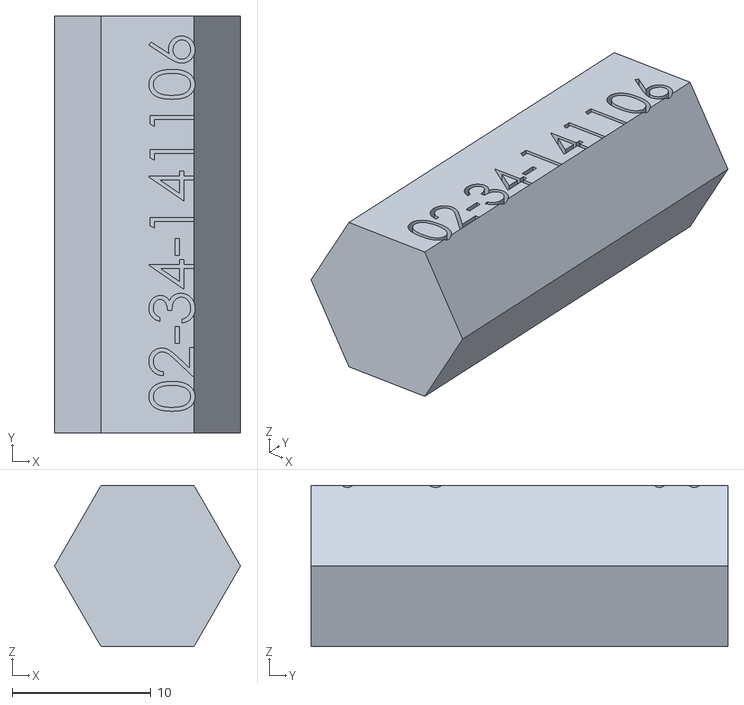
[picture p220: CAD file, 2014-11-08]
MechanicalDesigns/shaft.STL
13.4 x 30.0 x 11.6
