bpjagiel/Senior-Design/MechanicalDesigns/RightSideCaseRightSideUp.stl

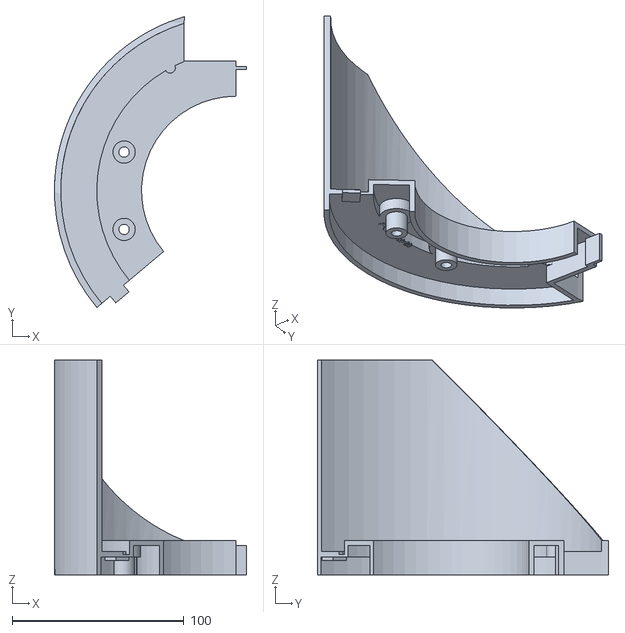
[picture p221: CAD file, 2014-11-06]
MechanicalDesigns/RightSideCaseRightSideUp.stl
111.8 x 169.3 x 125.0
