bpjagiel/Senior-Design/MechanicalDesigns/drywall.STL

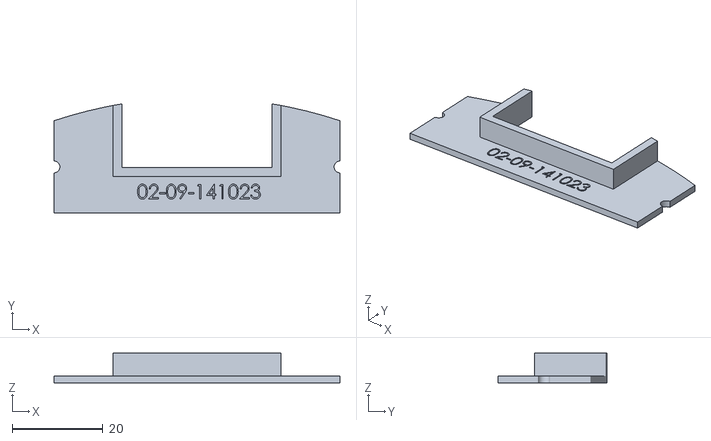
[picture p222: CAD file, 2014-11-06]
MechanicalDesigns/drywall.STL
63.0 x 24.1 x 6.50
