bpjagiel/Senior-Design/MechanicalDesigns/10mmMultiple.stl

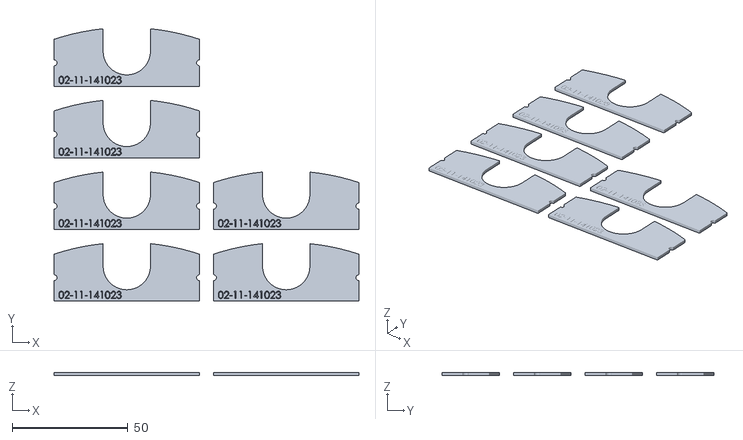
[picture p223: CAD file, 2014-11-06]
MechanicalDesigns/10mmMultiple.stl
132.0 x 117.9 x 1.50
