bpjagiel/Senior-Design/MechanicalDesigns/LeftSideOfCaseRightSideUp.stl

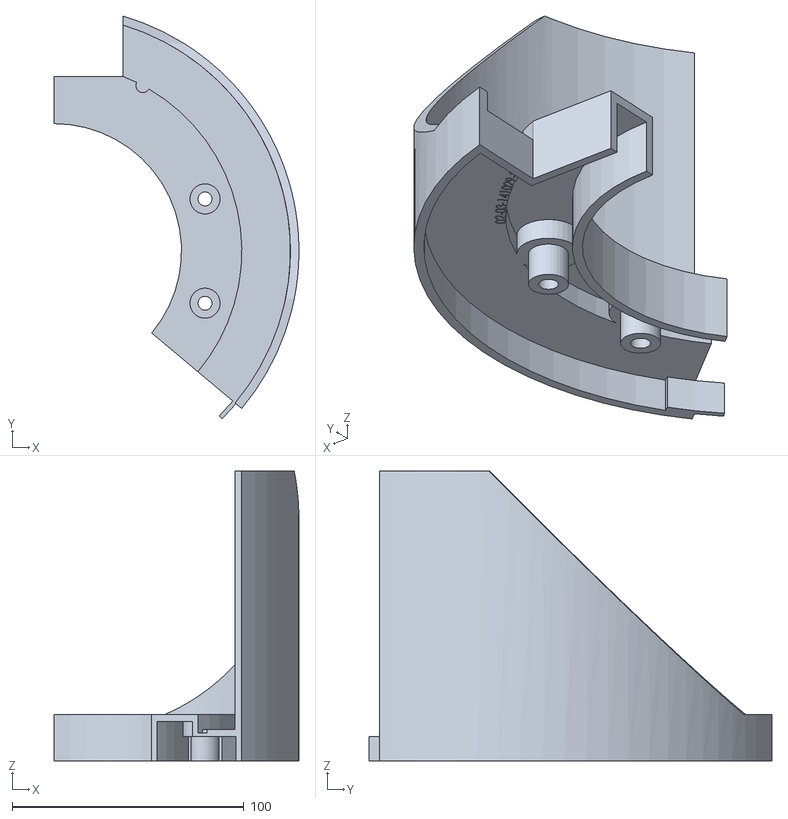
[picture p224: CAD file, 2014-11-06]
MechanicalDesigns/LeftSideOfCaseRightSideUp.stl
105.7 x 173.9 x 125.0
