bpjagiel/Senior-Design/MechanicalDesigns/final funnel.STL

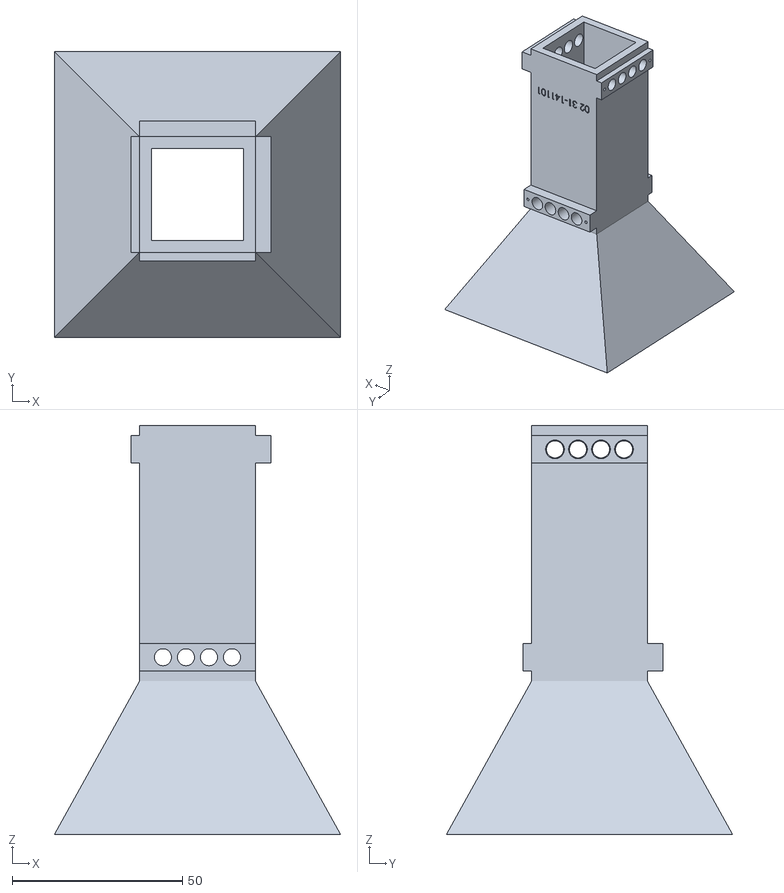
[picture p225: CAD file, 2014-11-06]
MechanicalDesigns/final funnel.STL
84.0 x 84.0 x 120.0
