bpjagiel/Senior-Design/MechanicalDesigns/center new Case Feeder Bowl.SLDPRT

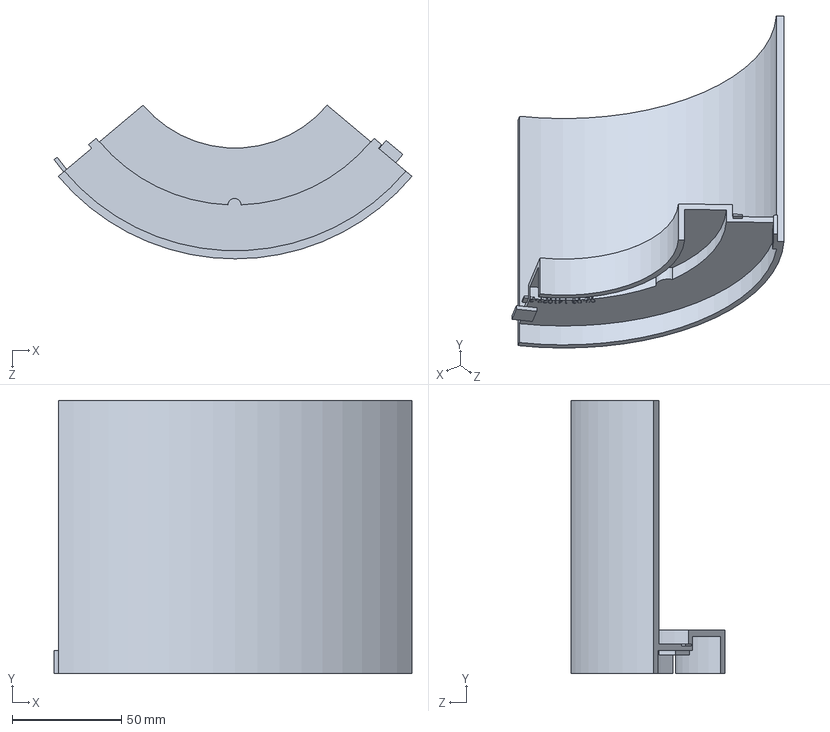
[picture p226: CAD file, 2014-11-06]
MechanicalDesigns/center new Case Feeder Bowl.SLDPRT
163.9 x 125.0 x 70.3 mm
