bpjagiel/Senior-Design/MechanicalDesigns/4mm nutCopies.stl

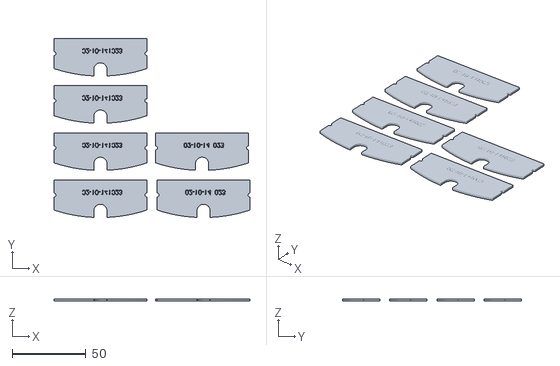
[picture p227: CAD file, 2014-10-23]
MechanicalDesigns/4mm nutCopies.stl
133.0 x 121.3 x 1.50
