bpjagiel/Senior-Design/MechanicalDesigns/test1.stl

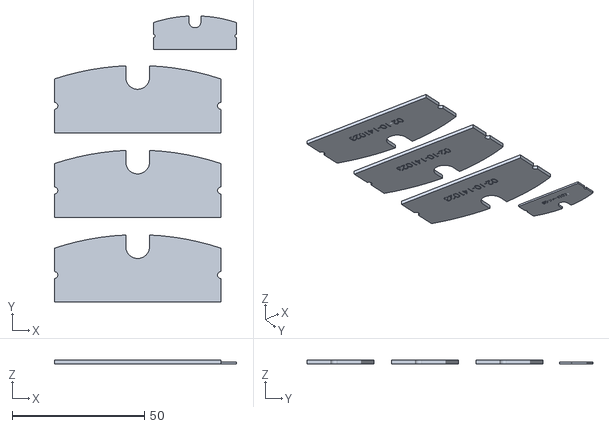
[picture p228: CAD file, 2014-10-23]
MechanicalDesigns/test1.stl
68.9 x 108.2 x 1.50
