bpjagiel/Senior-Design/(list of files, cad)

Other CAD files:
Motor/MotorSpecs/Ametek-PITTMAN-8224-12_0V-G35A-WF-60_5-0000-0000.dwg
MechanicalDesigns/left ring for drywall.STL
MechanicalDesigns/right new Case Feeder Bowl.SLDPRT
MechanicalDesigns/left new Case Feeder Bowl.SLDPRT
MechanicalDesigns/CenterCaseFeederRightSideUp.stl
MechanicalDesigns/10mm nut.STL
MechanicalDesigns/25mm screw.STL
MechanicalDesigns/4mm nut.STL
MechanicalDesigns/50mm screw.STL
MechanicalDesigns/PresentationBin.stl
MechanicalDesigns/anchor screw.STL
MechanicalDesigns/center new Case Feeder Bowl.STL
MechanicalDesigns/center ring for 10mm nut.STL
MechanicalDesigns/center ring for 4mm nut.STL
MechanicalDesigns/center ring for 50mm screw.STL
MechanicalDesigns/center ring for drywallscrew.STL
MechanicalDesigns/disk of 10mm.STL
MechanicalDesigns/disk of 25mm screw.SLDPRT
MechanicalDesigns/disk of 25mm screw.STL
MechanicalDesigns/disk of 4mm.STL
MechanicalDesigns/disk of 50mm screw.SLDPRT
MechanicalDesigns/disk of 50mm screw.STL
MechanicalDesigns/disk of anchor screw.SLDPRT
MechanicalDesigns/disk of anchor screw.STL
MechanicalDesigns/disk of anchor.STL
MechanicalDesigns/drywall screw.STL
MechanicalDesigns/drywallScrewBowlInsert.stl
MechanicalDesigns/drywallScrewMultiple.stl
MechanicalDesigns/left new Case Feeder Bowl.STL
MechanicalDesigns/left ring for 10mm nut.STL
MechanicalDesigns/left ring for 4mm nut.STL
MechanicalDesigns/left ring for 50mm screw.STL
MechanicalDesigns/left ring for drywallscrew.STL
MechanicalDesigns/right new Case Feeder Bowl.STL
MechanicalDesigns/right ring for 10mm nut.STL
MechanicalDesigns/right ring for 4mm nut.STL
MechanicalDesigns/right ring for 50mm screw.STL
MechanicalDesigns/right ring for drywallscrew.STL
MechanicalDesigns/screw.STL
