bpjagiel/Senior-Design/Motor/Motor_Simulation_and_Verification.pptx

## Motor Simulation and Verifcation

Control System Team
Paul Kruchko
Bryan Jagielo

## Goals

- Determine if motor speed is within specs for application
- Determine power circuit specs (peak current draw)

## Exact Mathematical Model

Yildiz, A. (2012). Electrical equivalent circuit based modeling and analysis of direct current motors.

## Exact Equivalent Circuit Model

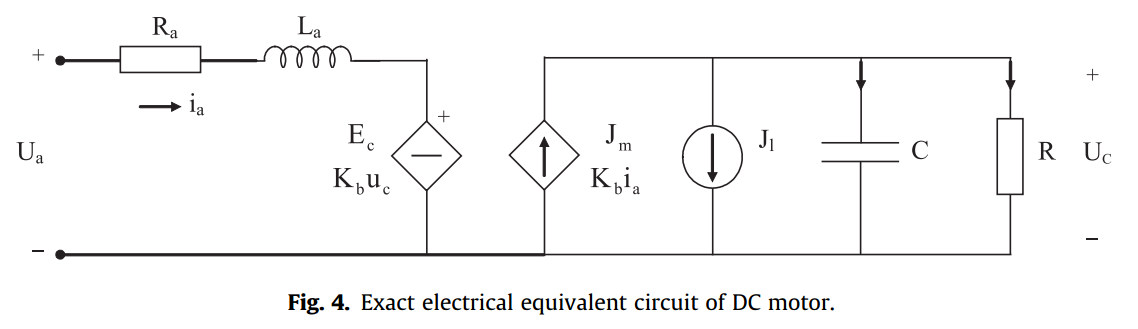
[picture p229: figure]

Yildiz, A. (2012). Electrical equivalent circuit based modeling and analysis of direct current motors.

## Exact Equivalent Circuit Model

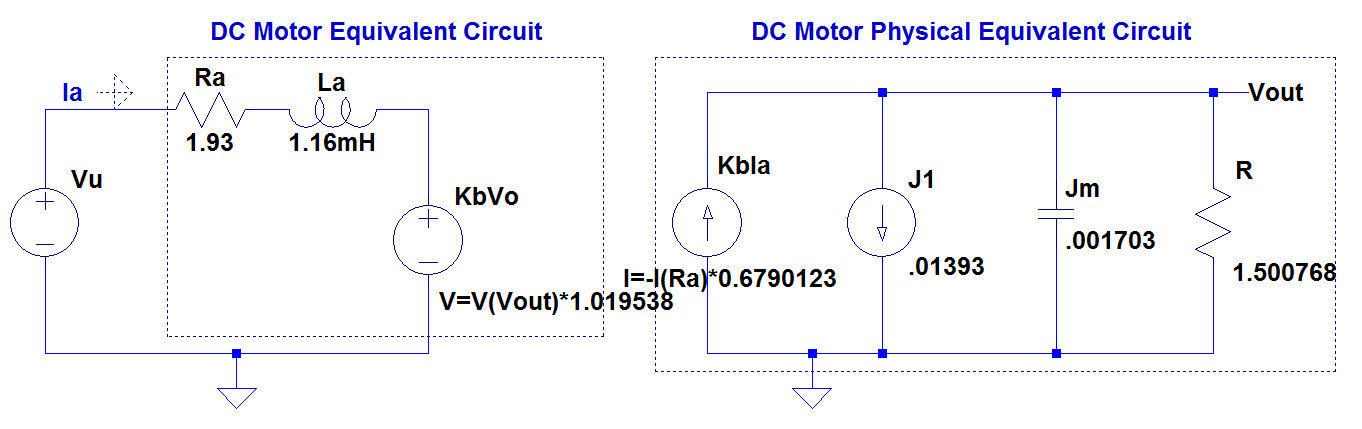
[picture p230: figure]

## Angular Velocity with Step Response

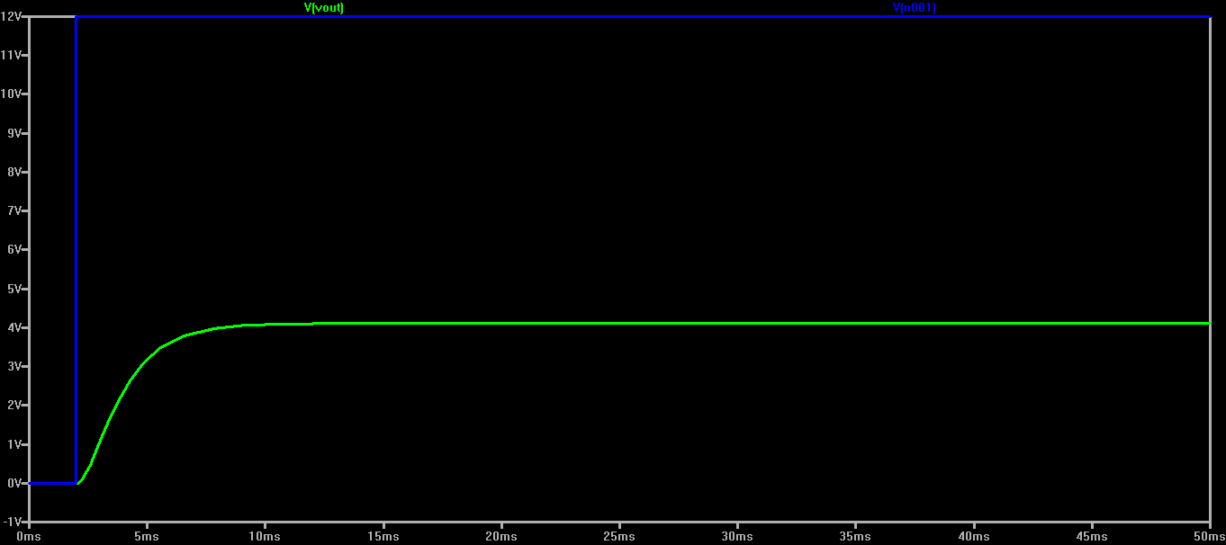
[picture p231: figure]

## Current With Step Response

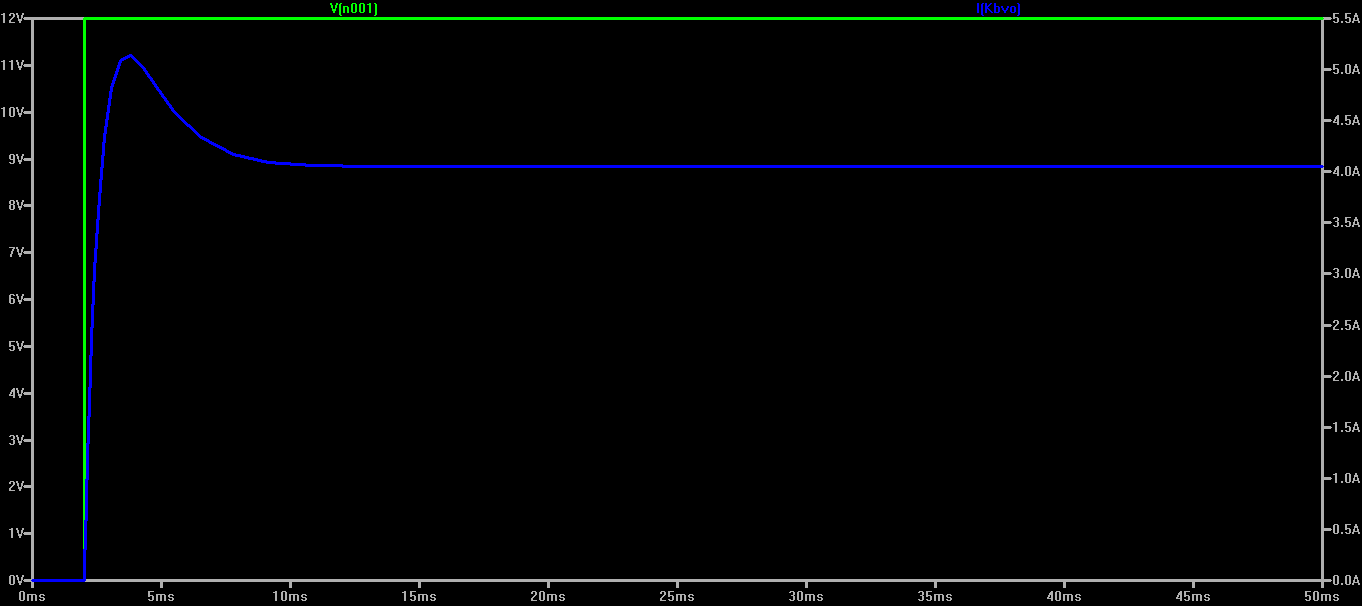
[picture p232: figure]

## Response with 50% Duty

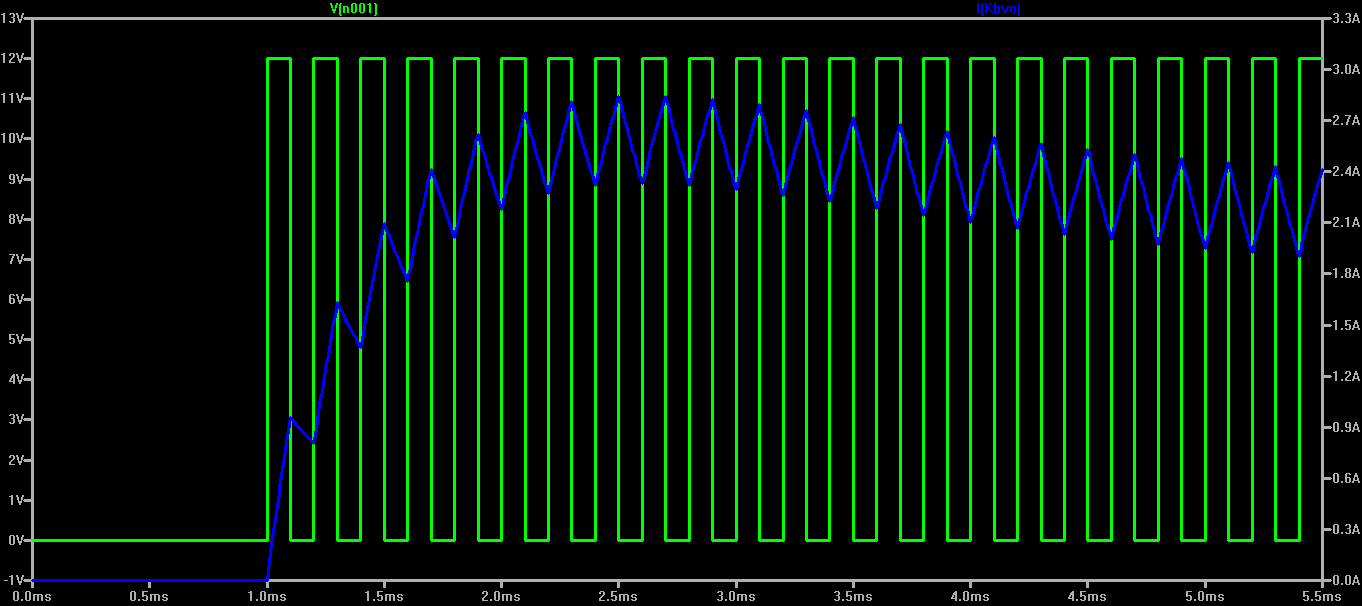
[picture p233: figure]

## Steady State Mathematical Model

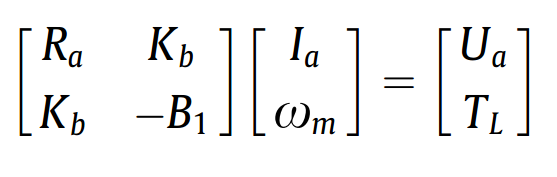
[picture p234: figure]

Yildiz, A. (2012). Electrical equivalent circuit based modeling and analysis of direct current motors.

## Steady State Equivalent Circuit

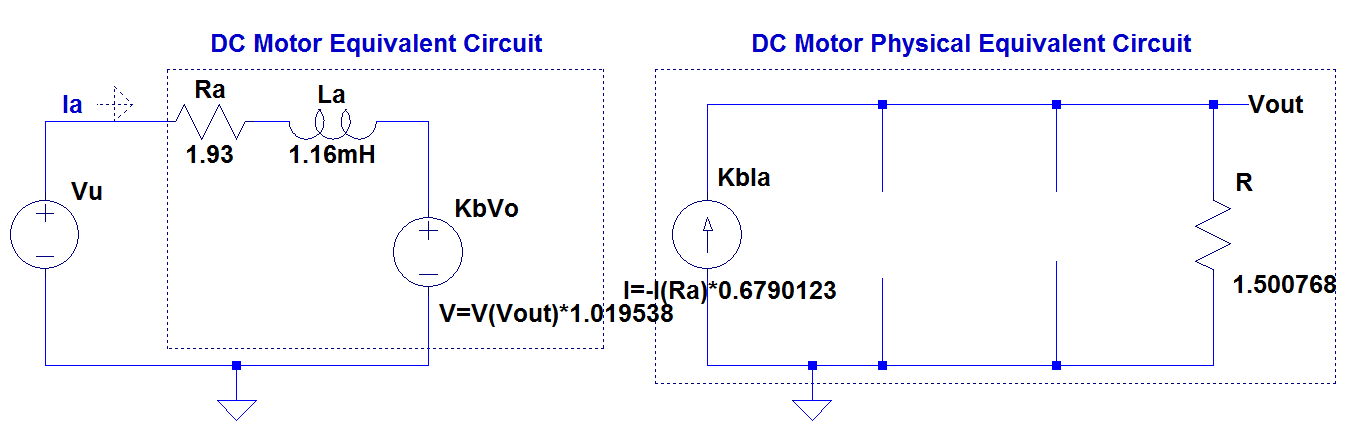
[picture p235: figure]

## Steady State Current

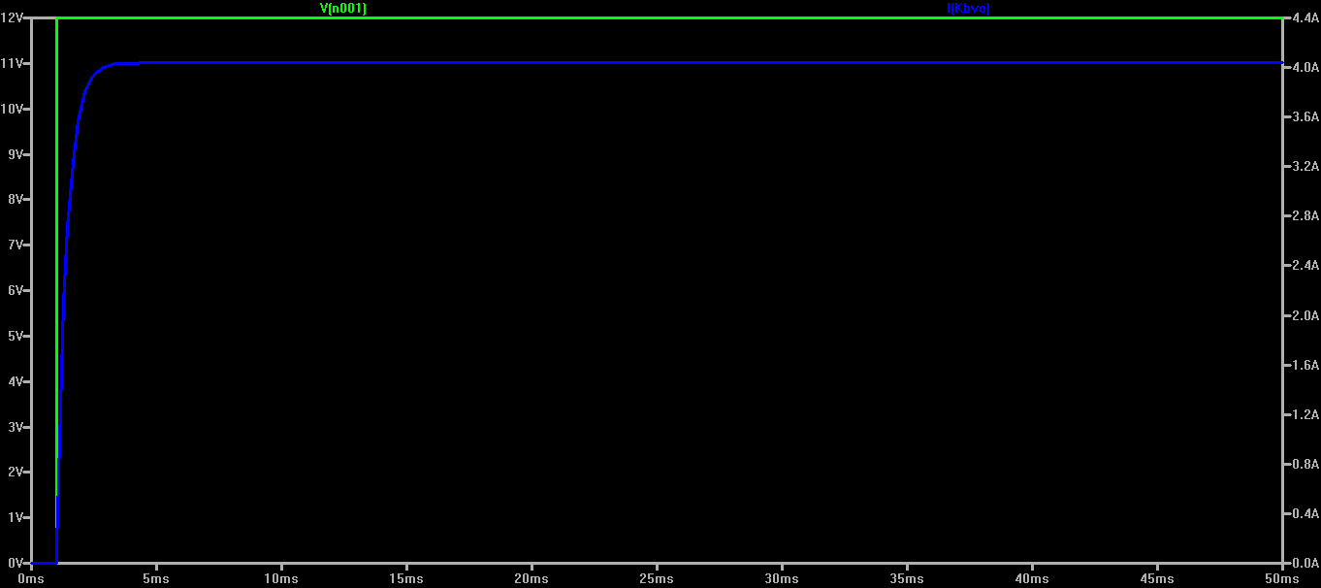
[picture p236: figure]

## Steady State Angular Velocity

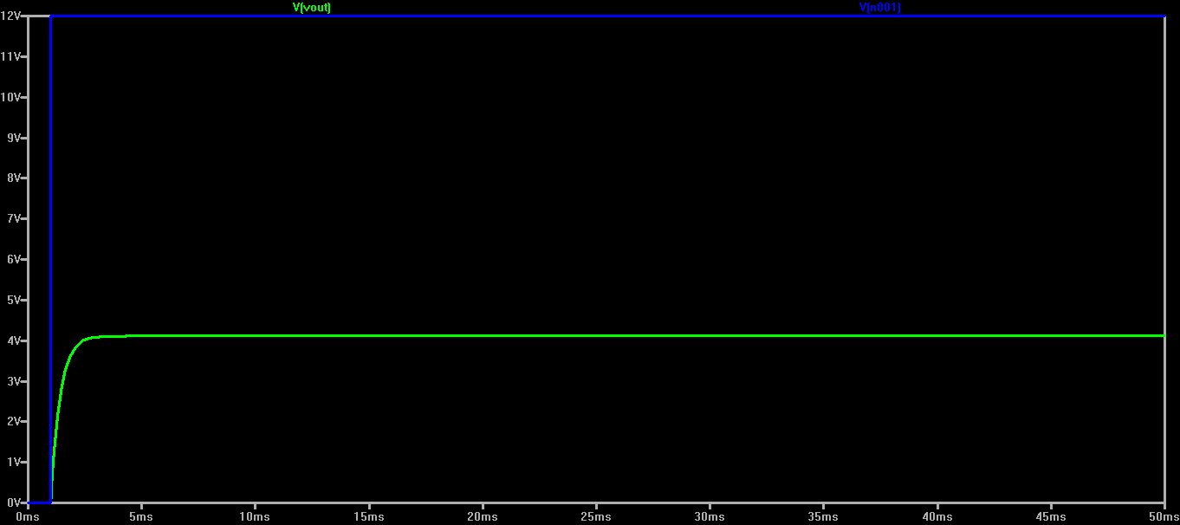
[picture p237: figure]

## Simulation Results

- Peak current in motor drive circuit ≈ 5.3 A
- Simulated angular velocity at steady state
- ≈ 38.2 rpm (within spec)
- Simulated angular velocity at 50% duty
- ≈ 19.09 rpm (within spec)
- Results confirmed with datasheet
