bpjagiel/Senior-Design/Motor/ViscousDampingExperimentalResults.xlsx

Part Type | # of Parts | Iteration | Time (s) | SS current (uA)
4 mm nut | 10 | 1 | 7.74 | 0.06
 | 11 | 2 | 8.97 | 0.06
 | 12 | 3 | 13.97 | 0.06
10 mm nut | 6 | 1 | 4.87 | 0.25
 | 6 | 2 | 5.68 | 0.24
 | 6 | 3 | 3.95 | 0.20
10x25 mm screw | 6 | 1 | 6.89 | 0.24
 | 6 | 2 | 5.71 | 0.21
 | 6 | 3 | 9.31 | 0.18
4x50mm screw | 6 | 1 | 16.68 | 0.09
 | 6 | 2 | 11.02 | 0.08
 | 6 | 3 | 6.85 | 0.07
Drywall screw | 6 | 1 | 11.20 | 0.10
 | 6 | 2 | 10.54 | 0.10
 | 6 | 3 | 9.53 | 0.10
Drywall anchor | 6 | 1 | 5.54 | 0.07
 | 6 | 2 | 6.80 | 0.07
 | 6 | 3 | 5.23 | 0.07
