bpjagiel/Senior-Design/Fastener 2-D Drawing files/90093A400.pdf

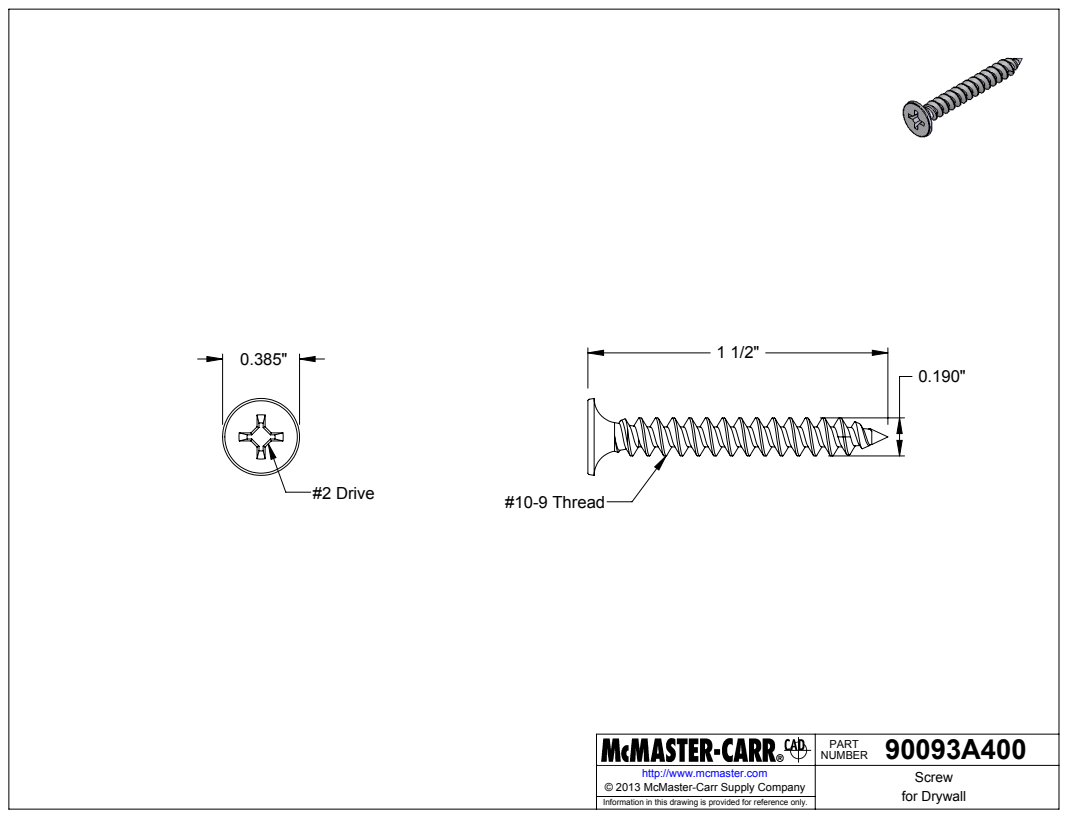
[picture p246: page 1]
#2 Drive; #10-9 Thread

90093A400 PART NUMBER

http://www.mcmaster.com | Screw for Drywall © 2013 McMaster-Carr Supply Company

Information in this drawing is provided for reference only.
