bpjagiel/Senior-Design/Fastener 2-D Drawing files/90592A011.pdf

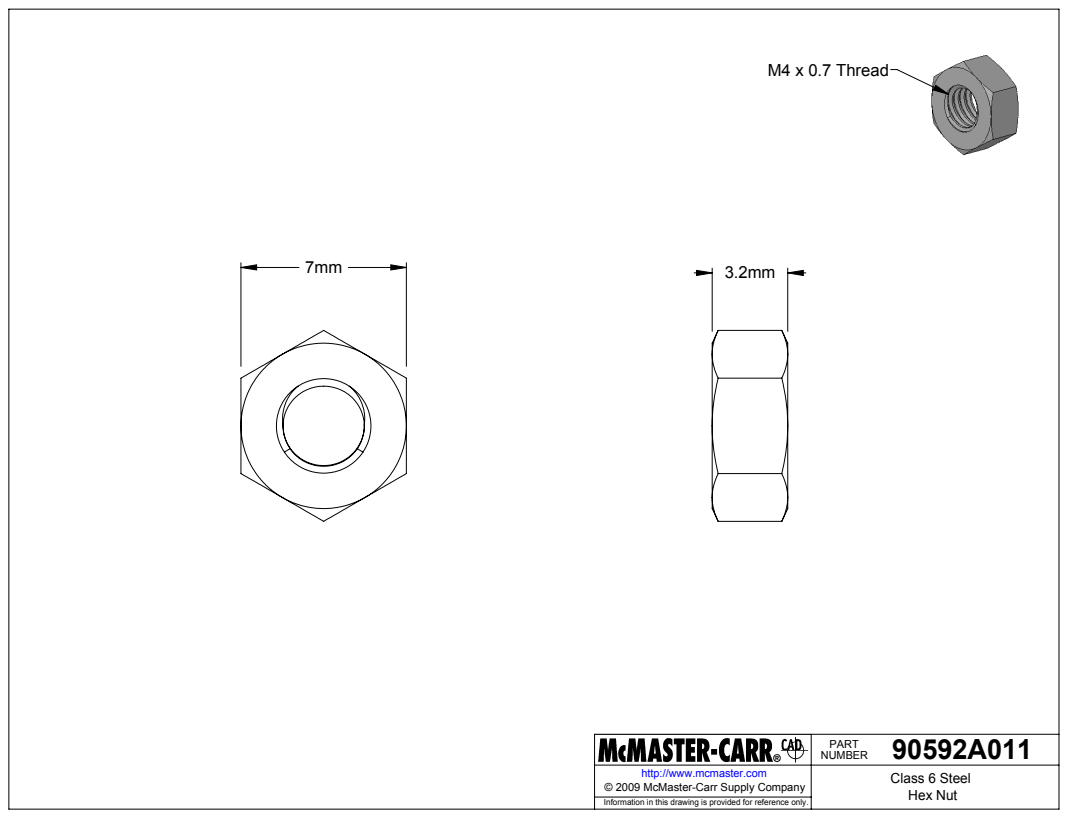
[picture p247: page 1]
M4 x 0.7 Thread

90592A011 PART NUMBER

http://www.mcmaster.com | Class 6 Steel Hex Nut © 2009 McMaster-Carr Supply Company

Information in this drawing is provided for reference only.
