bpjagiel/Senior-Design/Fastener 2-D Drawing files/90592A024.pdf

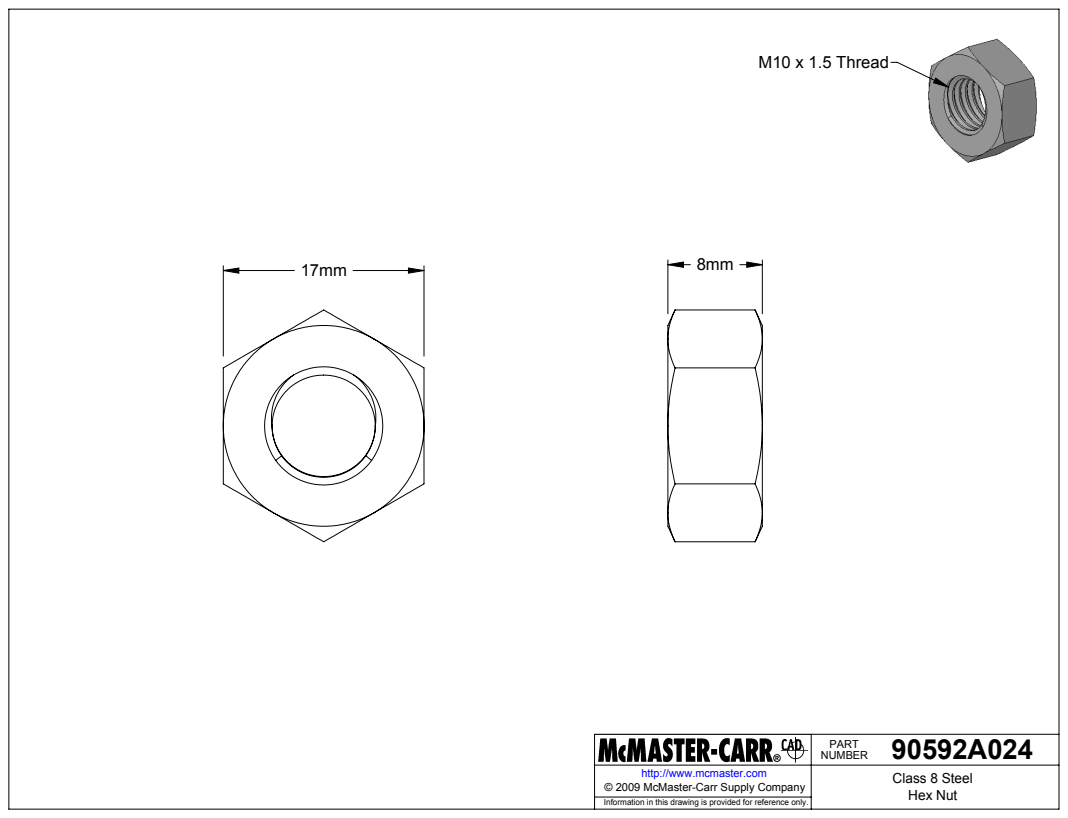
[picture p248: page 1]
M10 x 1.5 Thread

90592A024 PART NUMBER

http://www.mcmaster.com | Class 8 Steel Hex Nut © 2009 McMaster-Carr Supply Company

Information in this drawing is provided for reference only.
