bpjagiel/Senior-Design/Fastener 2-D Drawing files/91290A186.pdf

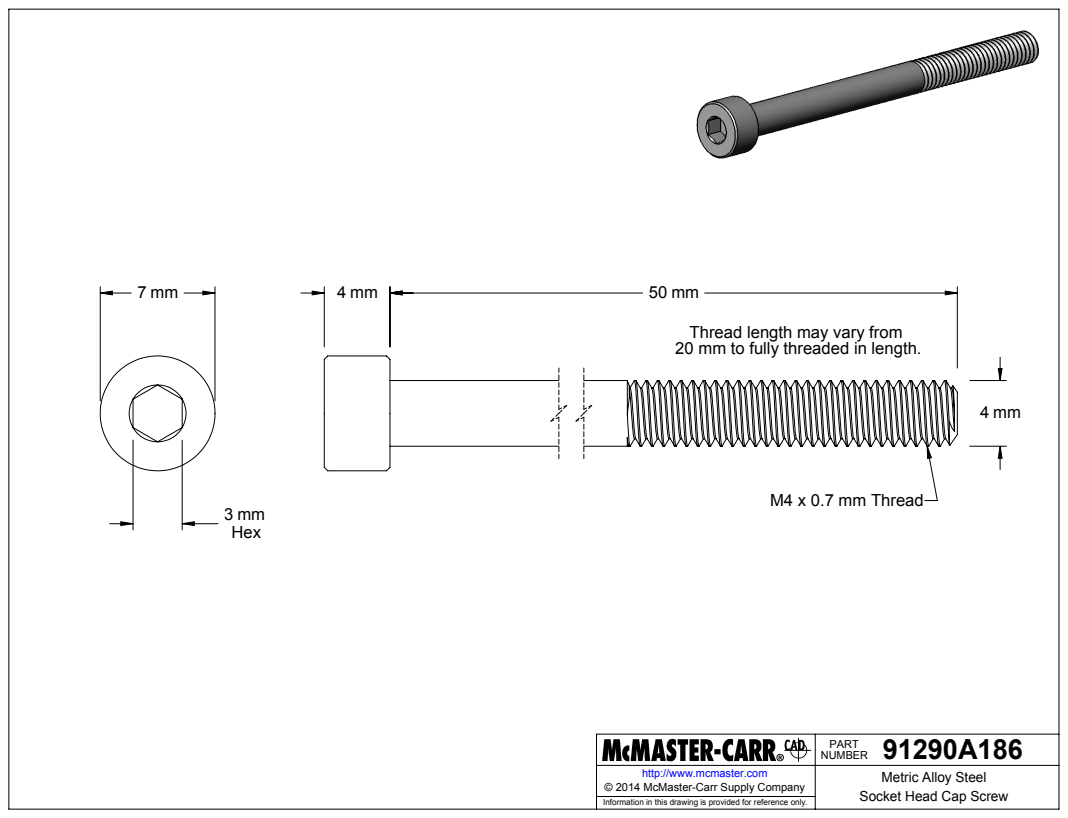
[picture p249: page 1]
M4 x 0.7 mm Thread

Thread length may vary from
20 mm to fully threaded in length.

91290A186 PART NUMBER

http://www.mcmaster.com | Metric Alloy Steel Socket Head Cap Screw © 2014 McMaster-Carr Supply Company

Information in this drawing is provided for reference only.
