bpjagiel/Senior-Design/Motor/EncoderSpecs/ACS712 Low Current Sensor Board v14.pdf

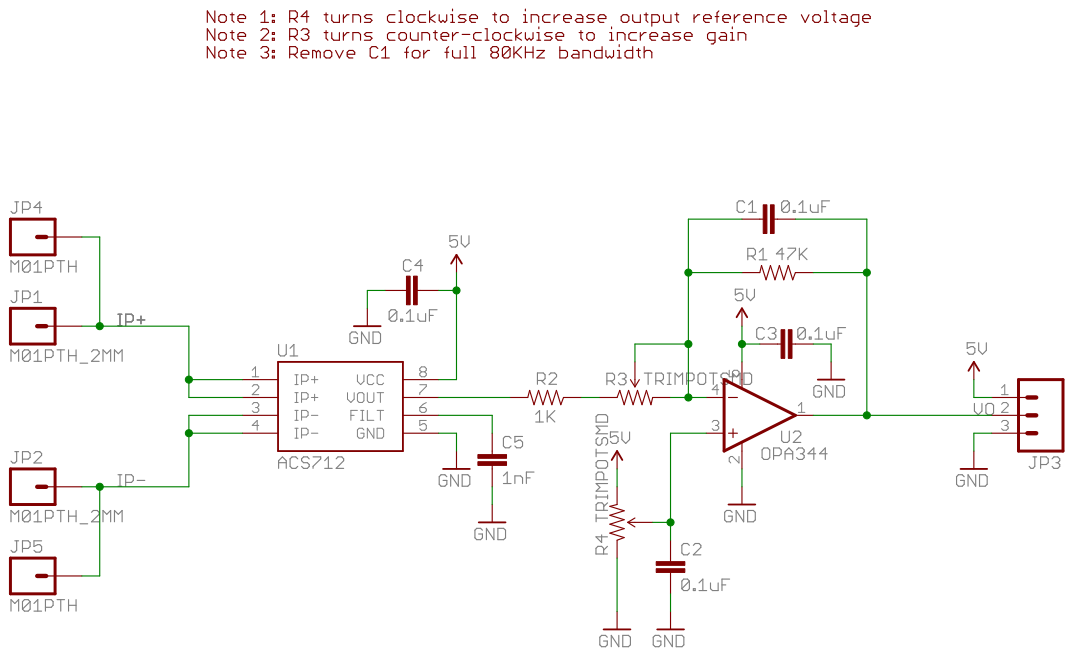
[picture p250: page 1]
