bpjagiel/Senior-Design/Motor/MotorModel2.asc

C1: cap; .01393
Jm: cap; .001703
KbIa: bi; I=-I(Ra)*0.6790123
KbVo: bv; V=V(Vout)*1.019538
La: ind; 1.16mH
R: res; 1.500768
Ra: res; 1.93
Vu: voltage; PULSE(0V 12V 2ms 1ns 1ns)
Named nets: 0, Vout
Ia
DC Motor Equivalent Circuit
DC Motor Physical Equivalent Circuit
.tran 0 .1s 0 .001s startup
