bpjagiel/Senior-Design/PowerCircuits/SolenoidDriver.asc

D1: diode
D2: diode
L1: ind; 400mH
L2: ind; 400mH
M1: nmos
R1: res; 120
R2: res; 120
V1: voltage; 24V
V2: voltage; PULSE(0 5 0 0 0 .05 .1 10)
Named nets: 0
.tran 1
