bpjagiel/Senior-Design/(commit log)

2014-09-11 testing push with sample file
2014-09-11 Removed sample file
2014-09-18 Administrative data and 2D fastener drawings
    [ContactsMatrix.xlsx]
2014-09-19 New
    New documents
    [ContactsMatrix.xlsx, FastenerData.xlsx, RequirementsMatrix.xlsx, SeniorDesignContacts.xlsx]
2014-09-21 Changes made as of 21 September
    rearranged folder structure and added new folders.
    [ArchitectureTeamMeeting_20140921.xlsx, ContactsMatrix.xlsx, FastenerData.xlsx, SeniorDesignContacts.xlsx]
2014-09-22 Added solenoid driver circuit schematic
2014-09-23 Proposal and Timeline
    Creation of project timeline, our proposal both in word and powerpoint
    form along with some supporting documentation
    [ProjectTimeLine.xls]
2014-09-25 Update to URLs
    Includes link to the two case feeder videos.
2014-10-02 Recent updates and additions
    [Arduino_MEGA_2560-Rev3.brd, Arduino_MEGA_2560-Rev3.sch, MasterBOM.xlsx]
2014-10-04 Sensor data sheets and application notes
    Uploaded data sheets for IR LED and photo transistor along with
    application notes from Fairchild Semiconductor on designing a photo
    interrupt amplifier circuit
    [MasterBOM.xlsx]
2014-10-07 Recent updates
    Uploaded Steven's spring constant calculations, DC motor application
    notes and the weekly update status slides
2014-10-13 Motor stuff
    Example motor model and motor engineering application notes
2014-10-14 Mechanical materials BOM and updated motor specs
    [Bill Of Materials.xlsx]
2014-10-14 Motor Circuit Models and MOSFET Datasheets
2014-10-19 Motor Model Derivation and Control System Sim.
2014-10-23 Updated BOM and Mechanical designs
    [4mm nut.STL, 4mm nutCopies.stl, Ametek-PITTMAN-8224-12_0V-G35A-WF-60_5-0000-0000.dwg, MasterBOM.xlsx, test1.stl]
2014-11-06 Mechanical designs and motor specs
    Lots of stuff
    [10mm nut.STL, 10mmMultiple.stl, 25mm screw.STL, 50mm screw.STL, CenterCaseFeederRightSideUp.stl, LeftSideOfCaseRightSideUp.stl, Moment of Inertia.xlsx, RightSideCaseRightSideUp.stl]
2014-11-06 H-bridge motor driver
    sales receipt for h-brige motor driver
2014-11-07 Motor driver
    schematics and drawings of motor driver
    [Moment of Inertia.xlsx]
2014-11-08 Mechanical design updates
    Redesign: Disk, presentation bin. Includes shaft
    [Presentation Bin.STL, PresentationBin.stl, disk 04.STL, shaft.STL]
2014-11-09 Order for second motor
2014-11-19 stuff
    more stuff
    [10mm.STL, 10mmNutRingAll.stl, 10mm_RevB.STL, 25mm.STL, 25mm_new.STL, 4mm.STL, 4mmNutBowlInsert.stl, 4mm_RevB.STL]
2014-11-21 Updated agitator plate
    Updated designs for plate and agitator
    [disk of 10mm.SLDPRT, disk of 10mm.STL, disk of 25mm screw.SLDPRT, disk of 25mm screw.STL, disk of 4mm.SLDPRT, disk of 4mm.STL, disk of 50mm screw.SLDPRT, disk of 50mm screw.STL]
2014-11-22 Added initial software sketch
    Contains framework for LCD and Button Controller
2014-11-24 parts counter firmware
    LCD, sensor, led indicators, buttons, and motor control integrated.
2014-12-08 Final report
    Individual contributions to final report and motor sim without PID
    [Moment of Inertia.xlsx]
2014-12-08 Bryan's motor sim
    simulation of motor in SS with PID
2014-12-31 changes
    some more changes
    [MasterBOM.xlsx, ViscousDampingExperimentalResults.xlsx]
